SKNMIPSA/IE-TANK-KIT-1/HW/POWER/_DOCUMENTATION/imgs/produkcja_v11_5.jpg

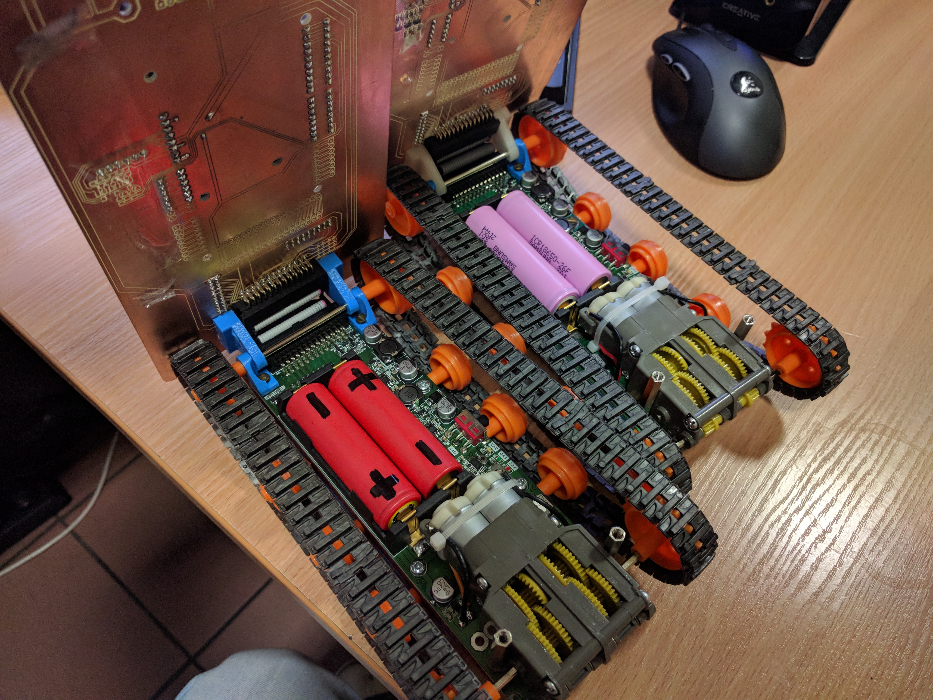
HW/POWER/_DOCUMENTATION/imgs/produkcja_v11_5.jpg
