SKNMIPSA/IE-TANK-KIT-1/HW/POWER/_DOCUMENTATION/imgs/prototyp_v12_2.jpg

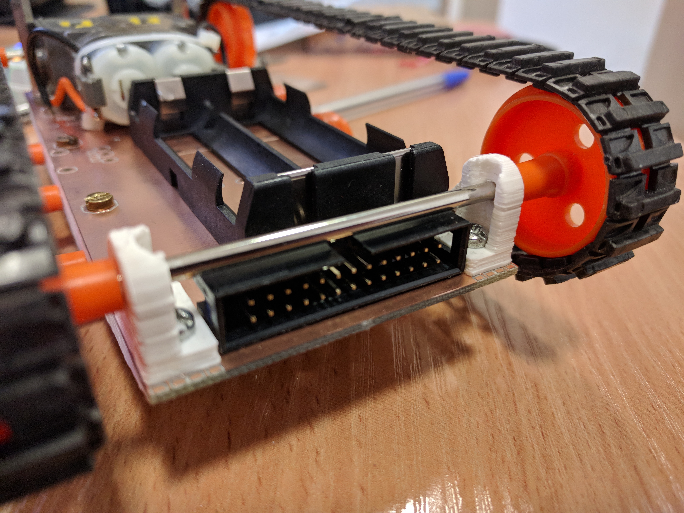
HW/POWER/_DOCUMENTATION/imgs/prototyp_v12_2.jpg
