SKNMIPSA/IE-TANK-KIT-1/HW/POWER/ie-track-kit-pwr-1_v12_fabrication/__info.txt

Płytka dwu warstwowa na FR4 1,5mm, miedź 35um, opis dwuwarstwowy, cynowanie ołowiowe.

Pliki GERBER:
 - warstwa miedzi - top: *.GTL; bottom: *.GBL
 - soldermaski - top: *.GTS, bottom: *.GBS,
 - pady (pasta lutownicza) - top: *.GTP, bottom: *.GBP
 - warstwy opisowe - top: *.GTO, bottom: *.GBO,
 - obrys w pliku *.GM3,
 
Pliki NC Drill:
 - wiercenia: *.TXT.
