SKNMIPSA/IE-TANK-KIT-1/HW/Infrared-Proximity-Sensor-Schematic.pdf

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
D | D
C | C
B | B
A | A

OUT1 1
IN1- 2
IN1+ 3
GND 4 | IN2+ | 5 IN2- | 6 OUT2 | 7 VCC | 8

L1

LM393

100

R1

GND

VCC

GND

VCC

VCC | 1K R5

Led2

VCC | 1K R4

Led1

GND

Switch Indicator

Power Indicator

1
2
3
4

MQ_P1

VCC
GND

DOUT

AOUT

DOUT

R3

VCC

GND

DOUT

AOUT

24K

R2

VCC

GND

Waveshare

Q1

AOUT

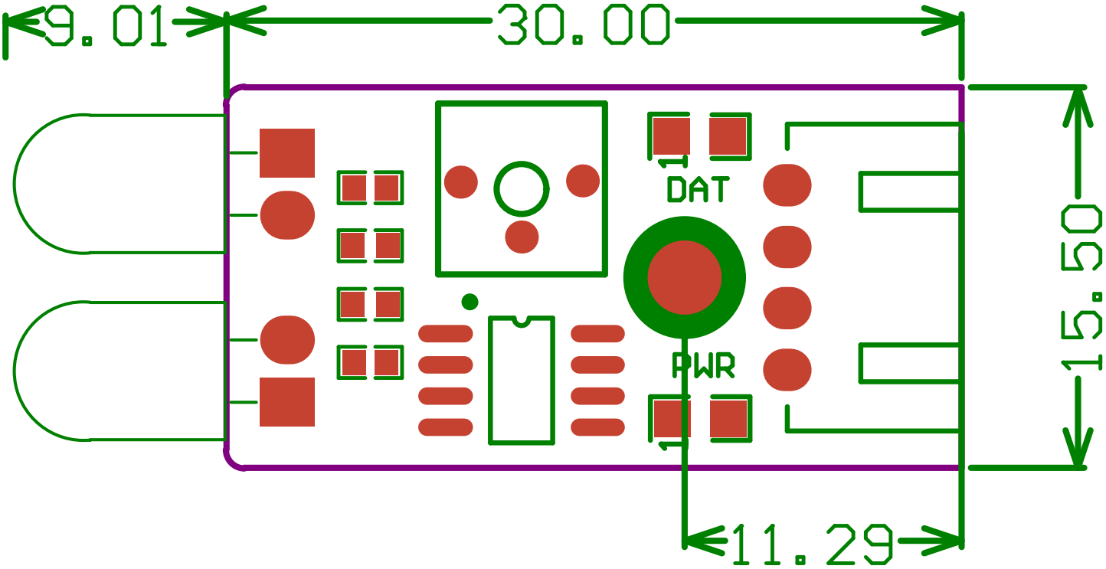
[picture p3: figure]
