SKNMIPSA/IE-TANK-KIT-1/HW/2018-08-09 15.47.45.jpg

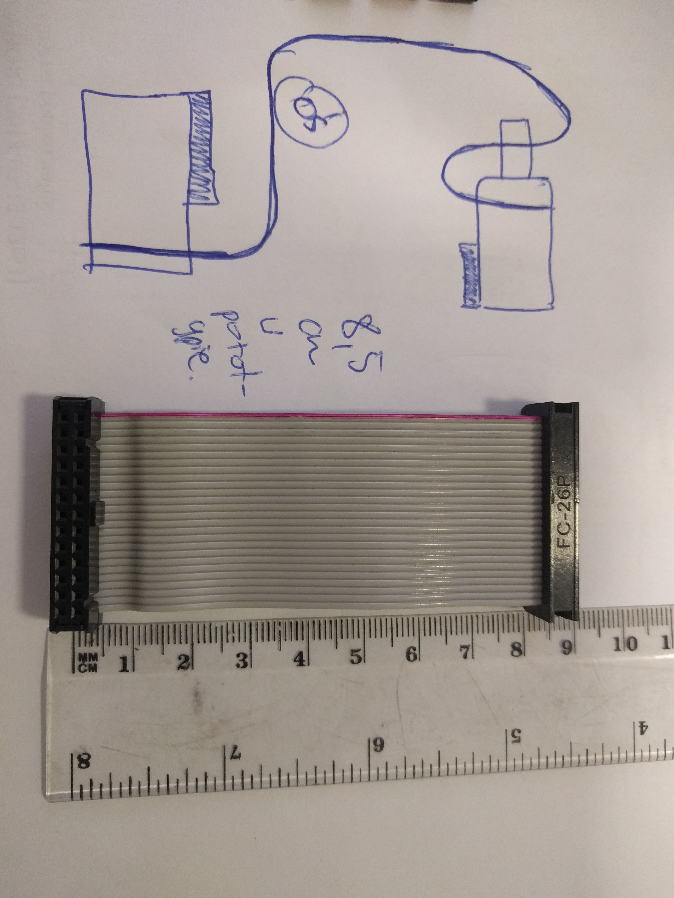
HW/2018-08-09 15.47.45.jpg
