SKNMIPSA/IE-TANK-KIT-1/HW/2018-08-09 15.48.31.jpg

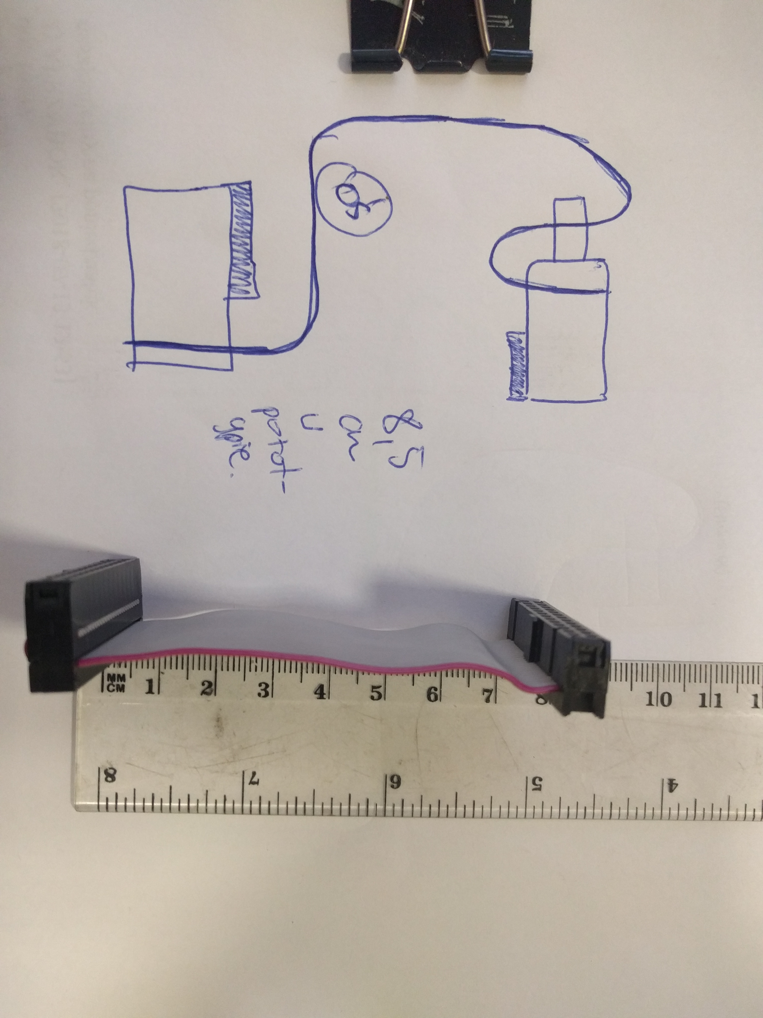
HW/2018-08-09 15.48.31.jpg
