SKNMIPSA/IE-TANK-KIT-1/HW/_RENDERINGS/ie-track-kit-drawing.png

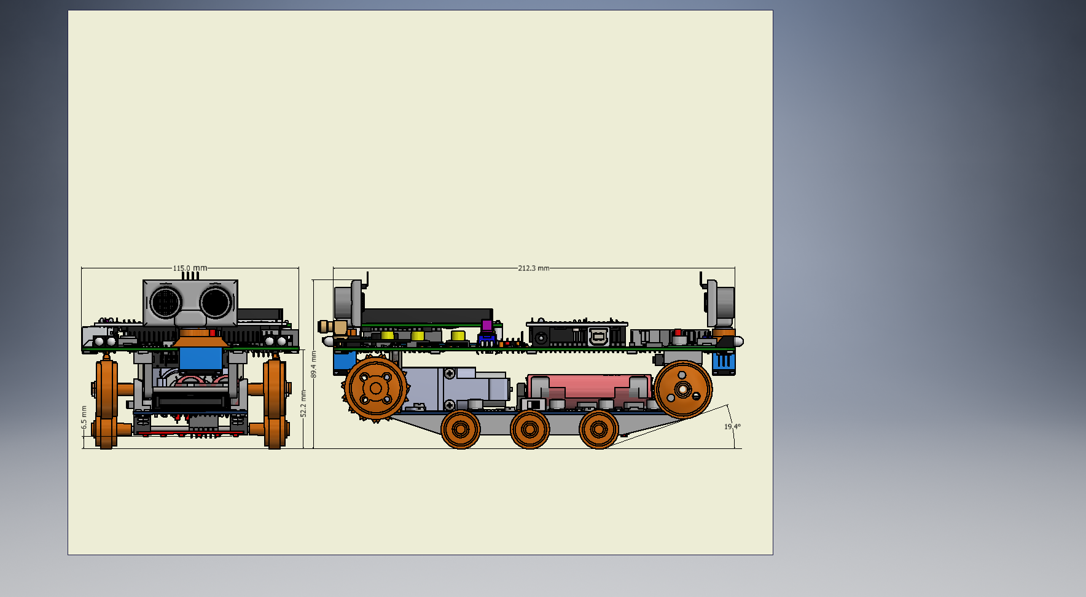
HW/_RENDERINGS/ie-track-kit-drawing.png
