SKNMIPSA/IE-TANK-KIT-1/HW/MAIN/docs/2018-08-02 14.49.41.jpg

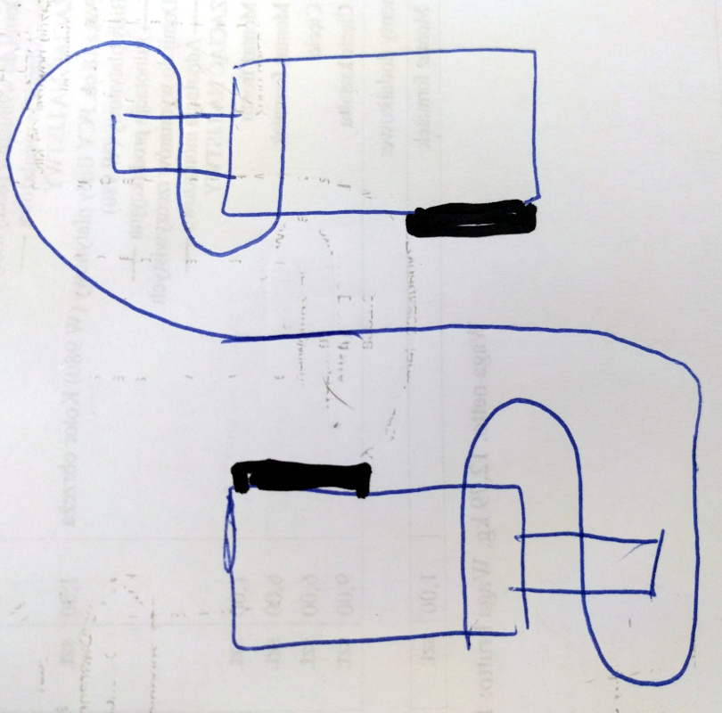
HW/MAIN/docs/2018-08-02 14.49.41.jpg
