SKNMIPSA/IE-TANK-KIT-1/HW/POWER/_DOCUMENTATION/imgs/produkcja_v11_1.jpg

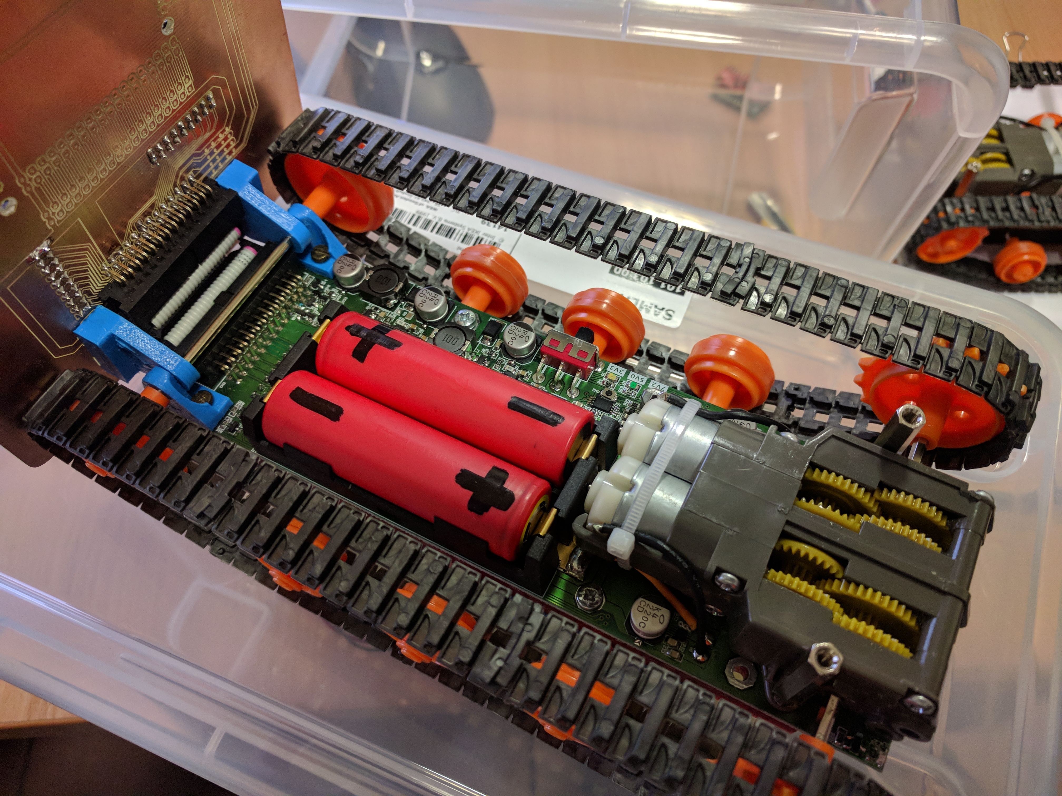
HW/POWER/_DOCUMENTATION/imgs/produkcja_v11_1.jpg
