SKNMIPSA/IE-TANK-KIT-1/HW/POWER/_DOCUMENTATION/imgs/produkcja_v11_3.jpg

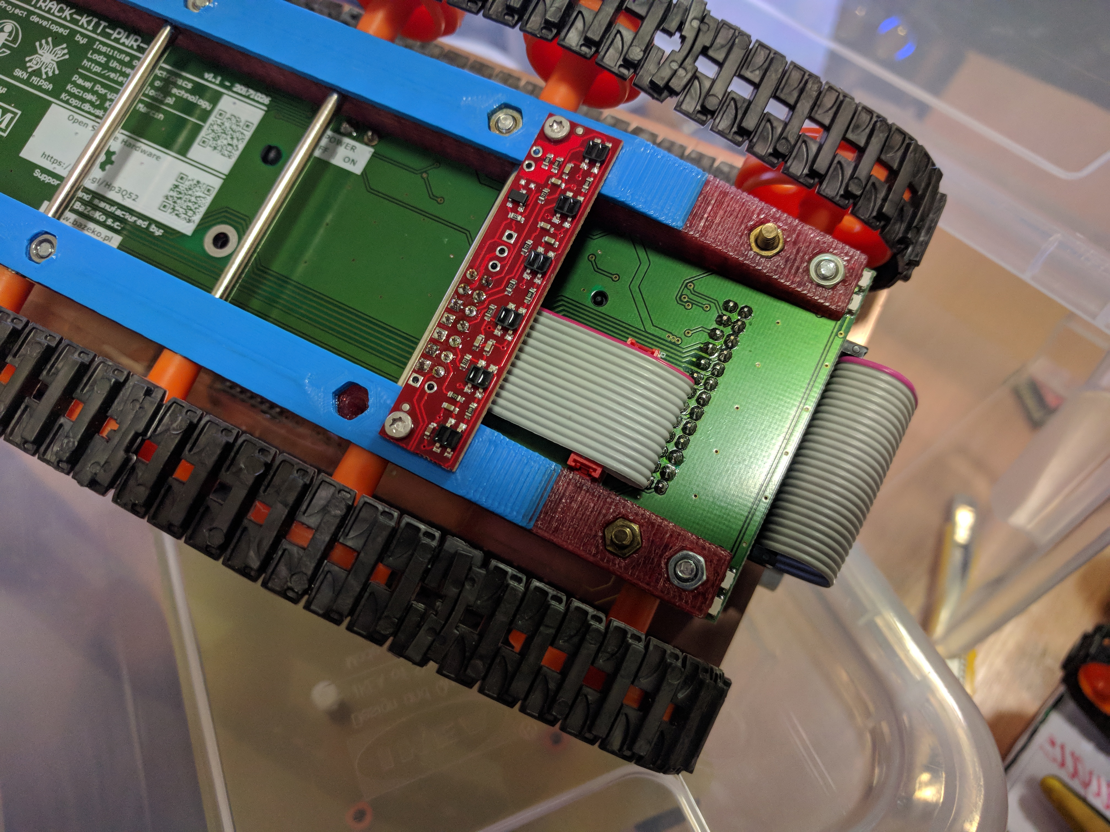
HW/POWER/_DOCUMENTATION/imgs/produkcja_v11_3.jpg
