SKNMIPSA/IE-TANK-KIT-1/HW/POWER/_DOCUMENTATION/imgs/prototyp_v10_3.jpg

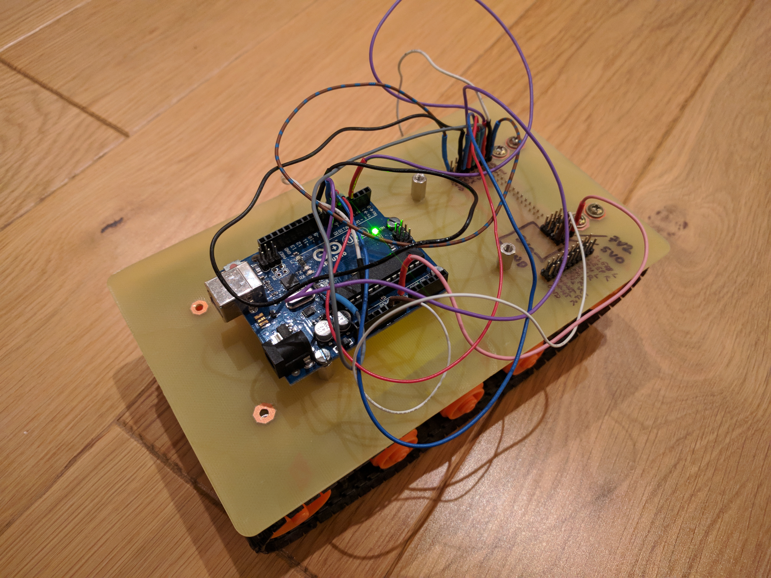
HW/POWER/_DOCUMENTATION/imgs/prototyp_v10_3.jpg
