SKNMIPSA/IE-TANK-KIT-1/HW/MAIN/__PRODUCTION/BOM/ie-track-kit-arduino-1_v11.xls

Designator | Comment | Description | Footprint | LibRef | Quantity
BZ1 | BPT1412XH7.5 | Piezoelectric Sound Transducer: 5Vp-p; 4kHz; O:14mm; with generator | BUZ-13,8-7,6 | BPT1412XH7.5 | 1
C1 | 4,7uF / 6,3V | Capacitor | C0805 | Cap | 1
C2, C3, C4, C5, C6, C7, C8, C9, C10, C11, C12, C13, C14, C15, C16, C17, C18, C19, C20, C21, C29, C30 |  | Capacitor | C0805 | Cap | 22
C22, C23, C24, C25, C26, C33, C34, C35 | 100nF | Capacitor | C0805 | Cap | 8
C27, C28, C31, C32 | 10nF | Capacitor | C0805 | Cap | 4
C36 | 220uF/16V | Polarized Capacitor | CES_E_8.3x8.3_6.2 | Cap Pol | 1
C37 | 100n/50V | Capacitor | C0805 | Cap | 1
C38 | 1u/16V | Capacitor | C0805 | Cap | 1
C39 | 2,2n/50V | Capacitor | C0805 | Cap | 1
C40 | 6,8n/50V | Capacitor | C0805 | Cap | 1
CN1 | AVR JTAG Interface | JTAG Header for AVR MCU's | IDC10 | AVR JTAG Interface | 1
CN2 | AVR ISP Kanda Interface | Kanda ISP Programming Header for AVR MCU's | IDC10 | AVR ISP Kanda Interface | 1
CN3 | AVR ISP Interface | ISP Programming Header for AVR MCU's | IDC6 | AVR ISP Interface | 1
CN4, CN5, CN8, CN9, CN12, CN13 | CN_8x1 |  | GP_8x1 | CN_8x1 | 6
CN6 | CN_6x1 |  | GP_6x1 | CN_6x1 | 1
CN7 | CN_18x2 |  | GP_18x2 | CN_18x2 | 1
CN10, CN11 | CN_10x1 |  | GP_10x1 | CN_10x1 | 2
CN14 | CN_5x1 |  | GP_5x1H_F | CN_5x1 | 1
CN15, CN16, CN17, CN18 | CN_4x2 |  | GP_4x2 | CN_4x2 | 4
CN19 | IDC Connector |  | IDC26_RA_LONG_W_CN | CN_13x2 | 1
D1, D2, D3, D4, D6, D7, D8, D9, D10, D11, D12, D13, D14, D15 | WS2812B | Intelligent control LED integrated light source | WS2812B | WS2812B | 14
D5 | RC1602B-GHY-CSXD | 16x2 LCD Display | RC1602B-GHY-CSXD | RC1602B-GHY-CSXD | 1
D16, D18, D19, D21, D22, D24, D25, D26, D27, D28, D29, D30, D31, D33, D34 | RED | RED LED | LED0805R | LED_RED | 15
D17, D20, D23 | TSHG6210 | IR transmitter; 5mm; 850nm; transparent; 230mW; 10°; THT; 1.5÷1.8V | LED-502 | TSHG6210 | 3
D32 | MBRS140T3G | Schottky barrier rectifier: 40V, 1A | SMB | MBRS140T3G | 1
D35, D37 | GREEN | GREEN LED | LED0805G | LED_GREEN | 2
D36 | LED_YELLOW | YELLOW LED | LED0805Y | LED_YELLOW | 1
L1 | 10uH, 3,45A | 10uH, 20%, 3,45A, PSDB1005N Series Inductor | PSDB1005 | PSDB1005NT100 | 1
M1 | Arduino MEGA Rev3 | Arduino MEGA Rev3 Board | Arduino_MEGA_UPSIDE_DOWN | Arduino MEGA Rev3 | 1
M2 | Arduino UNO Rev3 | Arduino UNO Rev3 Board | Arduino_UNO_UPSIDE_DOWN | Arduino UNO Rev3 | 1
M3 |  |  | HC-SR04 | HC-SR04 | 1
M4 |  |  | HC-SR04_UNIV | HC-SR04_UNIVERSAL | 1
M5 | NRF24L01L | Long Range Wireless Module R2 (1.1KM, PA+SMA) | NRF24L01L | NRF24L01L | 1
P1 | 10k | RK09K113004U | RK09K113004U | RK09K113004U | 1
Q1, Q2, Q3, Q4, Q5, Q6, Q7, Q8, Q9, Q10, Q11, Q12, Q13, Q14, Q16, Q17, Q18, Q22, Q23, Q24, Q25 | BSS138 | N-Channel Enhancement Mode Vertical DMOS FET | SOT-23 | BSS138 | 21
Q15 | KPS-3227SP1C | Photo Transistor 60V 0,1mA 580nm (TME KPS-3227SP1C) | KPS-3227 | KPS-3227SP1C | 1
Q19, Q20, Q21 | BPW96C | Phototransistor; λp max:850nm; 70V; 20°; Lens: transparent; Ø:5mm | LED-502 | BPW96C | 3
Q26 | AO6401A | P-Channel MOSFET; -60V, -5A, 1.3W; | SOT-23-6 | AO6401A | 1
Q27 | BC847BPN | PNP/NPN General Purpose Transistor (VCE=45V, IC=100mA) | SOT-323-6 (SOT-363, SC88, SC70-6) | BC847BPN | 1
R1, R2, R3, R4, R7, R8, R13, R14, R15, R16, R17, R18, R19, R23, R24, R25, R26, R27, R28, R29, R31, R32, R33, R34, R35, R36, R41, R42, R44, R45, R48, R49, R50, R87, R88, R97, R98, R99, R100, R101, R102, R103 | 10k | Resistor | R0805 | Res | 42
R5, R6, R47, R55, R68, R81 | 0R | Resistor | R0805 | Res | 6
R9, R10, R60, R73, R82 | 100k | Resistor | R0805 | Res | 5
R11, R12 | 330R | Resistor | R0805 | Res | 2
R20, R21, R22, R56, R61, R69, R75, R105, R109, R112, R113 | 1k | Resistor | R0805 | Res | 11
R30, R53, R62, R66, R74, R79 | 100R | Resistor | R0805 | Res | 6
R37, R38, R39, R40, R83, R84, R85, R86, R89, R90, R91, R92 | =Value | Resistor | R0805 | Res | 12
R43, R52, R57, R65, R70, R78 |  | 3305SMD-10K | 3305SMD | 3305SMD-10K | 6
R46 | 110R | Resistor | R0805 | Res | 1
R51, R58, R63, R71, R77 | 820R | Resistor | R0805 | Res | 5
R54, R67, R80 | 5k6 | Resistor | R0805 | Res | 3
R59, R72 | 47k | Resistor | R0805 | Res | 2
R64, R76 | 470k | Resistor | R0805 | Res | 2
R93, R94 |  | Isolated Resistor Network - Parts | RPack_0603x4_1206 | Res Pack4_1 | 2
R95 | 39k 1% | Resistor | R0805 | Res | 1
R96 | 36k 1% | Resistor | R0805 | Res | 1
R104 | 0R050 | Resistor | R0805 | Res | 1
R106 | 1k0 1% | Resistor | R0805 | Res | 1
R107 | 22k | Resistor | R0805 | Res | 1
R108 | 1k69 1% | Resistor | R0805 | Res | 1
R110, R114 | 220R | Resistor | R0805 | Res | 2
R111 | 150R | Resistor | R0805 | Res | 1
S1, S2 | HD-1581HB | HD-1581HB Micro Servo | HD-1581HB_VERTICAL_1 | HD-1581HB | 2
S3, S4 | KTIR0711S | SUBMINIATURE, HIGH SENSITIVITY PHOTOINTERRUPTER | KTIR0711S_wide_pads | KTIR0711S | 2
S5 | JS202011SCQN | C&K JS202011SCQN DPDT Switch | JS202011SCQN | JS202011SCQN | 1
SW1 | DTSM-65R | DIPTRONICS Red 6x6mm SMD Tactile SPST-NO Switch | DTSM-65R | DTSM-65R | 1
SW2, SW3, SW4, SW5 | DTSM-25Y | DIPTRONICS Yellow 12x12mm SMD Tactile SPST-NO Switch | DTSM-25Y | DTSM-25Y | 4
T1, T4 |  | Keystone 5000 Test Point (RED) | Keystone_5000_RED | Keystone 5000 Test Point | 2
T2, T5 |  | Keystone 5003 Test Point (ORANGE) | Keystone_5003_ORANGE | Keystone 5003 Test Point | 2
T3, T6 |  | Keystone 5001 Test Point (BLACK) | Keystone_5001_BLACK | Keystone 5001 Test Point | 2
U1 | TSOP31236 | 36kHz IR Receiver Module for Remote Control Systems | TSOP312(4)_H | TSOP31236 | 1
U2 | MCP9701T-E/LT | Low-Power Linear Active Thermistor IC | SOT-323-5 (SOT-353, SC70-5) | MCP9701T-E/LT | 1
U3, U14 | MCP6001T-I/OT | Rail-to-rail, 1MHz, 100uA Op Amp | SOT-23-5 | MCP6001T-I/OT | 2
U4 | AltIMU10v4 | Pololu Gyro, Accelerometer, Compass, and Altimeter (L3GD20H, LSM303D, and LPS25H Carrier) | AltIMU-10 v4_REVERSE | AltIMU10v4 | 1
U5, U12, U13 | MCP23008-E/SO | 8-Bit I/O Expander with Serial Interface I2C, 18-Pin SOIC Package | SO18W | MCP23008-E/SO | 3
U6 | WaveShare_1.3inch_OLED_B | DEP096032B-W OLED Display | WaveShare_1.3INCH_OLED | WaveShare_1.3inch_OLED | 1
U7, U8, U9, U10, U11 | LM393DT | Low power dual voltage comparators | SO8 | LM393DT | 5
U15 | MCP3425A0T-ECH | 16-Bit Analog-to-Digital Converter with I2C Interface and On-Board Reference | SOT-23-6 | MCP3425A0T-ECH | 1
U16 | HC-05 BTM | HC-05 Bluetooth Module | HC-05_H_2 | HC-05_BTM | 1
U17 | NCP3063BDR2G | DC-DC Converter NCP3063BDR2G (Farnell 1547126) | SO8 | NCP3063BDR2G | 1
