SKNMIPSA/IE-TANK-KIT-1/HW/POWER/__PRODUCTION/BOM/ie-track-kit-pwr-1, v1.2.xls

Designator | Comment | Description | Footprint | LibRef | Quantity
1, 2, 3 | Keystone 5000 Test Point (RED) | Keystone 5000 Test Point (RED) | Keystone_5000_RED | Keystone 5000 Test Point | 3
BT1, BT3 | 18650 (2x KEYSTONE 54 Holder) Battery | 18650 (2x KEYSTONE 54 Holder) Battery | KEYSTONE_54_W_18650 | 18650 | 2
C1, C2, C3 | 220nF | Capacitor | C0805 | Cap | 3
C4 | 22u/10V | Capacitor | C0805 | Cap | 1
C5 | 1u/25V | Capacitor | C0805 | Cap | 1
C6, C7, C12, C17, C20 | 220uF/16V | Polarized Capacitor | CES_E_8.3x8.3_6.2 | Cap Pol | 5
C8, C13 | 100n/50V | Capacitor | C0805 | Cap | 2
C9, C14 | 1u/16V | Capacitor | C0805 | Cap | 2
C10, C15 | 2,2n/50V | Capacitor | C0805 | Cap | 2
C11, C16 | 6,8n/50V | Capacitor | C0805 | Cap | 2
C18, C19, C21, C22 | 100nF | Capacitor | C0805 | Cap | 4
CN1 | QTR-8RC_DIRECT | QTR-8RC Reflectance Sensor Array (Pololu item No. 961) | QTR-8RC_SNAPPED_GOLDPIN_VERTICAL | QTR-8RC_DIRECT | 1
CN2 | IDC Connector |  | IDC26_RA_LONG_W_CN | CN_13x2 | 1
D1, D4, D5 | RED | RED LED | LED0805R | LED_RED | 3
D2 | LED_YELLOW | YELLOW LED | LED0805Y | LED_YELLOW | 1
D3, D7 | MBRS140T3G | Schottky barrier rectifier: 40V, 1A | SMB | MBRS140T3G | 2
D6 | GREEN | GREEN LED | LED0805G | LED_GREEN | 1
D8, D9, D10, D11, D12, D13 | KA-2810ASURSK | KA-2810ASURSK | LED2810 | KA-2810ASURSK | 6
D14, D15, D16, D17, D18, D19 | LTW-108DCG-HS10 | LTW-108DCG-HS10 | LED2810 | LTW-108DCG-HS10 | 6
D20, D21, D22, D23 | KA-2810ASESK | KA-2810ASESK | LED2810 | KA-2810ASESK | 4
GND1 | Keystone 5001 Test Point (BLACK) | Keystone 5001 Test Point (BLACK) | Keystone_5001_BLACK | Keystone 5001 Test Point | 1
L1, L2 | 10uH, 3,45A | 10uH, 20%, 3,45A, PSDB1005N Series Inductor | PSDB1005 | PSDB1005NT100 | 2
P1 | 10k | 3364W-1-103E | 3364W | 3364W-1-103E | 1
Q1 | AO8810 | Dual Common Drain N-Channel MOSFET: Vds=20V, Rdson<20mR@4,5V, Id=7A | TSSOP8 | AO8810 | 1
Q2, Q13, Q15, Q17 | IRLML6402 | P-Channel; -20V, -3.7A, 1.3W; HEXFET Power MOS-FET | SOT-23 | IRLML6402 | 4
Q3, Q4 | BC847B | NPN General Purpose Transistor (VCE=45V, IC=100mA, HFE=200-450) | SOT-23 | BC847B | 2
Q5, Q7 | AO6401A | P-Channel MOSFET; -60V, -5A, 1.3W; | SOT-23-6 | AO6401A | 2
Q6, Q8 | BC847BPN | PNP/NPN General Purpose Transistor (VCE=45V, IC=100mA) | SOT-323-6 (SOT-363, SC88, SC70-6) | BC847BPN | 2
Q9, Q10, Q11, Q12 | IRLML0040TRPBF | N-Channel; 40V, 3.6A, 1,25W; HEXFET Power MOS-FET | SOT-23 | IRLML0040TRPBF | 4
Q14, Q16, Q18 | BC857BS | 2xPNP General Purpose Transistor (VCE=-45V, IC=-100mA) | SOT-323-6 (SOT-363, SC88, SC70-6) | BC857BS | 3
R1, R2, R3, R4, R13, R18, R20, R21, R24, R29, R32, R33, R36, R37 | 1k | Resistor | R0805 | Res | 14
R5 | 4M7 | Resistor | R0805 | Res | 1
R6, R11 | 0R | Resistor | R0805 | Res | 2
R7 | 4k7 | Resistor | R0805 | Res | 1
R8 | 560k | Resistor | R0805 | Res | 1
R9 | 100k | Resistor | R0805 | Res | 1
R10 | 470 | Resistor | R0805 | Res | 1
R12, R23 | 0R050 | Resistor | R0805 | Res | 2
R14 | 220R | Resistor | R0805 | Res | 1
R15 | 3k9 1% | Resistor | R0805 | Res | 1
R16 | 0R 1% | Resistor | R0805 | Res | 1
R17, R27 | 22k | Resistor | R0805 | Res | 2
R19 | 2k4 1% | Resistor | R0805 | Res | 1
R22 | 0R | Resistor | R1206 | Res | 1
R25 | 150R | Resistor | R0805 | Res | 1
R26 | 3k0 1% | Resistor | R0805 | Res | 1
R28 | 1k 1% | Resistor | R0805 | Res | 1
R30, R31, R34, R35 | 10R | Resistor | R0805 | Res | 4
R38, R40, R42 | 10k | Resistor | R0805 | Res | 3
R39, R41, R43 | 47k | Resistor | R0805 | Res | 3
SW1 | B3U-1000PM-B | OMRON Ultra-small Tactile Switch - 12V/50mA | B3U-1000PM-B | B3U-1000PM-B | 1
SW2 | SL19123 | Canal Electronic SPDT AC: 3A/250V, DC: 6A/28V | 500SSPxS1M6xEA | SL19123 | 1
U1 | S-8232 | Battery Protection IC For 2-Serial-Cell Pack | TSSOP8 | S-8232 | 1
U2, U3 | NCP3063BDR2G | DC-DC Converter NCP3063BDR2G (Farnell 1547126) | SO8 | NCP3063BDR2G | 2
U4, U5 | DRV8838 | Low-Voltage H-Bridge Driver | WSON8 (DSG8-1600X900TP) | DRV8838 | 2
