SKNMIPSA/IE-TANK-KIT-1/HW/_RENDERINGS/line_sensor/line_sensor.step

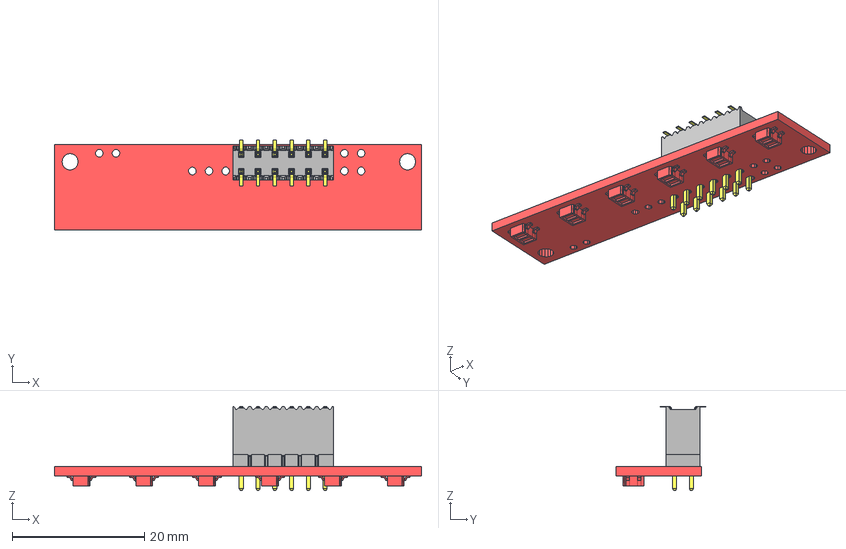
[picture p19: CAD file, 2019-03-20]
HW/_RENDERINGS/line_sensor/line_sensor.step
55.6 x 13.7 x 12.8 mm
_SSM-106-S-DV_body
_C-137-016
Samtec-TSW-106-23-F-D
QTR-8RC_mockup_RGB255
HTST-106-04-G-D-RA
