SKNMIPSA/IE-TANK-KIT-1/MECH/v12/upper_deck_shaft_mount_printing.stl

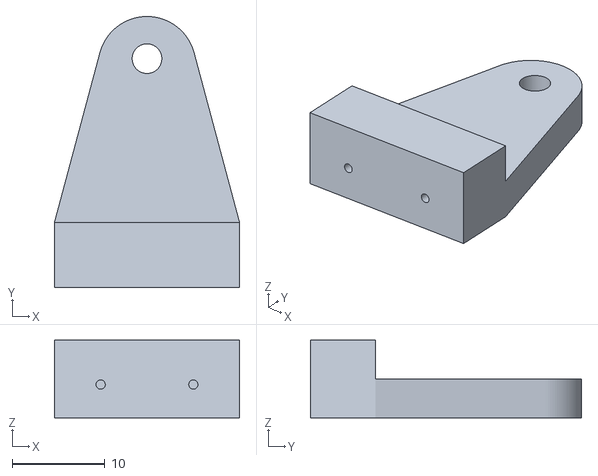
[picture p21: CAD file, 2018-09-11]
MECH/v12/upper_deck_shaft_mount_printing.stl
20.0 x 29.3 x 8.40
