SKNMIPSA/IE-TANK-KIT-1/MECH/wheels/road axle.stp

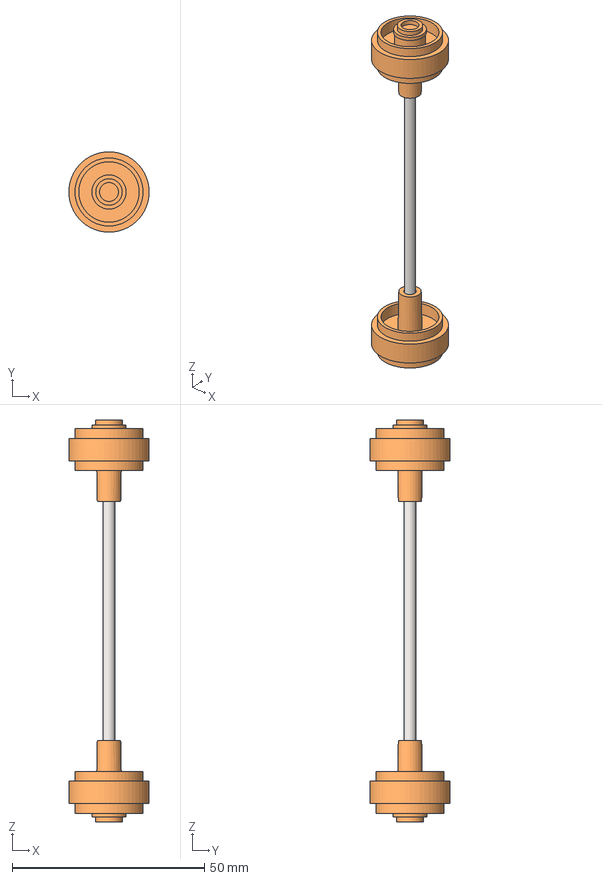
[picture p22: CAD file, 2019-03-15]
MECH/wheels/road axle.stp
20.9 x 20.9 x 104.5 mm
3mm shaft
hub x 2
road wheel x 2
