SKNMIPSA/IE-TANK-KIT-1/MECH/gearbox/Assem1_1-58.stp

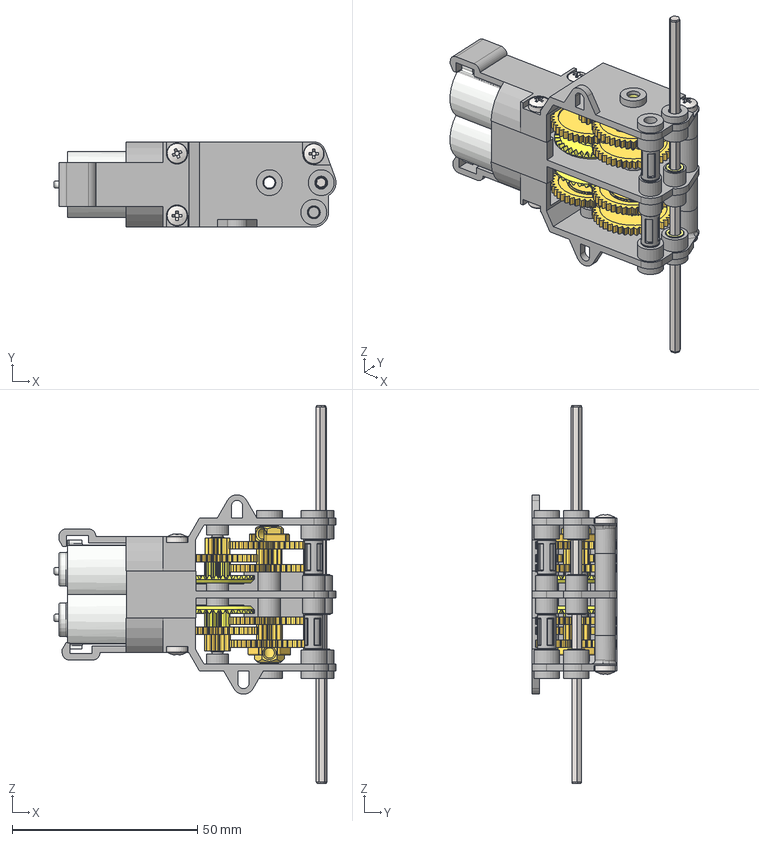
[picture p23: CAD file, 2019-03-15]
MECH/gearbox/Assem1_1-58.stp
76.1 x 23.0 x 102.0 mm
middle
motor x 2
left
right
DG_brass_gap4.0 x 12
DG_gold_brass x 2
DG_purple_8_mtr x 2
DG_shaft_23mm x 2
DG_shaft_50mm x 2
DG_yellow_34_12_N01 x 2
TG_G3 x 2
TG_G2 x 4
middle pin x 2
Pan Head Cross Recess Screw_DIN x 6
