SKNMIPSA/IE-TANK-KIT-1/MECH/v12/hc-sr04_servo_mount.stp

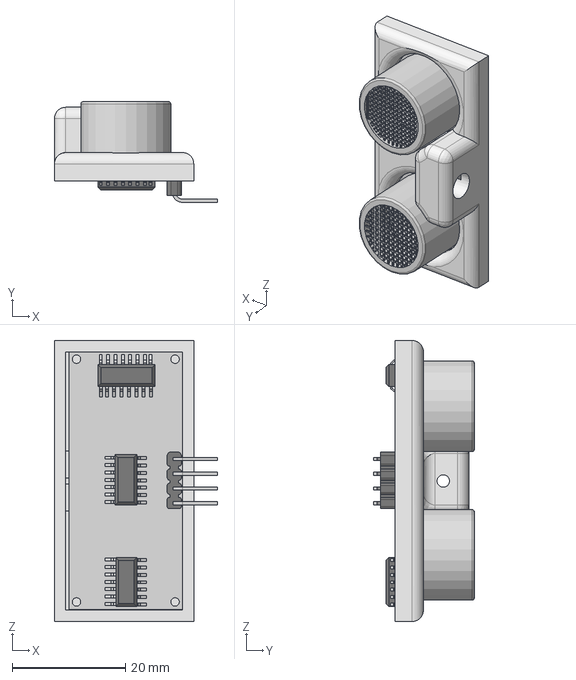
[picture p24: CAD file, 2018-08-19]
MECH/v12/hc-sr04_servo_mount.stp
28.8 x 17.8 x 49.6 mm
HC-SR04-UltrasonicSensor v7
