SKNMIPSA/IE-TANK-KIT-1/MECH/wheels/drive sprocket.stp

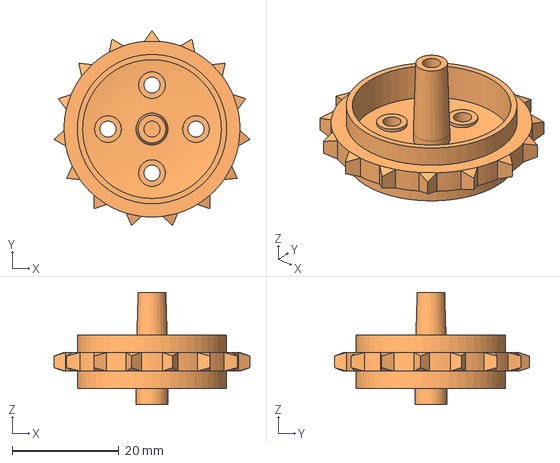
[picture p25: CAD file, 2019-03-15]
MECH/wheels/drive sprocket.stp
36.7 x 36.5 x 21.0 mm
