SKNMIPSA/IE-TANK-KIT-1/MECH/gearbox/middle pin.SLDPRT

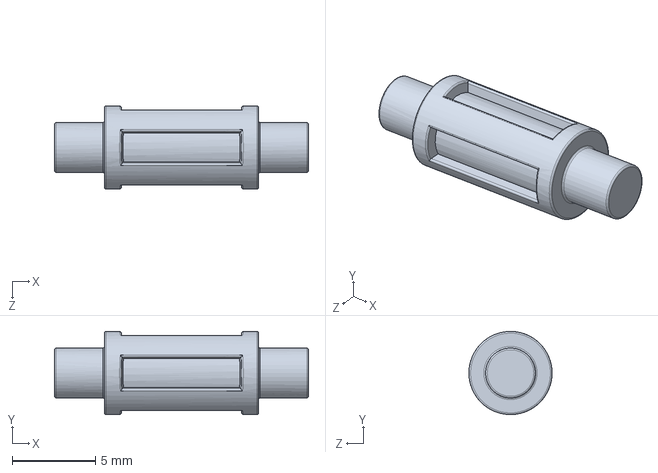
[picture p26: CAD file, 2017-07-28]
MECH/gearbox/middle pin.SLDPRT
15.3 x 5.00 x 5.00 mm
