SKNMIPSA/IE-TANK-KIT-1/MECH/wheels/idler wheel.SLDPRT

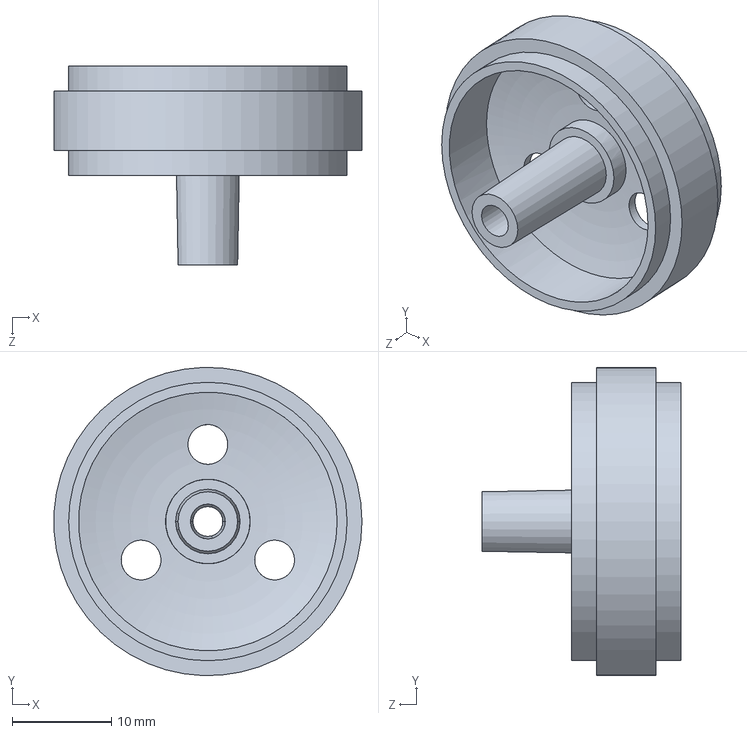
[picture p28: CAD file, 2017-07-28]
MECH/wheels/idler wheel.SLDPRT
31.0 x 31.0 x 20.0 mm
