SKNMIPSA/IE-TANK-KIT-1/MECH/gearbox/motor.SLDPRT

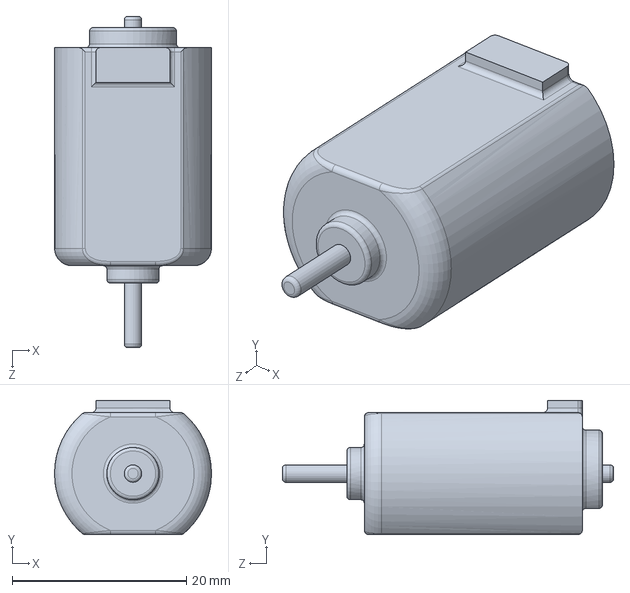
[picture p29: CAD file, 2017-07-28]
MECH/gearbox/motor.SLDPRT
18.0 x 15.4 x 38.0 mm
