SKNMIPSA/IE-TANK-KIT-1/MECH/v12/wheel_support_v5_left_narrow_with_line_sensor_2mm_higher.stl

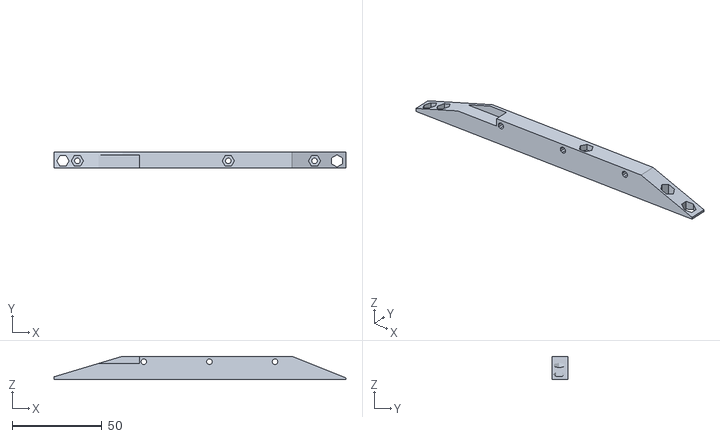
[picture p30: CAD file, 2018-07-10]
MECH/v12/wheel_support_v5_left_narrow_with_line_sensor_2mm_higher.stl
162.5 x 9.00 x 13.0
