SKNMIPSA/IE-TANK-KIT-1/MECH/wheels/road wheel.SLDPRT

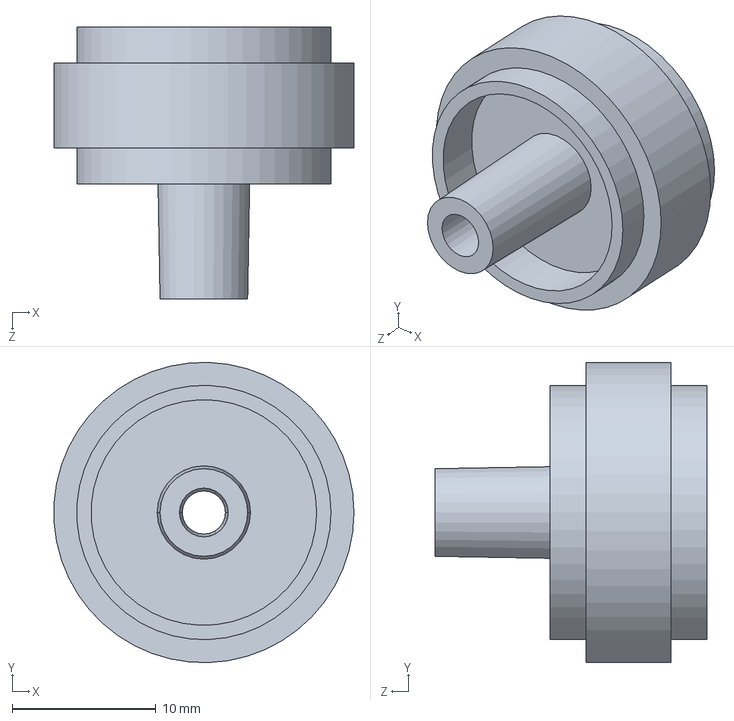
[picture p31: CAD file, 2017-07-28]
MECH/wheels/road wheel.SLDPRT
20.9 x 20.9 x 18.9 mm
