SKNMIPSA/IE-TANK-KIT-1/MECH/gearbox/left.SLDPRT

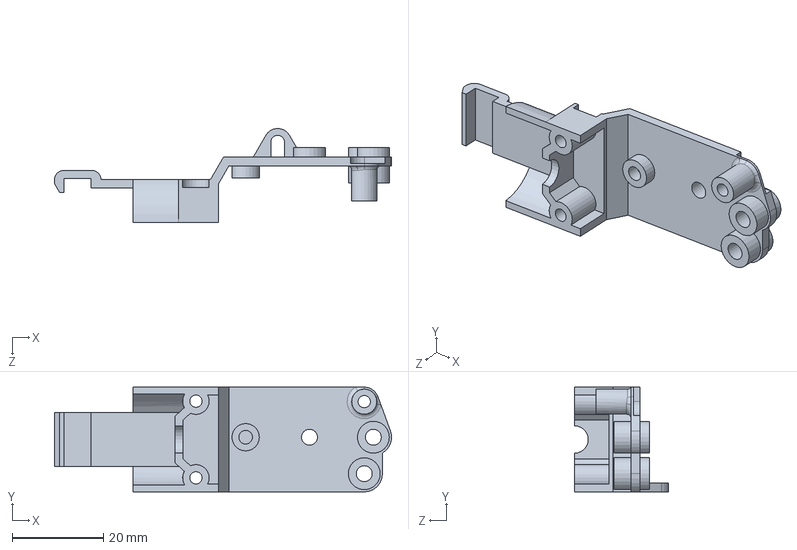
[picture p32: CAD file, 2017-07-28]
MECH/gearbox/left.SLDPRT
73.9 x 23.0 x 20.6 mm
