SKNMIPSA/IE-TANK-KIT-1/MECH/v12/upper_deck_shaft_mount_for_AD.stp

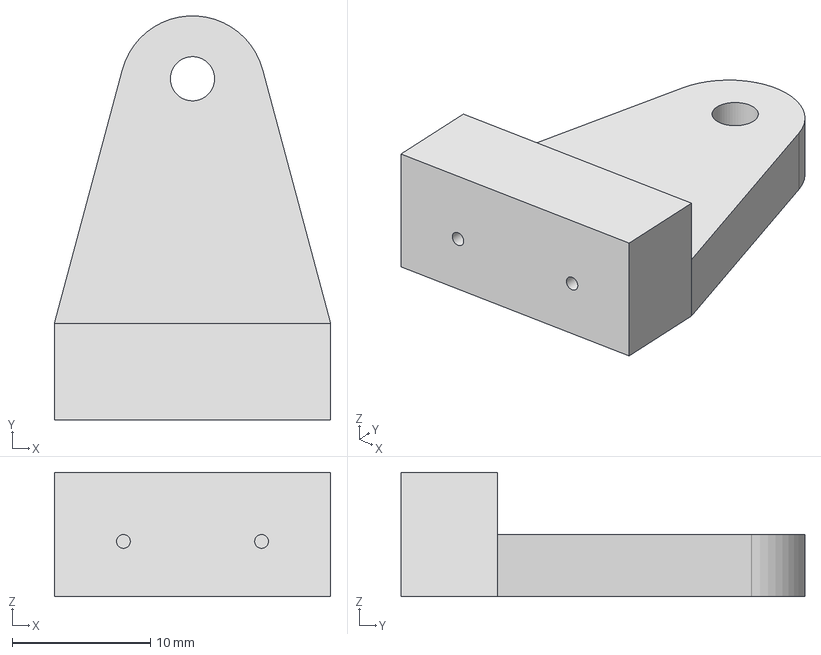
[picture p33: CAD file, 2018-07-10]
MECH/v12/upper_deck_shaft_mount_for_AD.stp
20.0 x 29.2 x 9.00 mm
