SKNMIPSA/IE-TANK-KIT-1/MECH/wheels/3mm shaft.SLDPRT

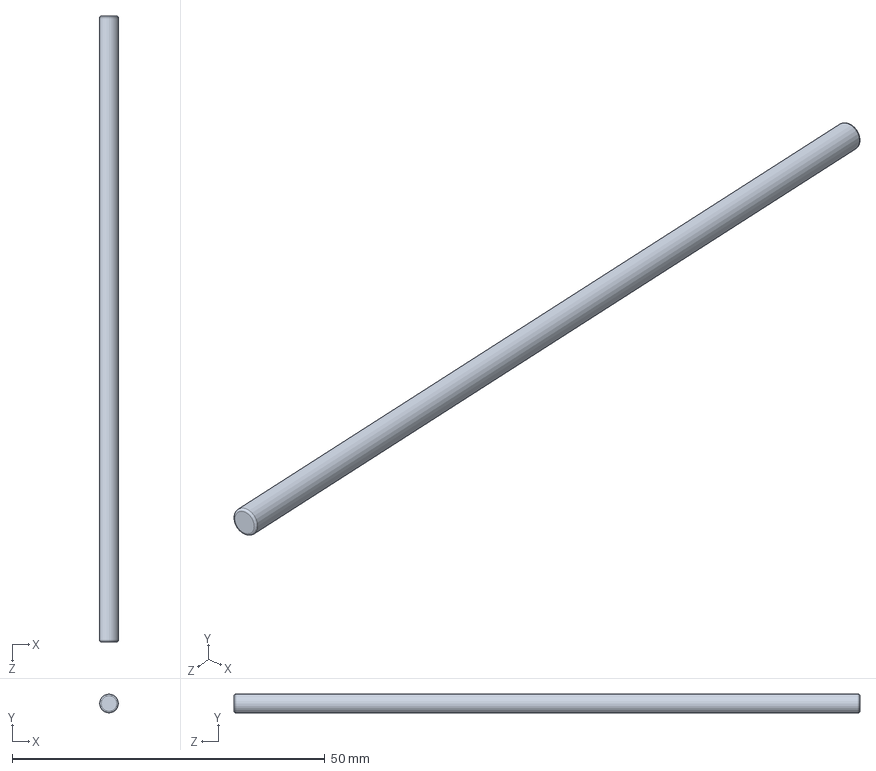
[picture p34: CAD file, 2017-07-28]
MECH/wheels/3mm shaft.SLDPRT
3.00 x 3.00 x 100.0 mm
