SKNMIPSA/IE-TANK-KIT-1/MECH/gearbox/middle.SLDPRT

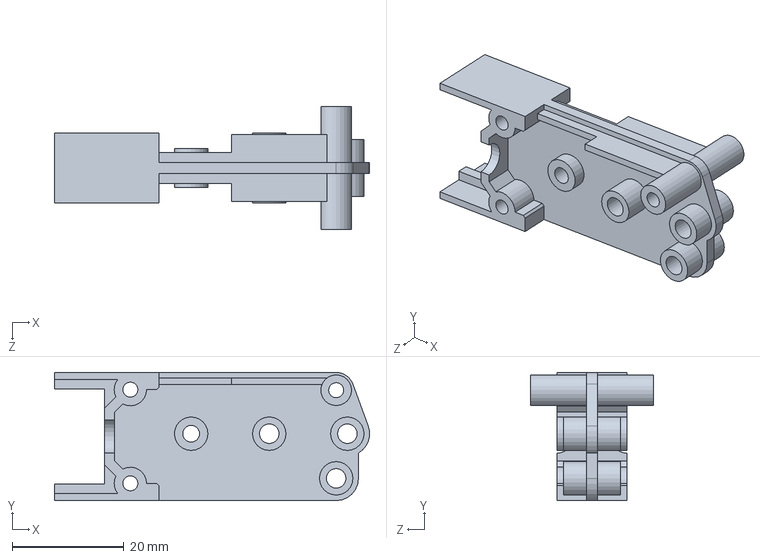
[picture p35: CAD file, 2017-07-28]
MECH/gearbox/middle.SLDPRT
56.5 x 23.0 x 22.0 mm
