SKNMIPSA/IE-TANK-KIT-1/MECH/v12/wheel_support_v5_right_narrow_with_line_sensor.stp

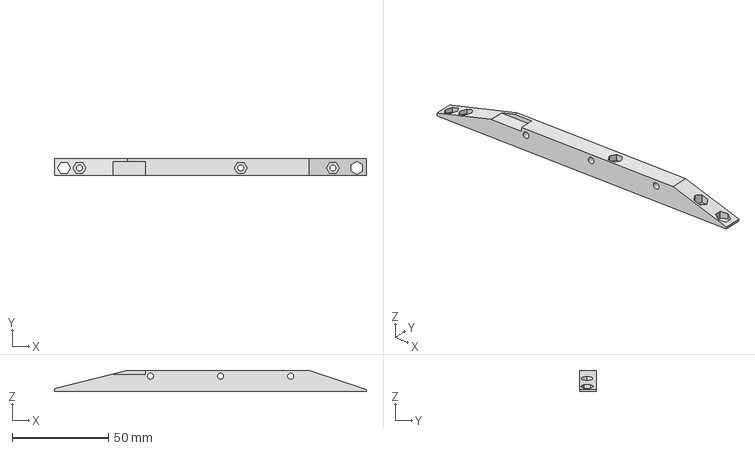
[picture p36: CAD file, 2018-02-13]
MECH/v12/wheel_support_v5_right_narrow_with_line_sensor.stp
162.5 x 9.00 x 11.0 mm
