SKNMIPSA/IE-TANK-KIT-1/MECH/wheels/hub.SLDPRT

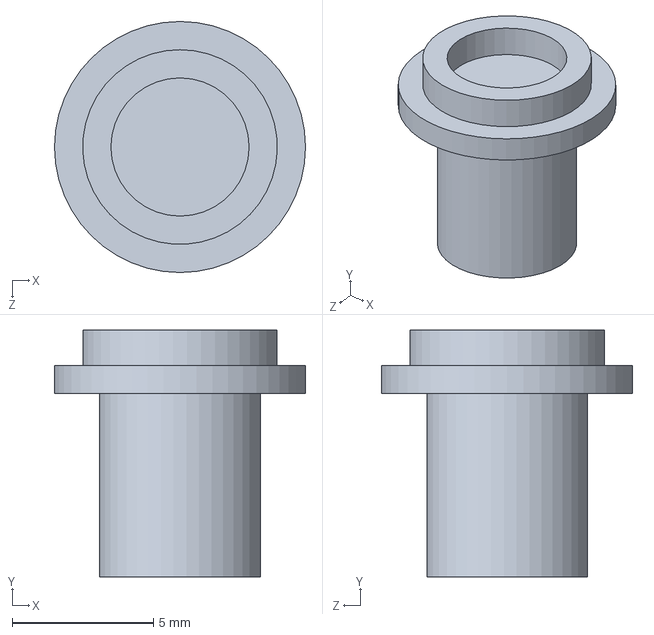
[picture p37: CAD file, 2017-07-28]
MECH/wheels/hub.SLDPRT
8.90 x 8.75 x 8.90 mm
