SKNMIPSA/IE-TANK-KIT-1/MECH/gearbox/DG_gold_brass.SLDPRT

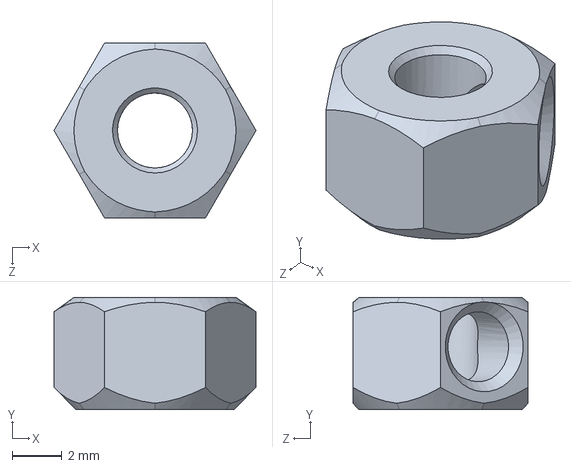
[picture p38: CAD file, 2017-07-28]
MECH/gearbox/DG_gold_brass.SLDPRT
8.08 x 4.50 x 7.00 mm
