SKNMIPSA/IE-TANK-KIT-1/MECH/v12/lower_deck_shaft_mount_v4_printing.stl

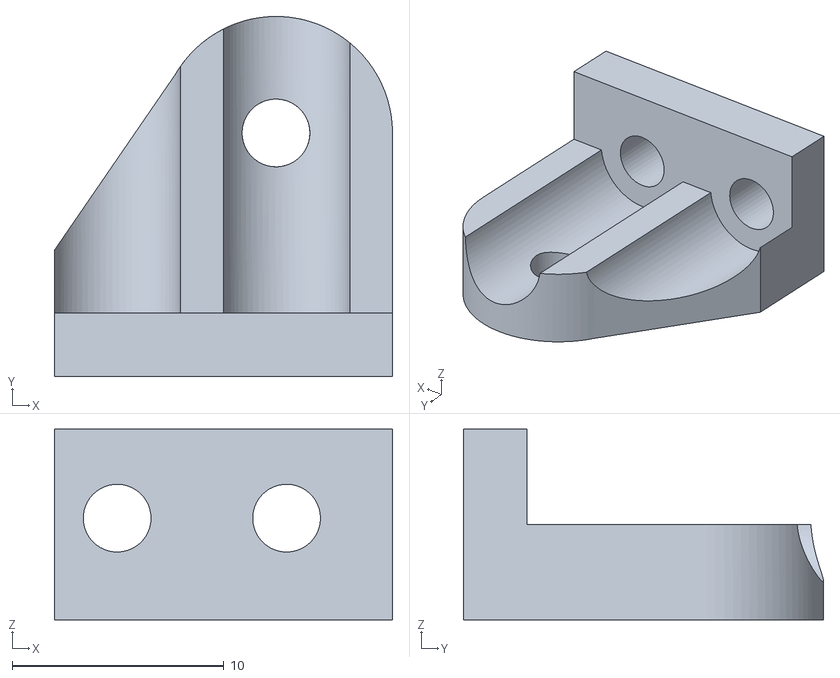
[picture p39: CAD file, 2018-02-13]
MECH/v12/lower_deck_shaft_mount_v4_printing.stl
16.0 x 17.0 x 9.00
