SKNMIPSA/IE-TANK-KIT-1/MECH/gearbox/DG_shaft_50mm.SLDPRT

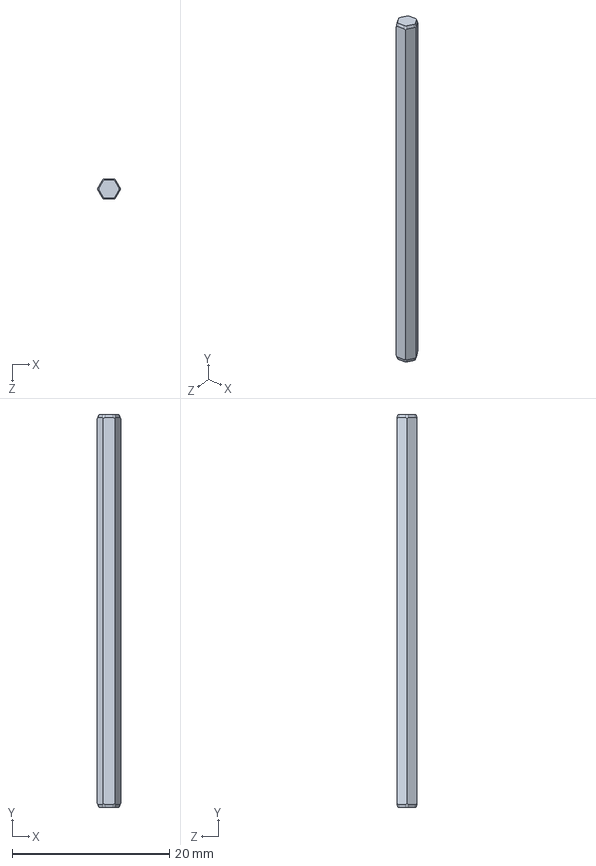
[picture p40: CAD file, 2017-07-28]
MECH/gearbox/DG_shaft_50mm.SLDPRT
3.00 x 50.0 x 2.60 mm
