SKNMIPSA/IE-TANK-KIT-1/MECH/gearbox/DG_shaft_23mm.SLDPRT

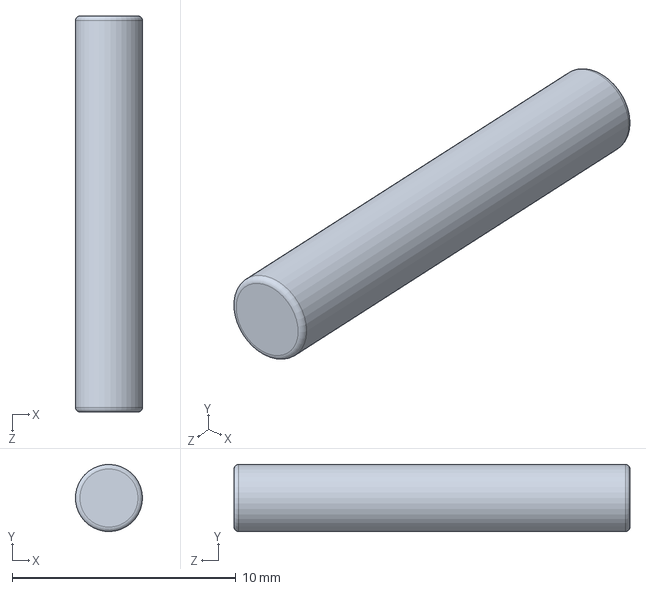
[picture p41: CAD file, 2017-07-28]
MECH/gearbox/DG_shaft_23mm.SLDPRT
2.99 x 3.00 x 17.7 mm
