SKNMIPSA/IE-TANK-KIT-1/MECH/gearbox/DG_yellow_34_12_N01.SLDPRT

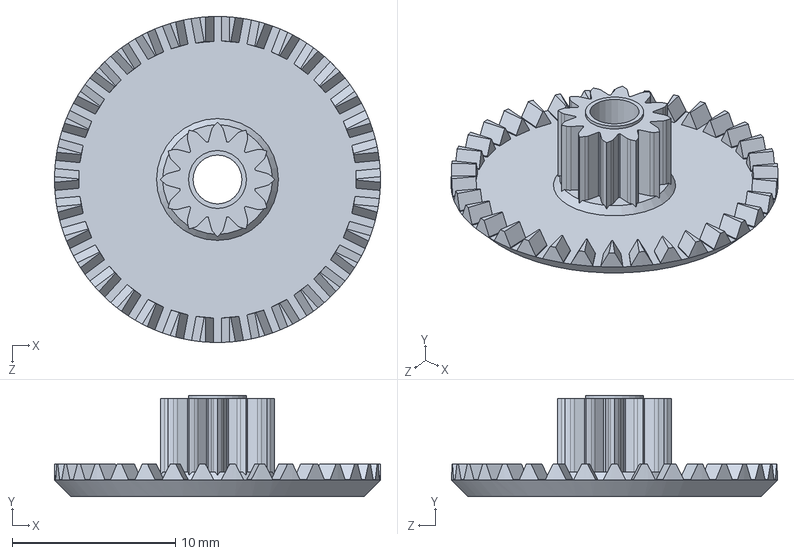
[picture p43: CAD file, 2017-07-28]
MECH/gearbox/DG_yellow_34_12_N01.SLDPRT
20.0 x 6.20 x 20.0 mm
