SKNMIPSA/IE-TANK-KIT-1/MECH/gearbox/TG_G2.SLDPRT

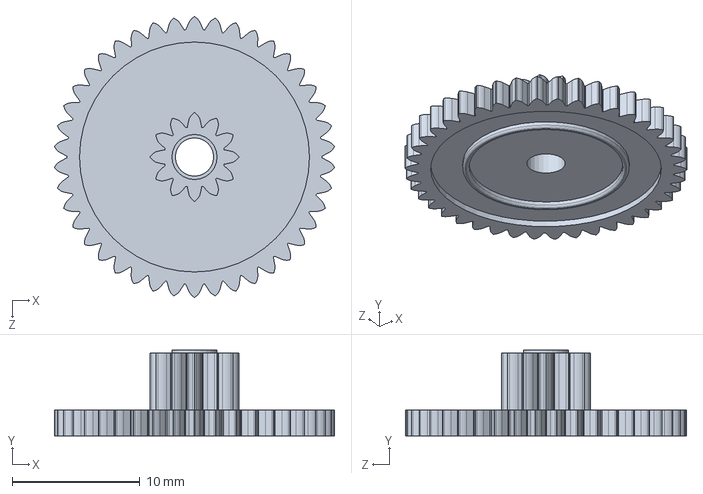
[picture p44: CAD file, 2017-07-28]
MECH/gearbox/TG_G2.SLDPRT
21.9 x 6.70 x 22.0 mm
