SKNMIPSA/IE-TANK-KIT-1/MECH/gearbox/TG_G3.SLDPRT

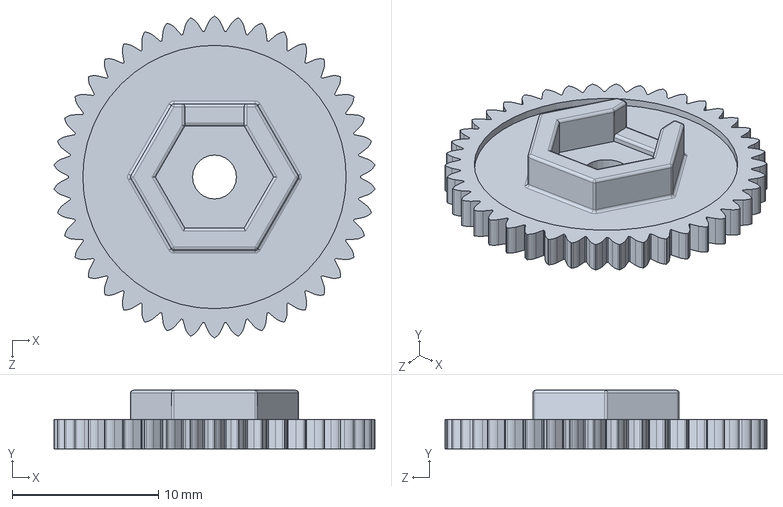
[picture p45: CAD file, 2017-07-28]
MECH/gearbox/TG_G3.SLDPRT
21.9 x 4.00 x 22.0 mm
