SKNMIPSA/IE-TANK-KIT-1/MECH/gearbox/right.SLDPRT

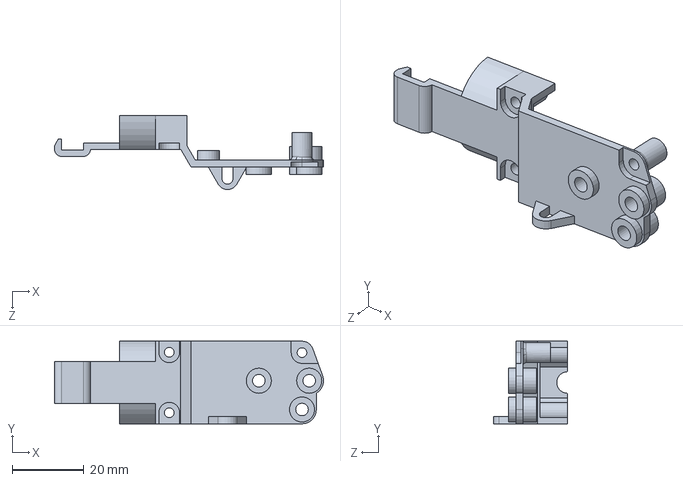
[picture p46: CAD file, 2017-07-28]
MECH/gearbox/right.SLDPRT
74.8 x 23.0 x 20.6 mm
