SKNMIPSA/IE-TANK-KIT-1/MECH/gearbox/DG_purple_8_mtr.SLDPRT

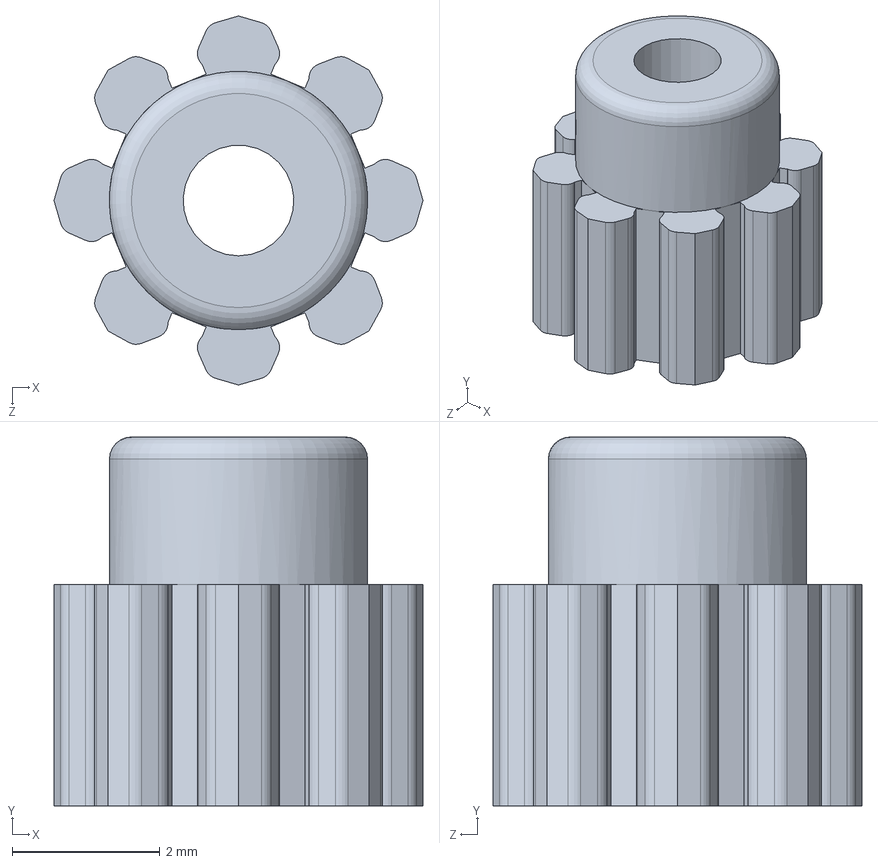
[picture p47: CAD file, 2017-07-28]
MECH/gearbox/DG_purple_8_mtr.SLDPRT
5.00 x 5.00 x 5.00 mm
