SKNMIPSA/IE-TANK-KIT-1/MECH/gearbox/DG_brass_gap4.0.SLDPRT

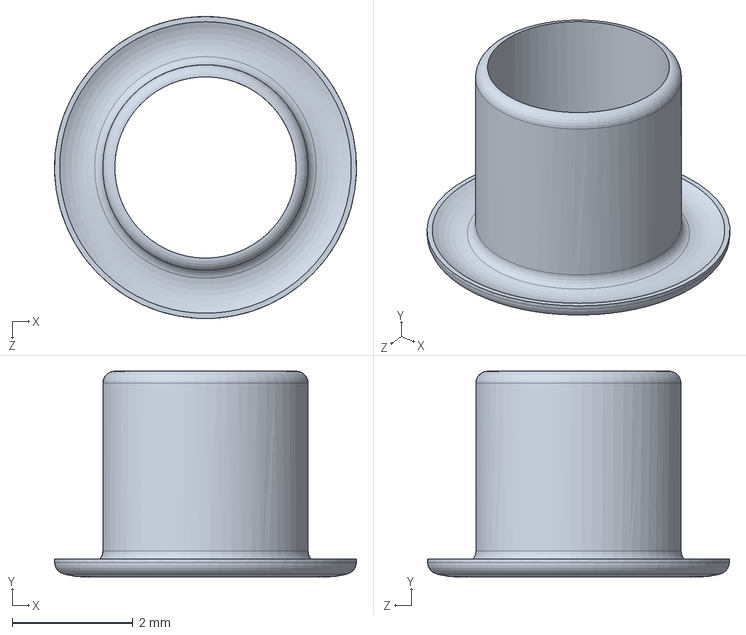
[picture p48: CAD file, 2017-07-28]
MECH/gearbox/DG_brass_gap4.0.SLDPRT
5.00 x 3.41 x 5.00 mm
