SKNMIPSA/IE-TANK-KIT-1/(list of files, cad)

Other CAD files:
MECH/v12/lower_deck_shaft_mount_v4_for_AD.stp
MECH/v12/lower_deck_shaft_mount_v4_for_AD_m.stp
MECH/gearbox/__tamyia_70097_twin_gearbox.stp
HW/_RENDERINGS/1.iam
HW/_RENDERINGS/2.iam
HW/_RENDERINGS/3.iam
HW/_RENDERINGS/3364w-1-103e.ipt
HW/_RENDERINGS/3364w-1-103e_1.ipt
HW/_RENDERINGS/3mm_shaft.ipt
HW/_RENDERINGS/3mm_shaft_1.ipt
HW/_RENDERINGS/500SSPxS1M6xEA.iam
HW/_RENDERINGS/500_ACTUATOR_S1.ipt
HW/_RENDERINGS/500_SSP_BODY.ipt
HW/_RENDERINGS/500_SSP_COVER-2POS.ipt
HW/_RENDERINGS/500_SSP_M6.ipt
HW/_RENDERINGS/500_SSP_M6_SUPPORT.ipt
HW/_RENDERINGS/61202621621.ipt
HW/_RENDERINGS/61202621721_(rev1).iam
HW/_RENDERINGS/6120xx21721_PIN.ipt
HW/_RENDERINGS/6120xx21721_PIN_LONGUE.ipt
HW/_RENDERINGS/7190292864.iam
HW/_RENDERINGS/7369221568.iam
HW/_RENDERINGS/7499033728.iam
HW/_RENDERINGS/Assem1_1-58_wheels.iam
HW/_RENDERINGS/Assembly1.iam
HW/_RENDERINGS/B3U_1000P[]_B.ipt
HW/_RENDERINGS/BT1.iam
HW/_RENDERINGS/BT2.iam
HW/_RENDERINGS/BT3.iam
HW/_RENDERINGS/Board.ipt
HW/_RENDERINGS/C1.iam
HW/_RENDERINGS/C10.iam
HW/_RENDERINGS/C11.iam
HW/_RENDERINGS/C12.iam
HW/_RENDERINGS/C13.iam
HW/_RENDERINGS/C14.iam
HW/_RENDERINGS/C15.iam
HW/_RENDERINGS/C16.iam
HW/_RENDERINGS/C17.iam
HW/_RENDERINGS/C18.iam
HW/_RENDERINGS/C19.iam
HW/_RENDERINGS/C2.iam
HW/_RENDERINGS/C20.iam
HW/_RENDERINGS/C21.iam
HW/_RENDERINGS/C22.iam
HW/_RENDERINGS/C3.iam
HW/_RENDERINGS/C4.iam
HW/_RENDERINGS/C5.iam
HW/_RENDERINGS/C6.iam
HW/_RENDERINGS/C7.iam
HW/_RENDERINGS/C8.iam
HW/_RENDERINGS/C9.iam
HW/_RENDERINGS/CN1.iam
HW/_RENDERINGS/CN2.iam
HW/_RENDERINGS/D1.iam
HW/_RENDERINGS/D10.iam
HW/_RENDERINGS/D11.iam
HW/_RENDERINGS/D12.iam
HW/_RENDERINGS/D13.iam
HW/_RENDERINGS/D14.iam
HW/_RENDERINGS/D15.iam
HW/_RENDERINGS/D16.iam
HW/_RENDERINGS/D17.iam
HW/_RENDERINGS/D18.iam
HW/_RENDERINGS/D19.iam
HW/_RENDERINGS/D2.iam
HW/_RENDERINGS/D20.iam
HW/_RENDERINGS/D21.iam
HW/_RENDERINGS/D22.iam
HW/_RENDERINGS/D23.iam
HW/_RENDERINGS/D3.iam
HW/_RENDERINGS/D4.iam
HW/_RENDERINGS/D5.iam
HW/_RENDERINGS/D6.iam
HW/_RENDERINGS/D7.iam
HW/_RENDERINGS/D8.iam
HW/_RENDERINGS/D9.iam
HW/_RENDERINGS/DG_brass_gap4.0.ipt
HW/_RENDERINGS/DG_gold_brass.ipt
HW/_RENDERINGS/DG_purple_8_mtr.ipt
HW/_RENDERINGS/DG_shaft_23mm.ipt
HW/_RENDERINGS/DG_shaft_50mm.ipt
HW/_RENDERINGS/DG_shaft_50mm_1.ipt
HW/_RENDERINGS/DG_yellow_34_12_N01.ipt
HW/_RENDERINGS/Extruded.ipt
HW/_RENDERINGS/Extruded_1.ipt
HW/_RENDERINGS/Extruded_2.ipt
HW/_RENDERINGS/Free-Models.iam
HW/_RENDERINGS/GND1.iam
HW/_RENDERINGS/Geh_X2_00E4_X0_use.ipt
HW/_RENDERINGS/HTST-106-04-G-D-RA.iam
HW/_RENDERINGS/Kabelklemme.ipt
HW/_RENDERINGS/L1.iam
HW/_RENDERINGS/L2.iam
HW/_RENDERINGS/M3x4.ipt
HW/_RENDERINGS/MH10.iam
HW/_RENDERINGS/MH11.iam
HW/_RENDERINGS/MH5.iam
HW/_RENDERINGS/MH6.iam
HW/_RENDERINGS/MH7.iam
HW/_RENDERINGS/MH9.iam
HW/_RENDERINGS/Open CASCADE STEP translator 6.8 6.133.1.44.ipt
HW/_RENDERINGS/P1.iam
HW/_RENDERINGS/Pan_Head_Cross_Recess_Screw_DIN.ipt
HW/_RENDERINGS/Pin.ipt
HW/_RENDERINGS/Q1.iam
HW/_RENDERINGS/Q10.iam
HW/_RENDERINGS/Q11.iam
HW/_RENDERINGS/Q12.iam
HW/_RENDERINGS/Q13.iam
HW/_RENDERINGS/Q14.iam
HW/_RENDERINGS/Q15.iam
HW/_RENDERINGS/Q16.iam
HW/_RENDERINGS/Q17.iam
HW/_RENDERINGS/Q18.iam
HW/_RENDERINGS/Q2.iam
HW/_RENDERINGS/Q3.iam
HW/_RENDERINGS/Q4.iam
HW/_RENDERINGS/Q5.iam
HW/_RENDERINGS/Q6.iam
HW/_RENDERINGS/Q7.iam
HW/_RENDERINGS/Q8.iam
HW/_RENDERINGS/Q9.iam
HW/_RENDERINGS/QTR-8RC_mockup_RGB255.ipt
HW/_RENDERINGS/R1.iam
HW/_RENDERINGS/R10.iam
HW/_RENDERINGS/R11.iam
HW/_RENDERINGS/R12.iam
HW/_RENDERINGS/R13.iam
HW/_RENDERINGS/R14.iam
HW/_RENDERINGS/R15.iam
HW/_RENDERINGS/R16.iam
HW/_RENDERINGS/R17.iam
HW/_RENDERINGS/R18.iam
HW/_RENDERINGS/R19.iam
HW/_RENDERINGS/R2.iam
HW/_RENDERINGS/R20.iam
HW/_RENDERINGS/R21.iam
HW/_RENDERINGS/R22.iam
HW/_RENDERINGS/R23.iam
HW/_RENDERINGS/R24.iam
HW/_RENDERINGS/R25.iam
HW/_RENDERINGS/R26.iam
HW/_RENDERINGS/R27.iam
HW/_RENDERINGS/R28.iam
HW/_RENDERINGS/R29.iam
HW/_RENDERINGS/R3.iam
HW/_RENDERINGS/R30.iam
HW/_RENDERINGS/R31.iam
HW/_RENDERINGS/R32.iam
HW/_RENDERINGS/R33.iam
HW/_RENDERINGS/R34.iam
HW/_RENDERINGS/R35.iam
HW/_RENDERINGS/R36.iam
HW/_RENDERINGS/R37.iam
HW/_RENDERINGS/R38.iam
HW/_RENDERINGS/R39.iam
HW/_RENDERINGS/R4.iam
HW/_RENDERINGS/R40.iam
HW/_RENDERINGS/R41.iam
HW/_RENDERINGS/R42.iam
HW/_RENDERINGS/R43.iam
HW/_RENDERINGS/R5.iam
HW/_RENDERINGS/R6.iam
HW/_RENDERINGS/R7.iam
HW/_RENDERINGS/R8.iam
HW/_RENDERINGS/R9.iam
HW/_RENDERINGS/SSM-106-S-DV.iam
HW/_RENDERINGS/STEP-61202623021-rev1.iam
HW/_RENDERINGS/SW1.iam
HW/_RENDERINGS/SW2.iam
HW/_RENDERINGS/SW3dPS-3-lead_sot23-3.ipt
HW/_RENDERINGS/SW3dPS-DO-214AA_SMB.ipt
HW/_RENDERINGS/SW3dPS-SOIC08-150.ipt
HW/_RENDERINGS/Samtec-TSW-106-23-F-D.ipt
HW/_RENDERINGS/TG_G2.ipt
HW/_RENDERINGS/TG_G3.ipt
HW/_RENDERINGS/U1.iam
HW/_RENDERINGS/U2.iam
HW/_RENDERINGS/U3.iam
HW/_RENDERINGS/U4.iam
HW/_RENDERINGS/U5.iam
HW/_RENDERINGS/User_Library-0805_SMD_Capacitor.ipt
HW/_RENDERINGS/User_Library-0805_SMD_Resistor.ipt
HW/_RENDERINGS/User_Library-1206_SMD_Resistor.ipt
HW/_RENDERINGS/User_Library-18650-1.ipt
HW/_RENDERINGS/User_Library-ALU-E.iam
HW/_RENDERINGS/User_Library-ALU-E_Beschriftung_1.ipt
HW/_RENDERINGS/User_Library-ALU-E_Fuss_1.ipt
HW/_RENDERINGS/User_Library-ALU-E_K_X_F6rper_1.ipt
HW/_RENDERINGS/User_Library-ALU-E_Pins_1.ipt
HW/_RENDERINGS/User_Library-IND_MURATA_MBH10145C.iam
HW/_RENDERINGS/User_Library-IND_MURATA_MBH10145C_srr1206-560yl.iam
HW/_RENDERINGS/User_Library-IND_MURATA_MBH10145C_srr1206-560yl_1.ipt
HW/_RENDERINGS/User_Library-IND_MURATA_MBH10145C_srr1206-560yl_2.ipt
HW/_RENDERINGS/User_Library-JEDEC_MO-153_(TSSOP).ipt
HW/_RENDERINGS/User_Library-Test_Point_Keystone_-_5000_RED.iam
HW/_RENDERINGS/User_Library-Test_Point_Keystone_-_5000_RED_1.ipt
HW/_RENDERINGS/User_Library-Test_Point_Keystone_-_5000_RED_2.ipt
HW/_RENDERINGS/User_Library-Test_Point_Keystone_-_5001_BLACK.iam
HW/_RENDERINGS/User_Library-Test_Point_Keystone_-_5001_BLACK_1.ipt
HW/_RENDERINGS/User_Library-Test_Point_Keystone_-_5001_BLACK_2.ipt
HW/_RENDERINGS/User_Library-led_0805.ipt
HW/_RENDERINGS/User_Library-led_0805_(1).ipt
HW/_RENDERINGS/User_Library-led_0805_3907462150.ipt
HW/_RENDERINGS/User_Library-sot-23-6-2.ipt
HW/_RENDERINGS/User_Library-sot363.ipt
HW/_RENDERINGS/Verschluss.ipt
HW/_RENDERINGS/_C-137-016.ipt
HW/_RENDERINGS/_HTST-106-04-D_header.ipt
HW/_RENDERINGS/_HTST-First_Position_Indicator.ipt
HW/_RENDERINGS/_SSM-106-S-DV_body.ipt
HW/_RENDERINGS/_T-1S6-06-04-D-RA_.ipt
HW/_RENDERINGS/drive_sprocket.ipt
HW/_RENDERINGS/hub.ipt
HW/_RENDERINGS/hub_1.ipt
HW/_RENDERINGS/idler_wheel.ipt
HW/_RENDERINGS/ie-track-kit-drawing.idw
HW/_RENDERINGS/ie-track-kit-pwr-1.iam
HW/_RENDERINGS/keystone-PN1049.ipt
HW/_RENDERINGS/keystone-PN54.ipt
HW/_RENDERINGS/left.ipt
HW/_RENDERINGS/line_sensor/Designator12.iam
HW/_RENDERINGS/line_sensor/QTR-8RC_mockup_RGB255.ipt
HW/_RENDERINGS/line_sensor/SSM-106-S-DV.iam
HW/_RENDERINGS/line_sensor/Samtec-TSW-106-23-F-D.ipt
HW/_RENDERINGS/line_sensor/_C-137-016.ipt
HW/_RENDERINGS/line_sensor/_SSM-106-S-DV_body.ipt
HW/_RENDERINGS/line_sensor/line_sensor.iam
HW/_RENDERINGS/lower_deck_shaft_mount_v4_for_AD.ipt
HW/_RENDERINGS/lower_deck_shaft_mount_v4_for_AD_m.ipt
HW/_RENDERINGS/middle.ipt
HW/_RENDERINGS/middle_pin.ipt
HW/_RENDERINGS/motor.ipt
HW/_RENDERINGS/right.ipt
HW/_RENDERINGS/road_axle.iam
HW/_RENDERINGS/road_wheel.ipt
HW/_RENDERINGS/upper_deck/5050B.ipt
HW/_RENDERINGS/upper_deck/61202621621.ipt
HW/_RENDERINGS/upper_deck/61202621721_(rev1).iam
HW/_RENDERINGS/upper_deck/6120xx21721_PIN.ipt
HW/_RENDERINGS/upper_deck/6120xx21721_PIN_LONGUE.ipt
HW/_RENDERINGS/upper_deck/7817767296.iam
HW/_RENDERINGS/upper_deck/7817767488.iam
HW/_RENDERINGS/upper_deck/7817767680.iam
HW/_RENDERINGS/upper_deck/7817767872.iam
HW/_RENDERINGS/upper_deck/7817768064.iam
HW/_RENDERINGS/upper_deck/7817768256.iam
HW/_RENDERINGS/upper_deck/7817768448.iam
HW/_RENDERINGS/upper_deck/7817768640.iam
HW/_RENDERINGS/upper_deck/7817769024.iam
HW/_RENDERINGS/upper_deck/7817769216.iam
HW/_RENDERINGS/upper_deck/7817769408.iam
HW/_RENDERINGS/upper_deck/7817769600.iam
HW/_RENDERINGS/upper_deck/7817769792.iam
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
