SKNMIPSA/IE-TANK-KIT-1/HW/MAIN/_DOCUMENTATION/ie-track-kit-arduino-1, v1.1.PDF

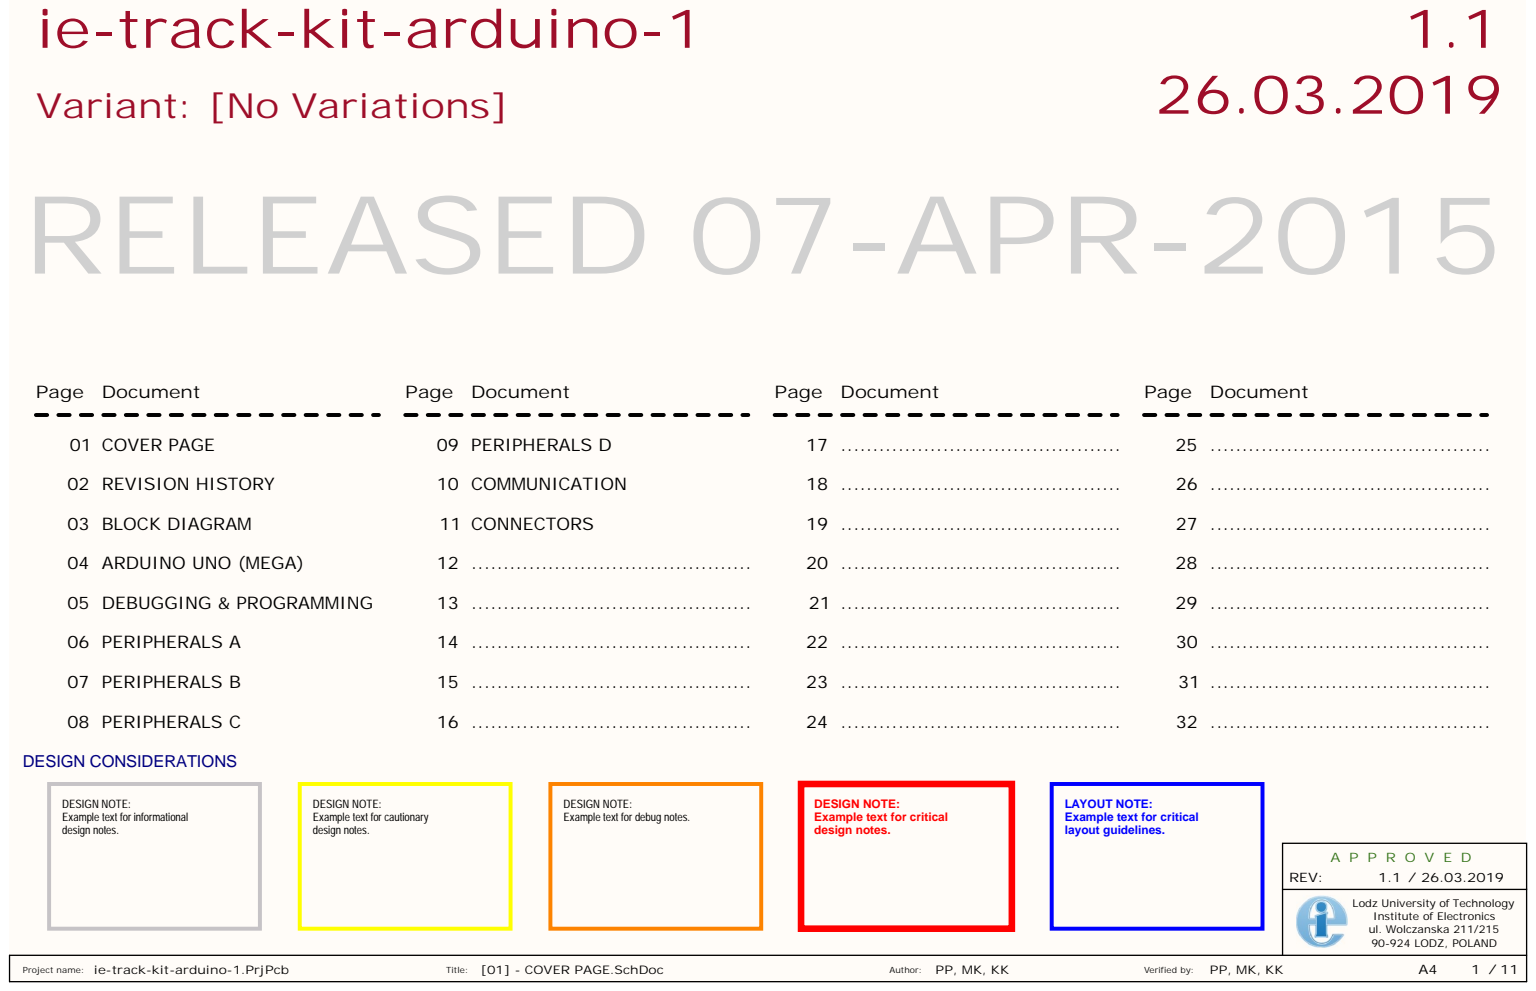
[picture p49: page 1]

ie-track-kit-arduino-1
RELEASED 07-APR-2015

DESIGN NOTE:
Example text for informational
design notes.

Example text for cautionary

Example text for debug notes.

Example text for critical

LAYOUT NOTE:
layout guidelines.

Lodz University of Technology
Institute of Electronics
ul. Wolczanska 211/215
90-924 LODZ, POLAND

1.1 / 26.03.2019

## A P P R O V E D

[02] - REVISION HISTORY.SchDoc | PP, MK, KK | PP, MK, KK | A4 | 2 / 11

### Lodz University of Technology

### ul. Wolczanska 211/215

## REV:

### Institute of Electronics

# REVISION HISTORY

# TODOs, PROPOSALS & IMPROVEMENTS

Rev. | Date
1.0P | PP Author
| 21/08/2018

# Description

Version 1.0: initial prototype (without local iteration, 5 pcs, handled to students as evaluation boards)

# none at the moment

1.1 | 29/10/2018 | PP | Version 1.1: first production run (15 pieces)

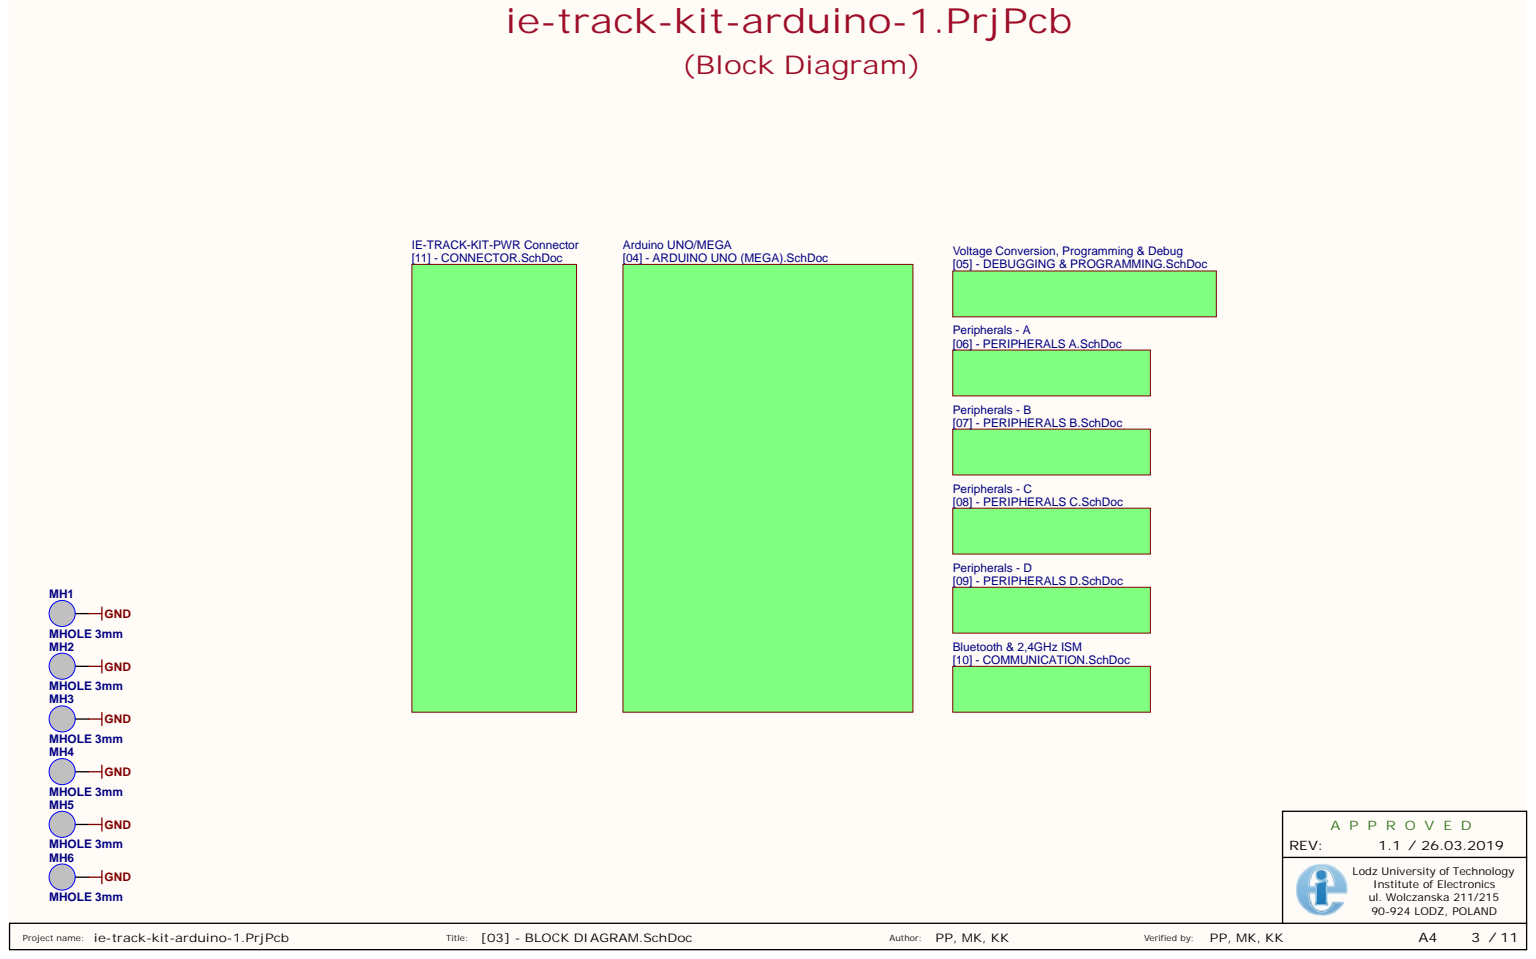
[picture p50: page 3]

ie-track-kit-arduino-1.PrjPcb

IE-TRACK-KIT-PWR Connector
[11] - CONNECTOR.SchDoc

Arduino UNO/MEGA
[04] - ARDUINO UNO (MEGA).SchDoc

Voltage Conversion, Programming & Debug
[05] - DEBUGGING & PROGRAMMING.SchDoc

Lodz University of Technology
Institute of Electronics
ul. Wolczanska 211/215

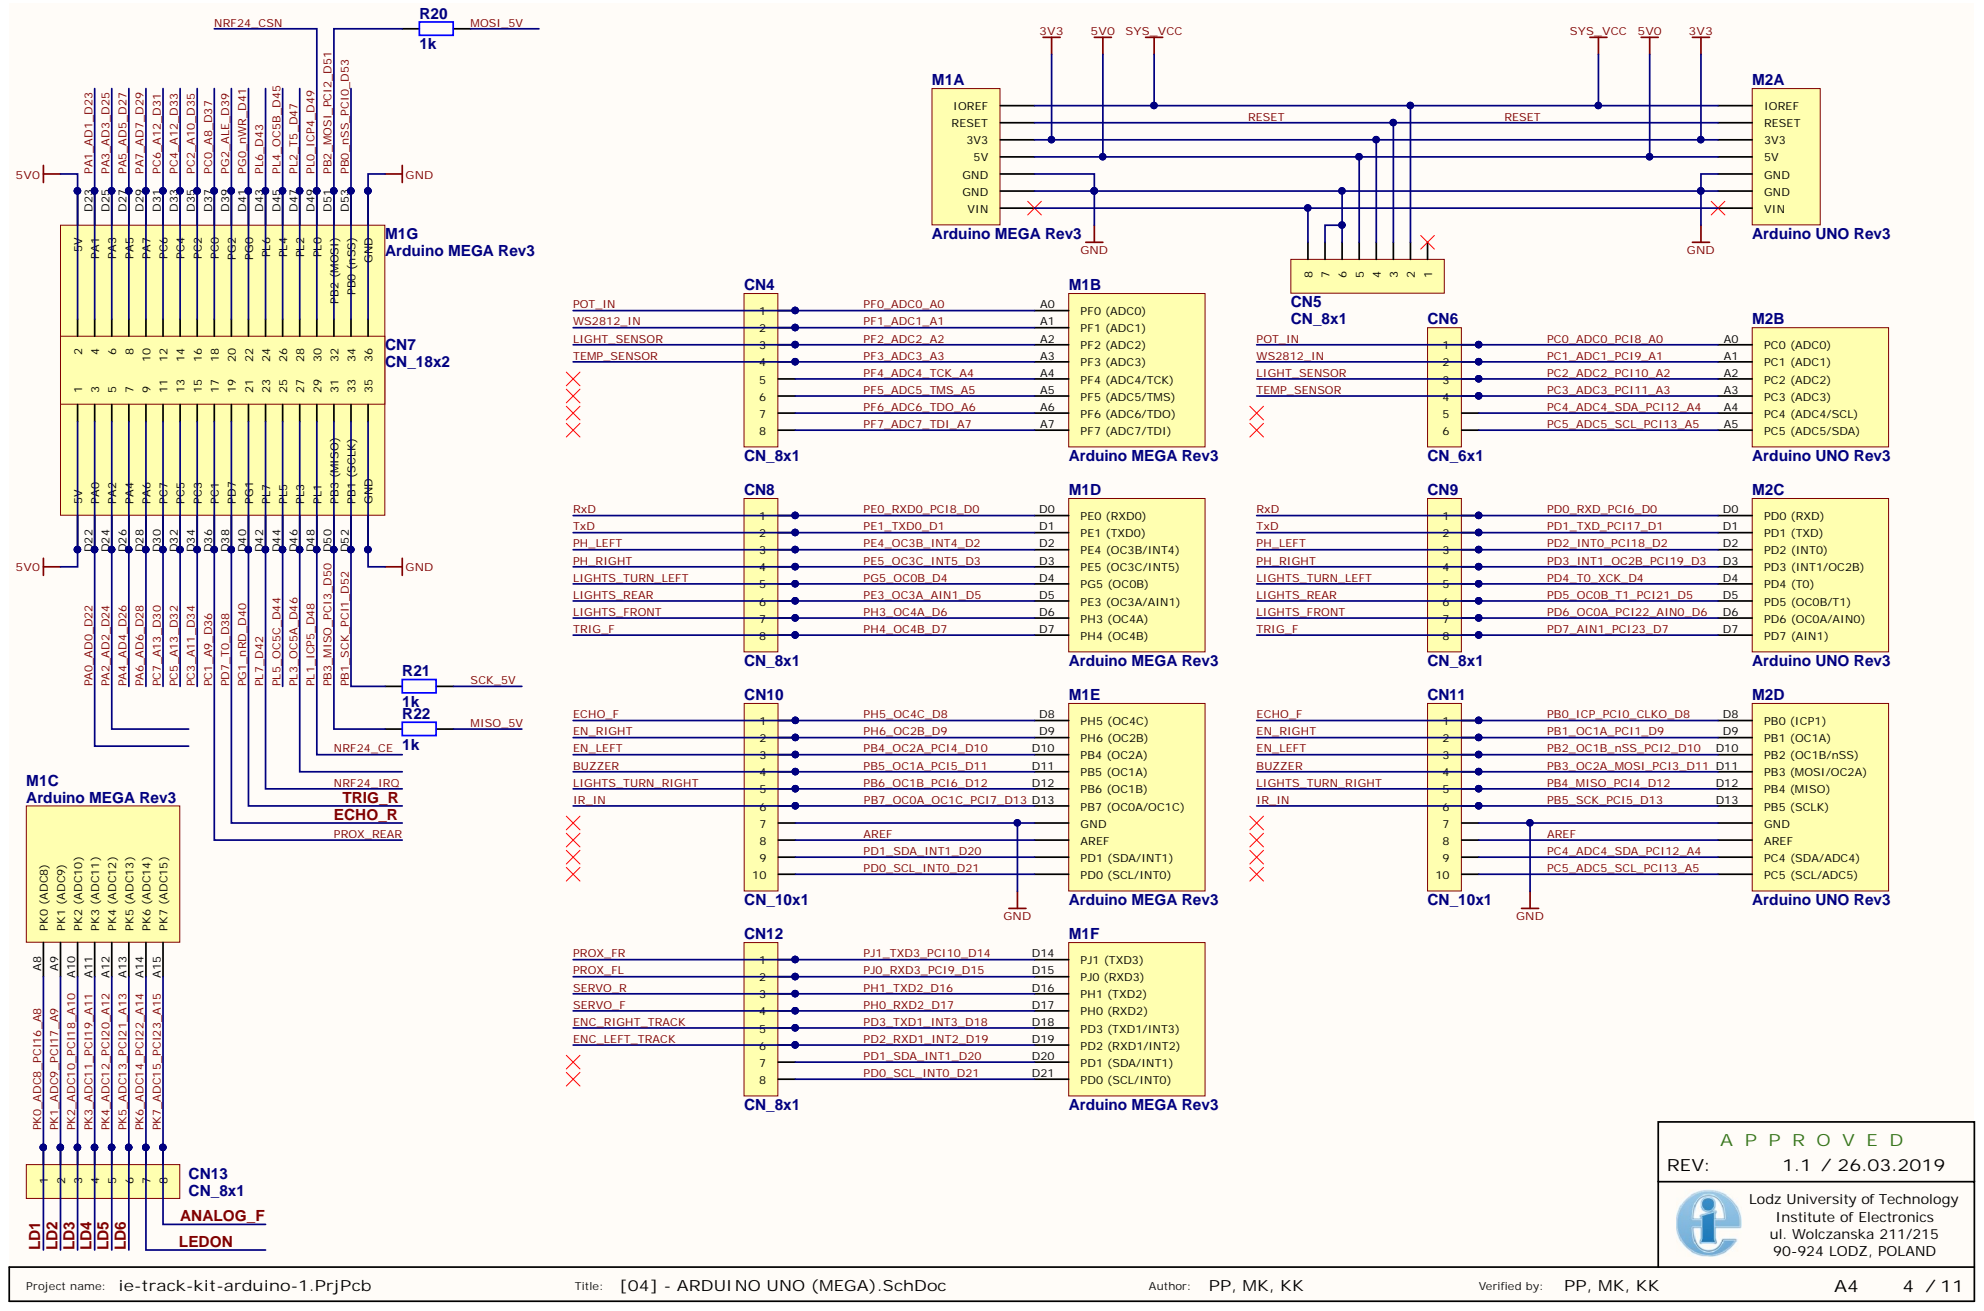
[picture p51: page 4]

Lodz University of Technology
Institute of Electronics
ul. Wolczanska 211/215

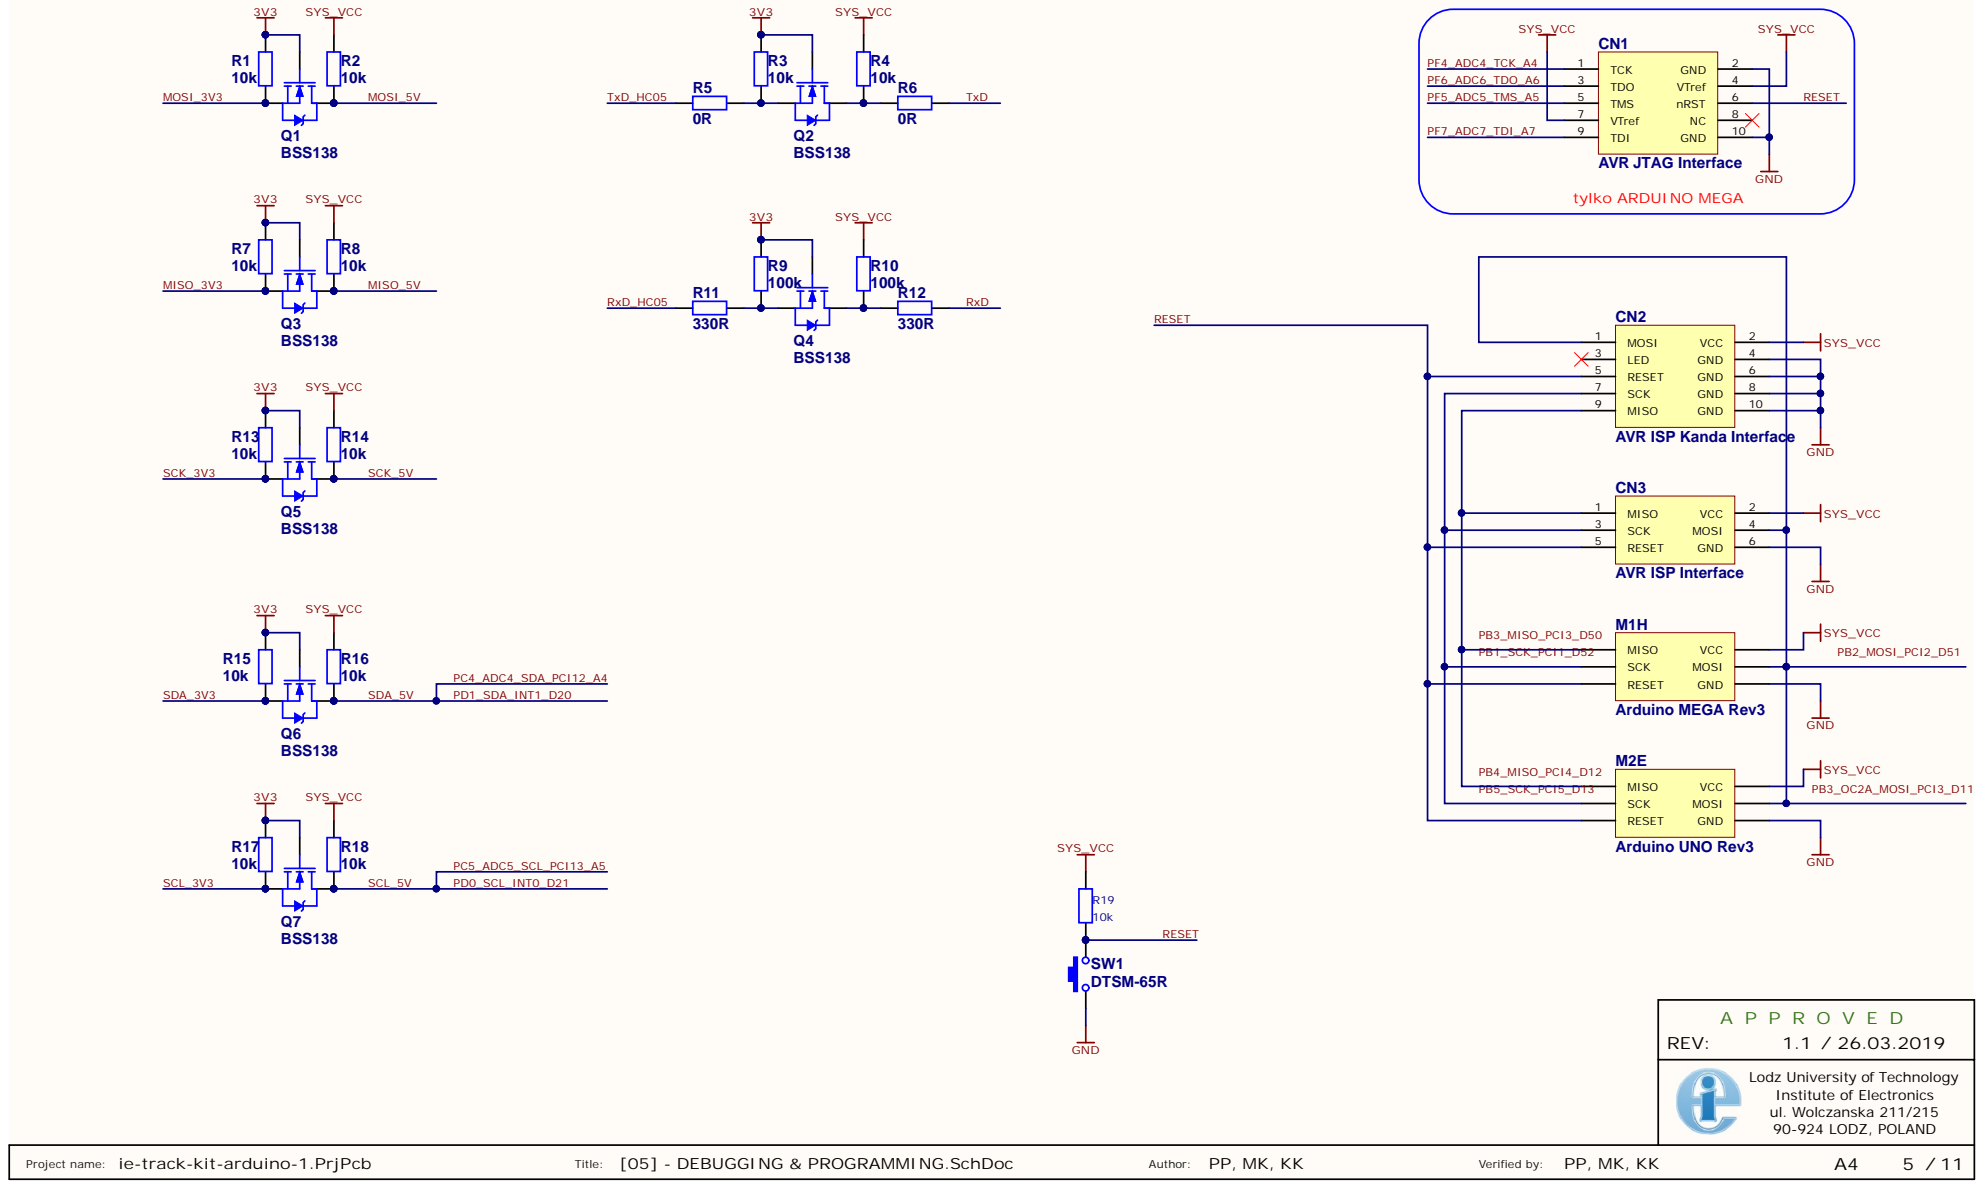
[picture p52: page 5]

AVR ISP Kanda Interface

Lodz University of Technology
Institute of Electronics
ul. Wolczanska 211/215

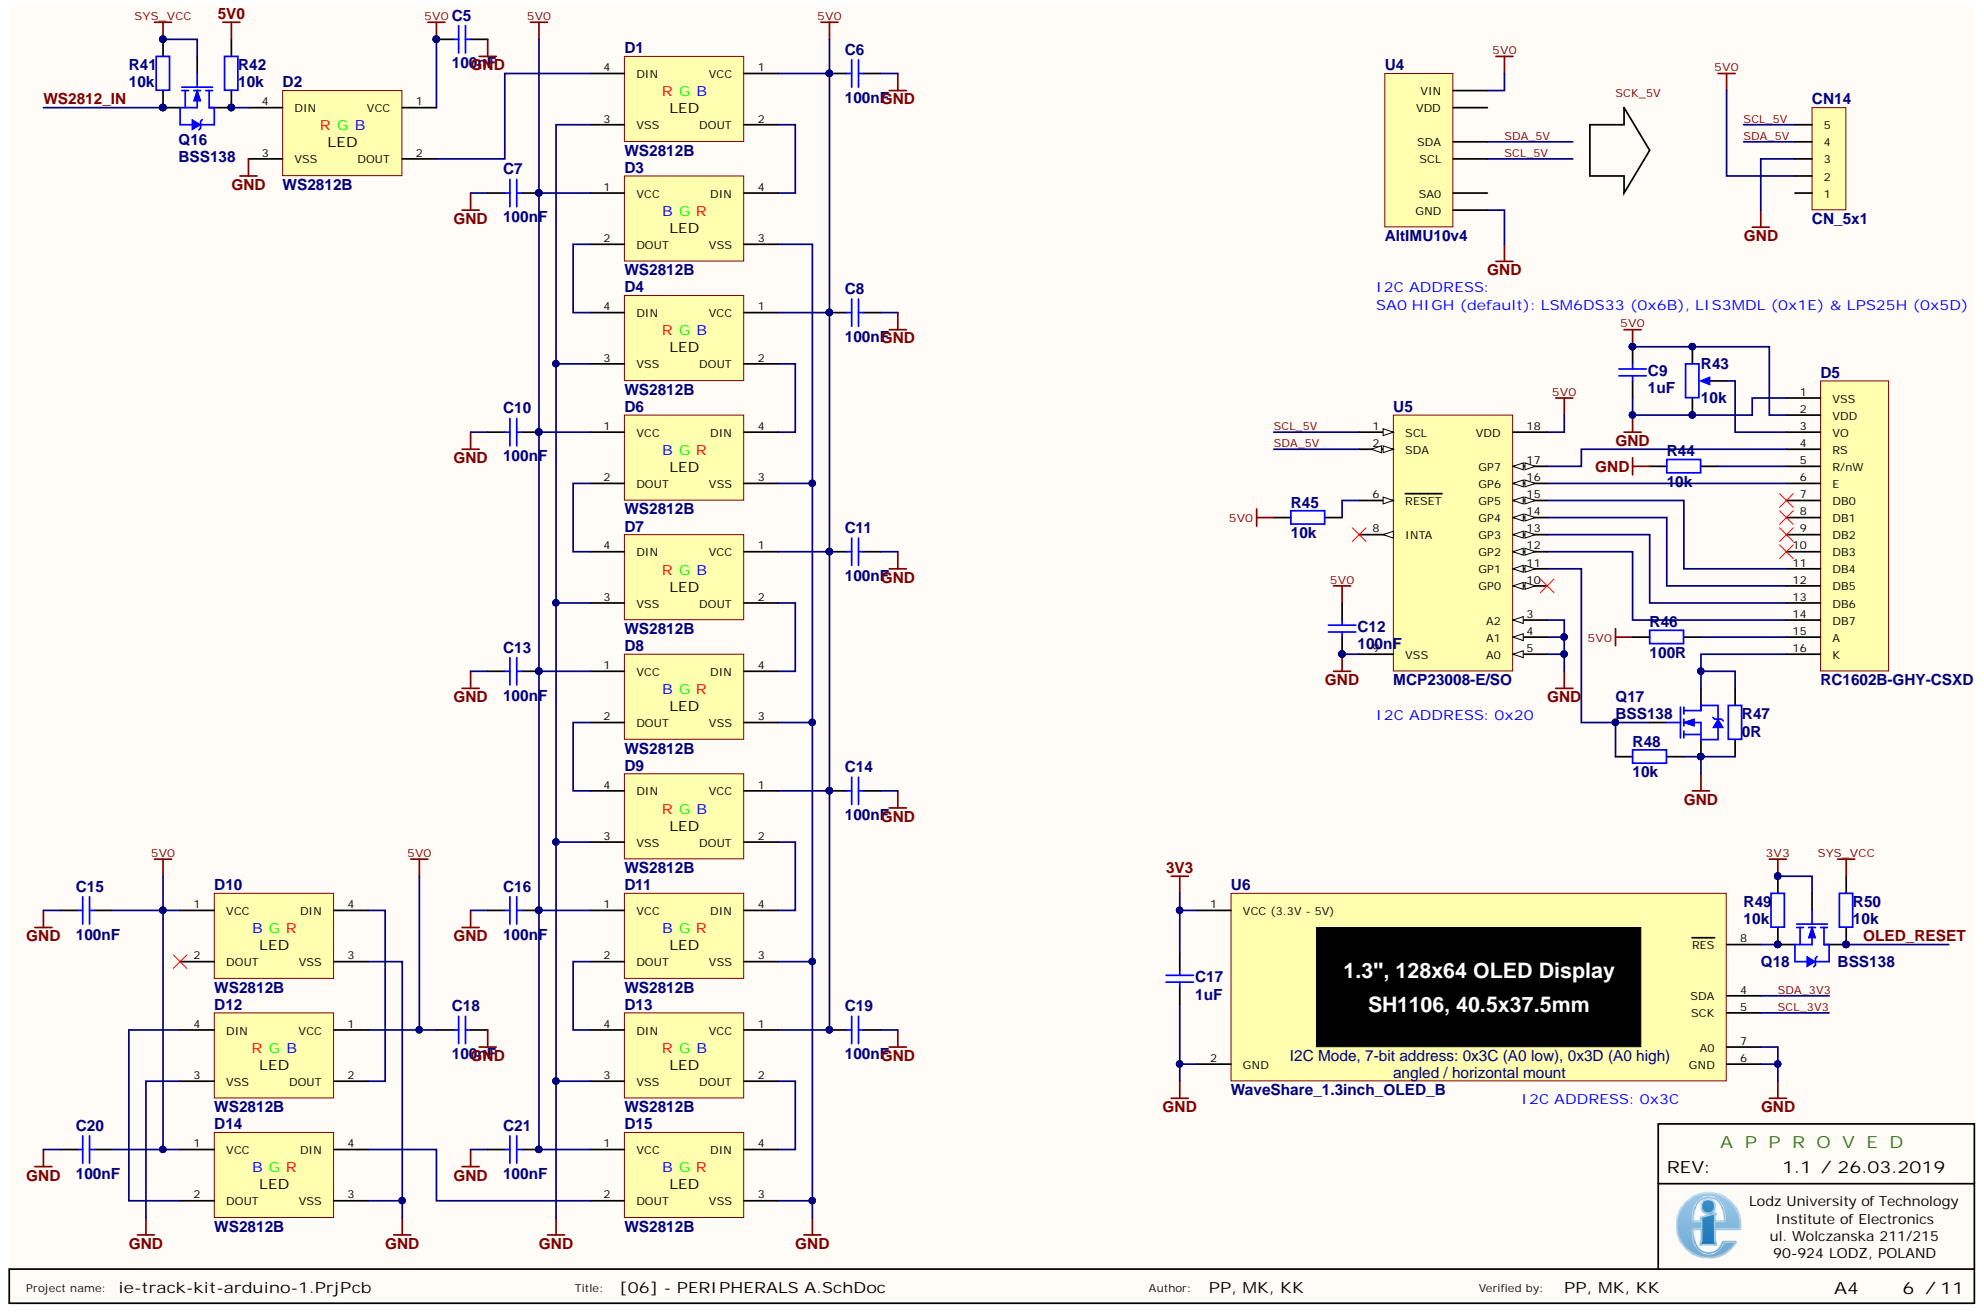
[picture p53: page 6]

DB4 11
DB5 12
DB6 13
DB7 14

I2C Mode, 7-bit address: 0x3C (A0 low), 0x3D (A0 high)

Lodz University of Technology
Institute of Electronics
ul. Wolczanska 211/215

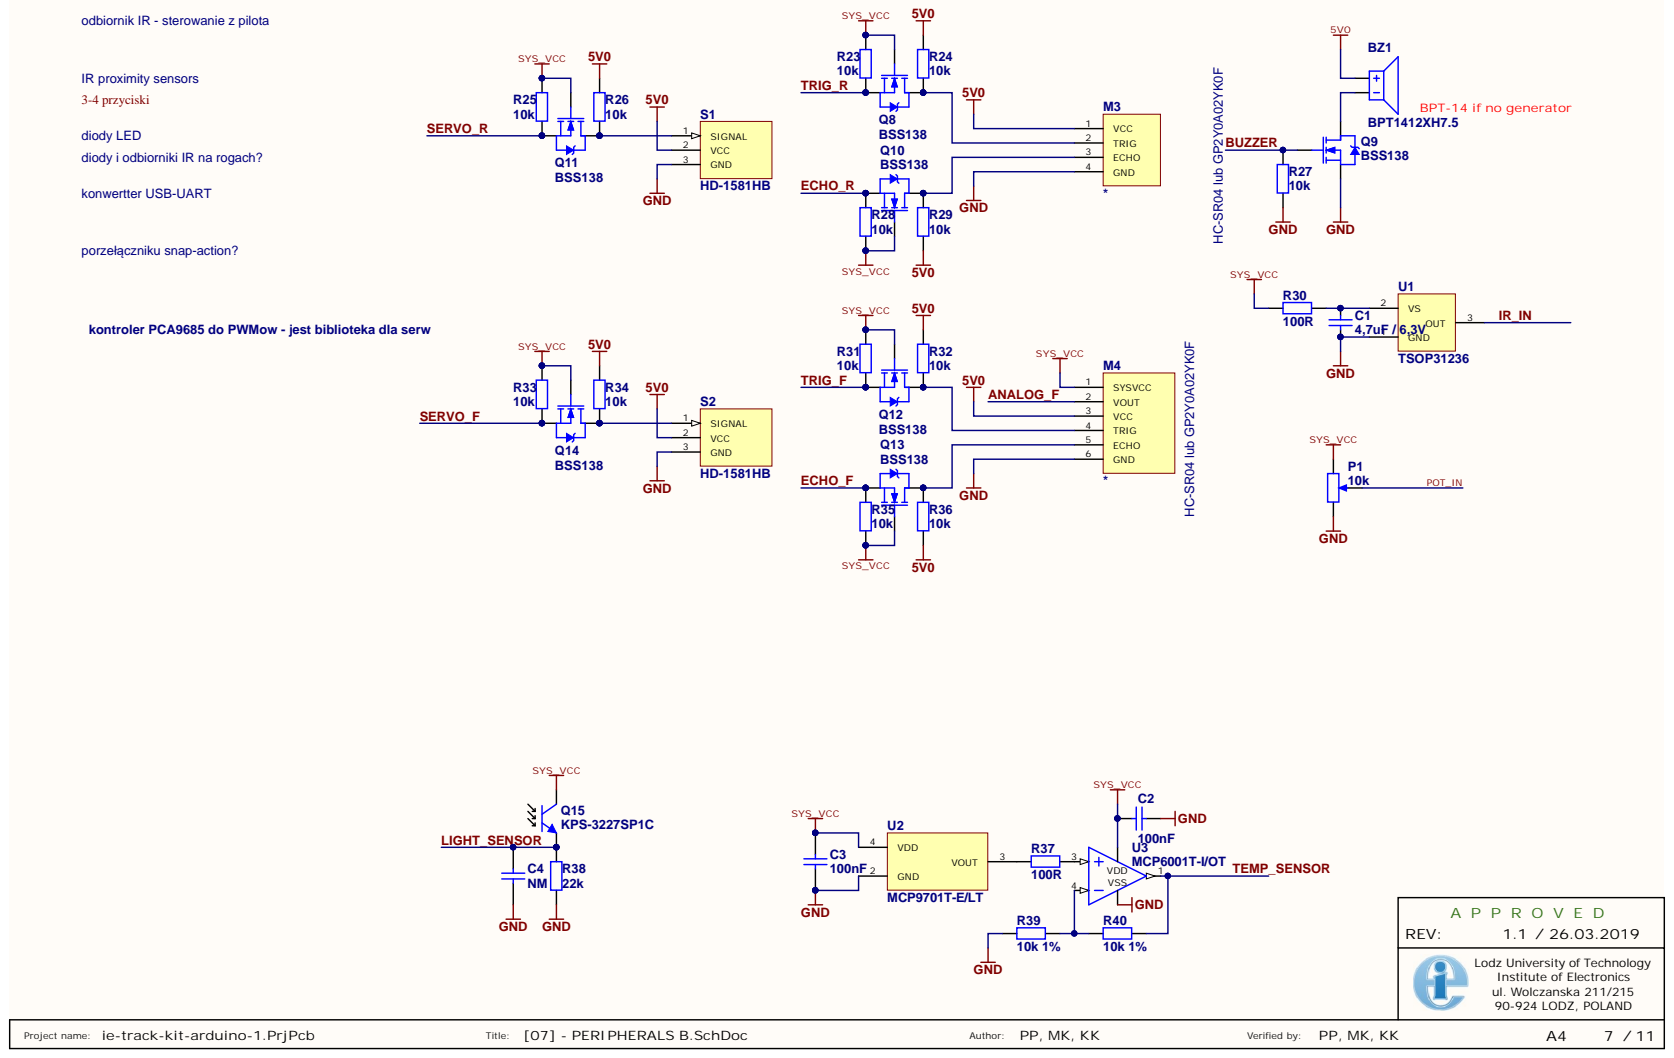
[picture p54: page 7]

odbiornik IR - sterowanie z pilota

BPT-14 if no generator

diody LED
diody i odbiorniki IR na rogach?

VCC 2

GND 4

kontroler PCA9685 do PWMow - jest biblioteka dla serw

ANALOG_F | VOUT 2

VCC 3

ECHO 5

Lodz University of Technology
Institute of Electronics
ul. Wolczanska 211/215

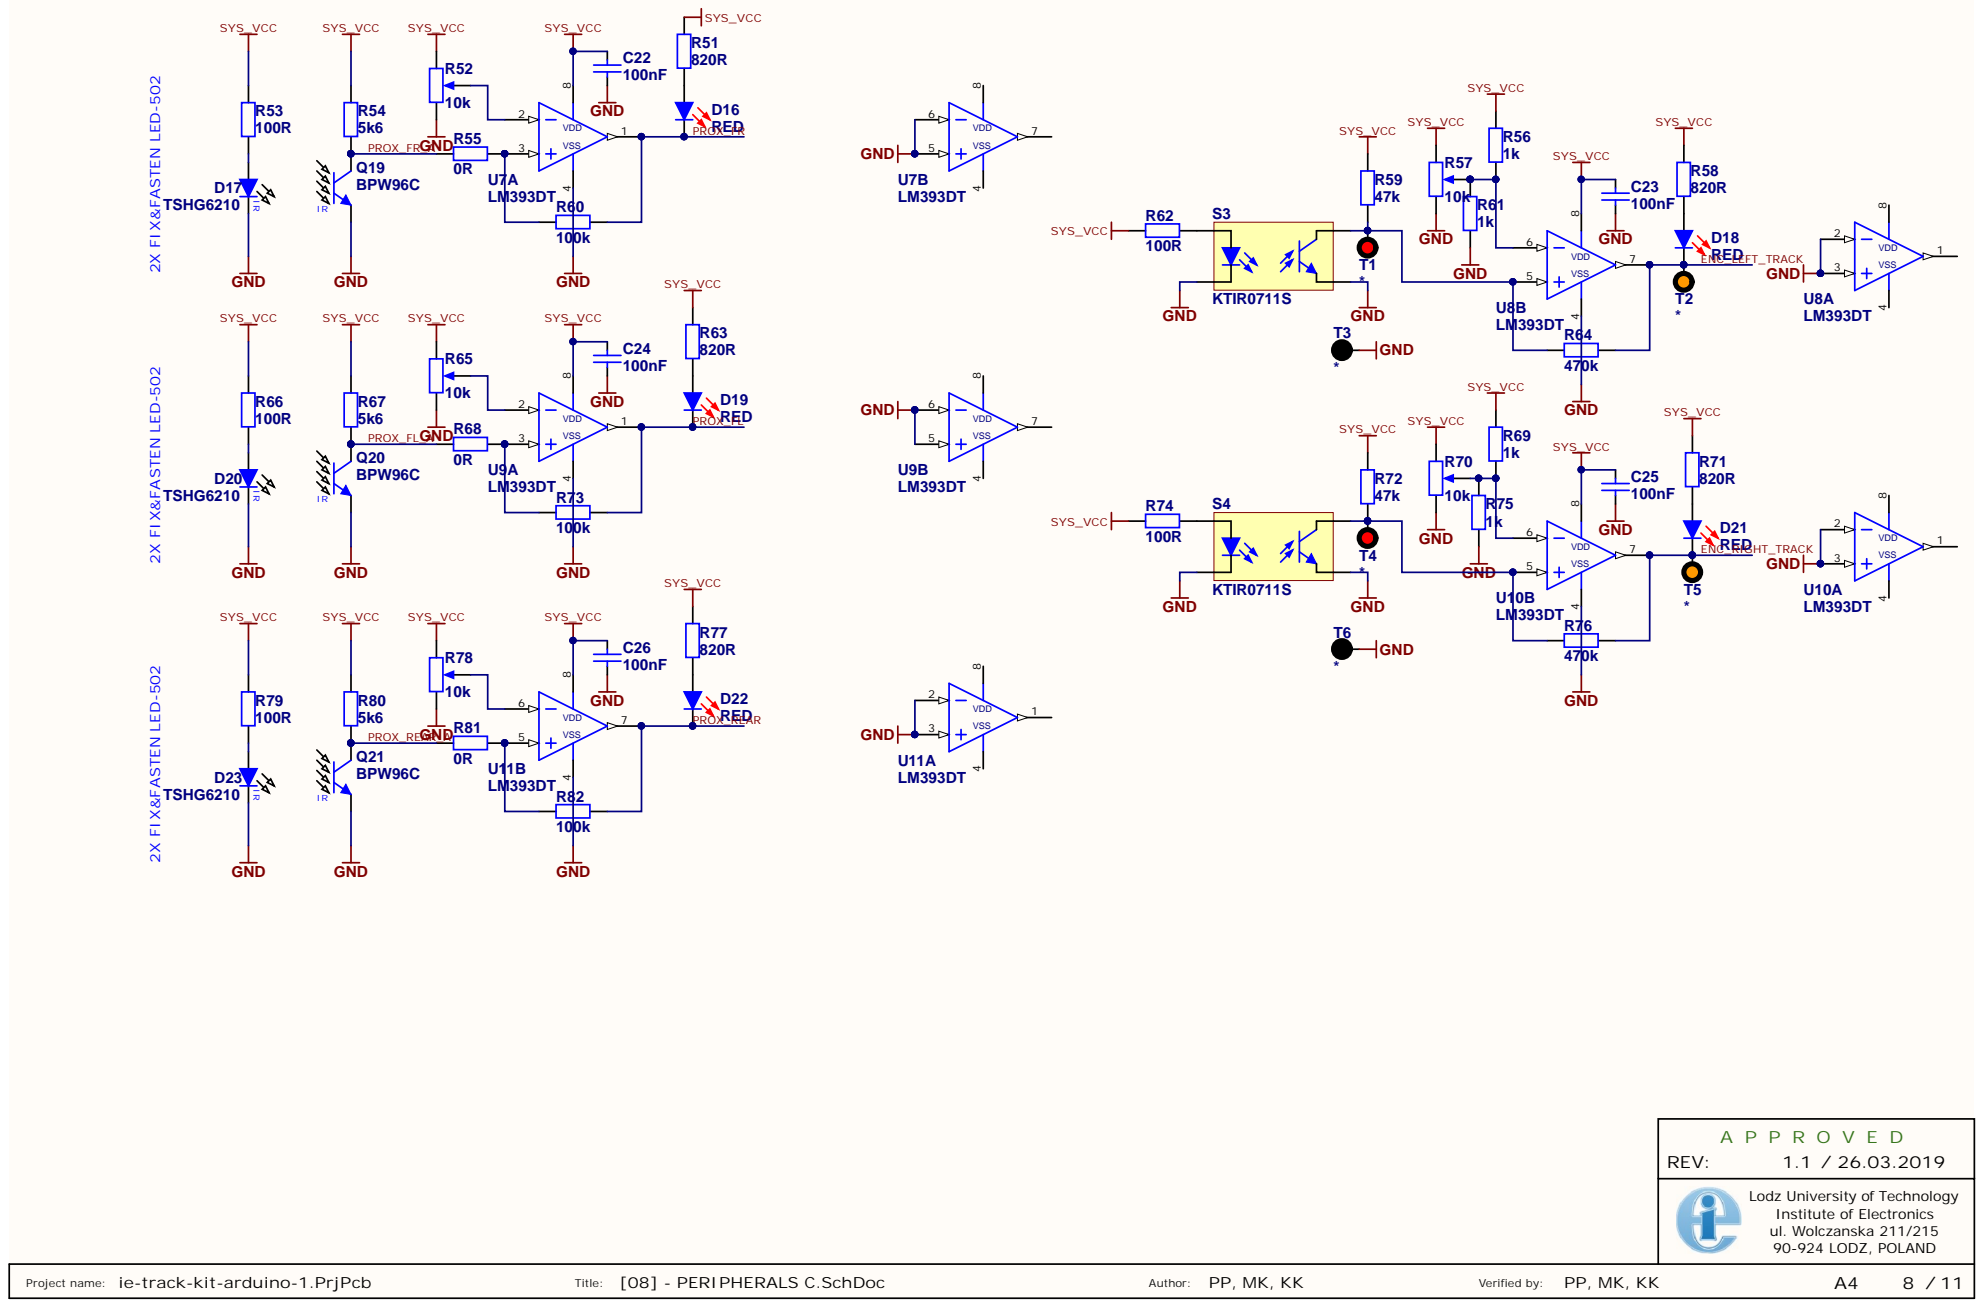
[picture p55: page 8]

Lodz University of Technology
Institute of Electronics
ul. Wolczanska 211/215

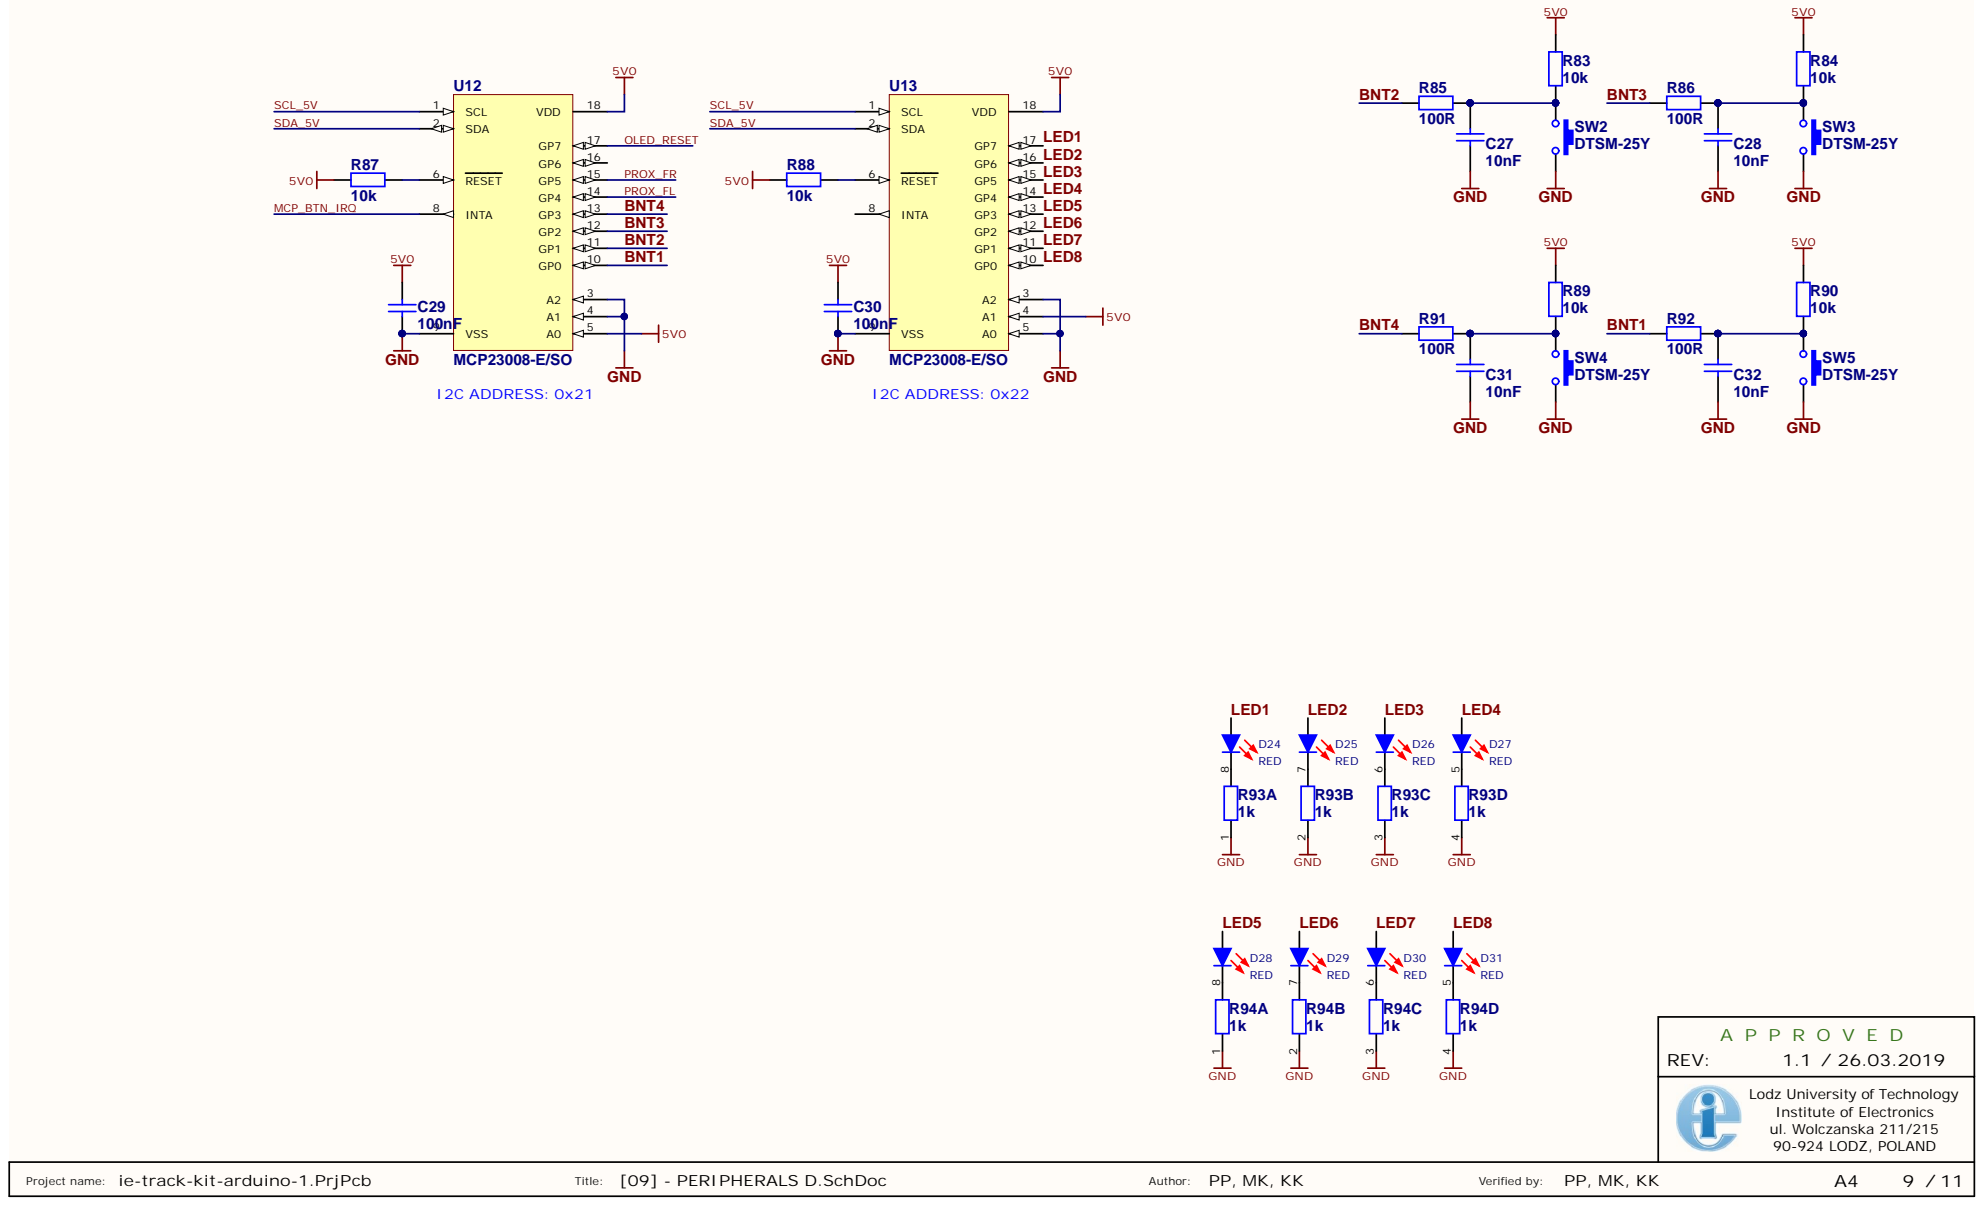
[picture p56: page 9]

Lodz University of Technology
Institute of Electronics
ul. Wolczanska 211/215

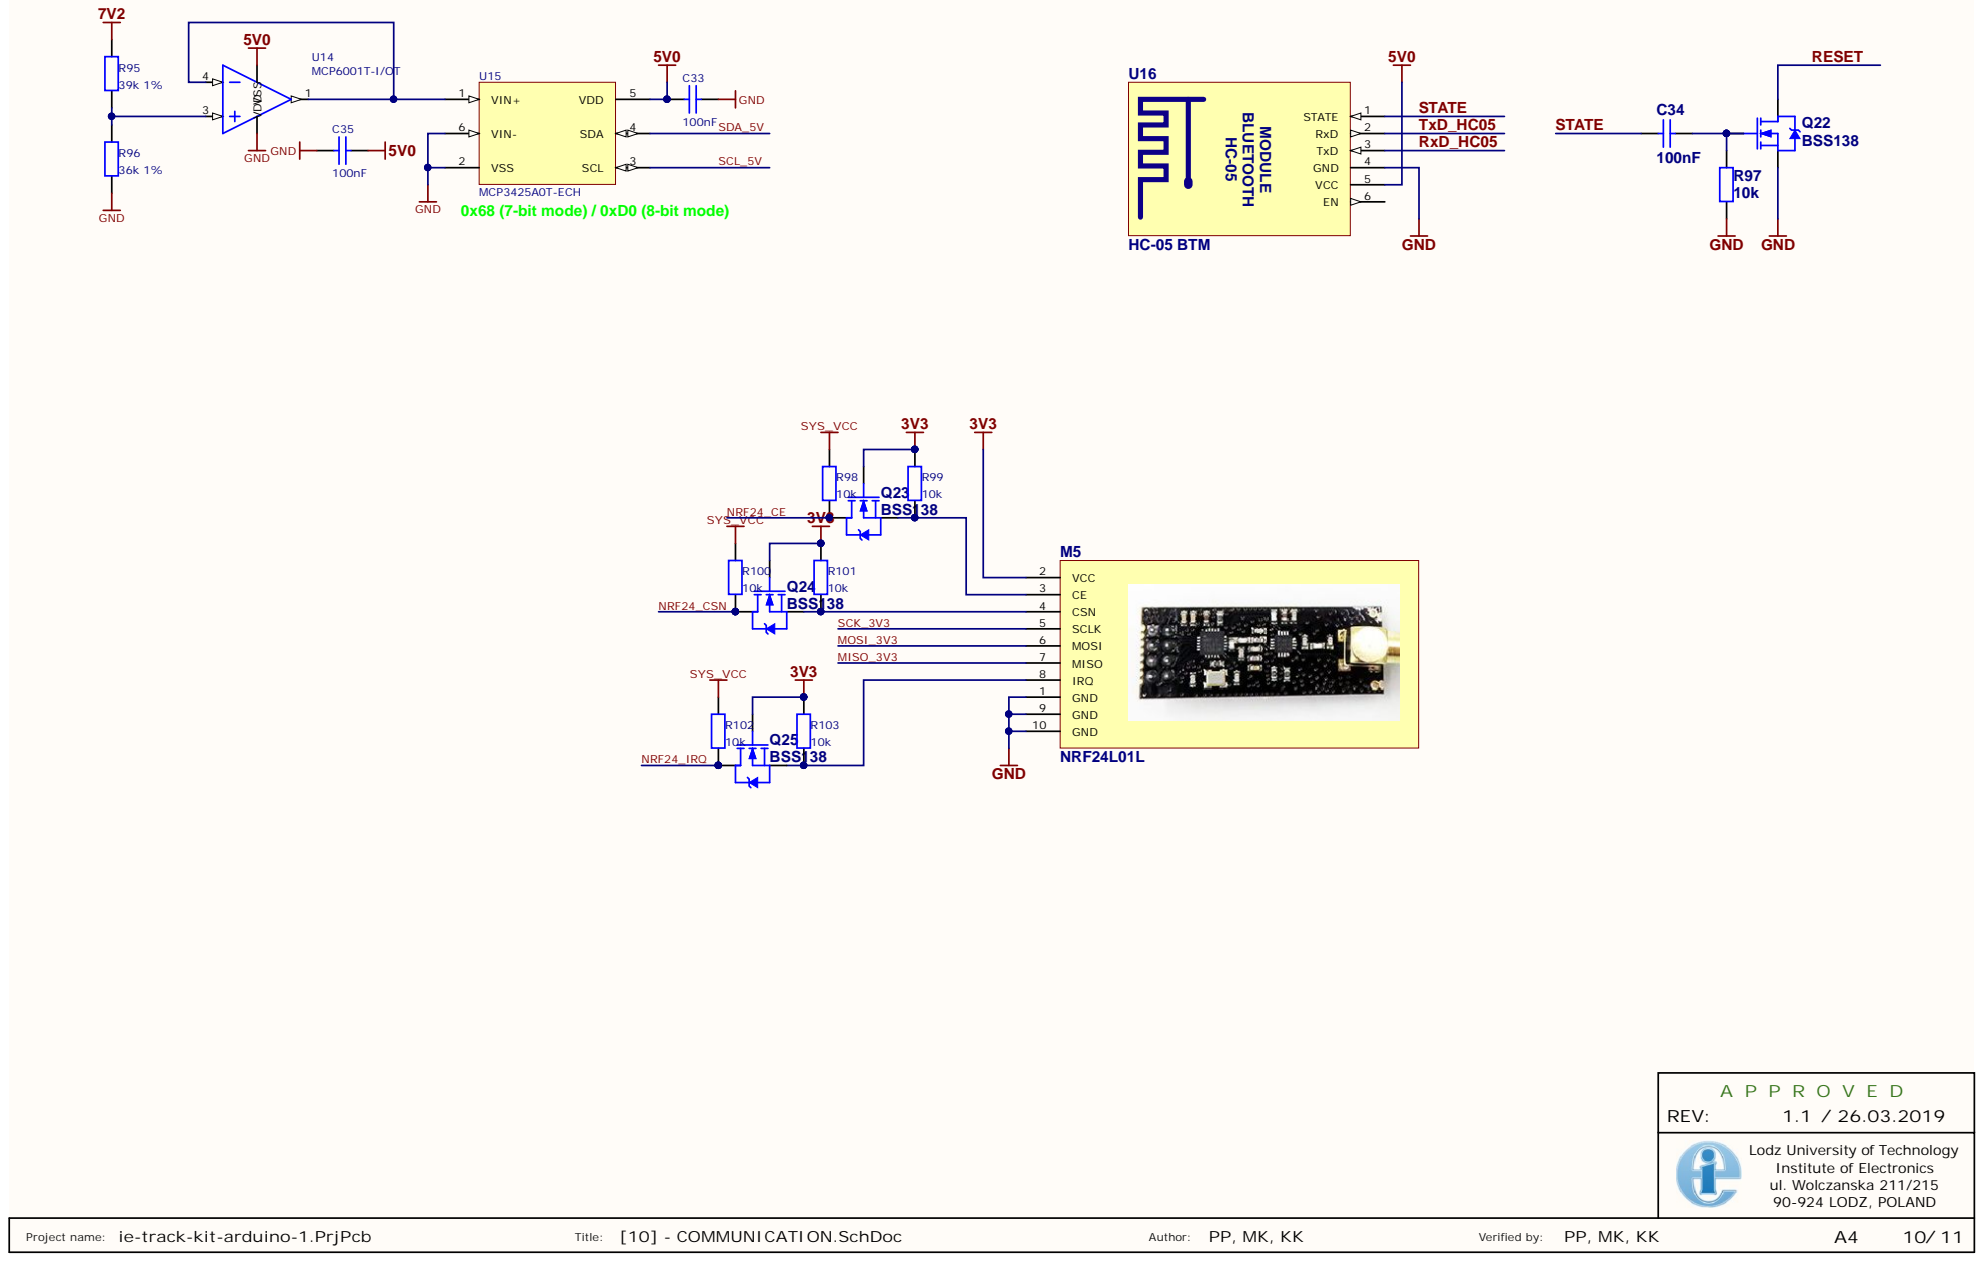
[picture p57: page 10]

Lodz University of Technology
Institute of Electronics
ul. Wolczanska 211/215

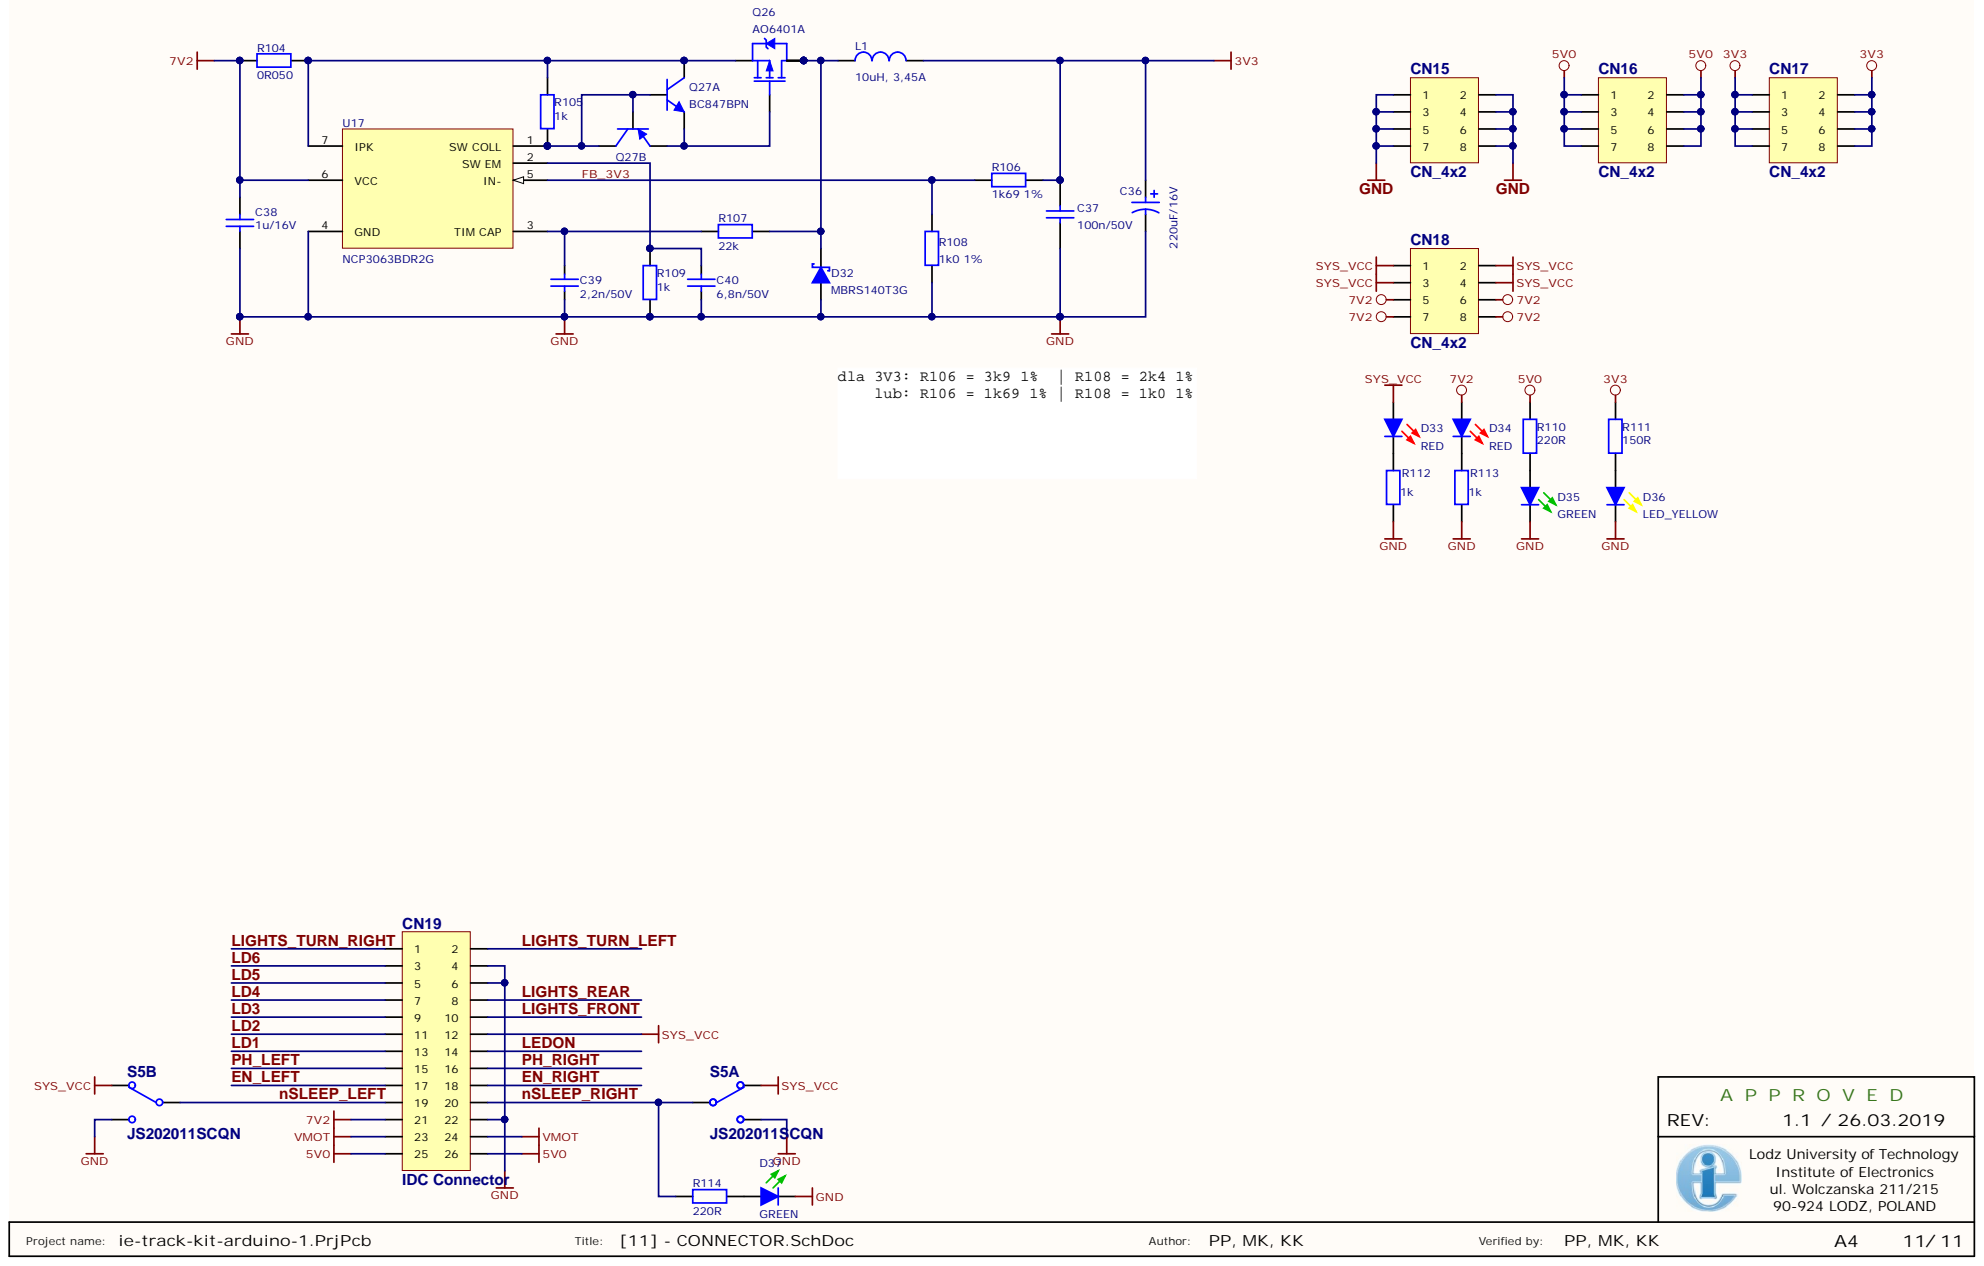
[picture p58: page 11]

Lodz University of Technology
Institute of Electronics
ul. Wolczanska 211/215
