SKNMIPSA/IE-TANK-KIT-1/HW/POWER/_DOCUMENTATION/ie-track-kit-pwr-1, v1.2.PDF

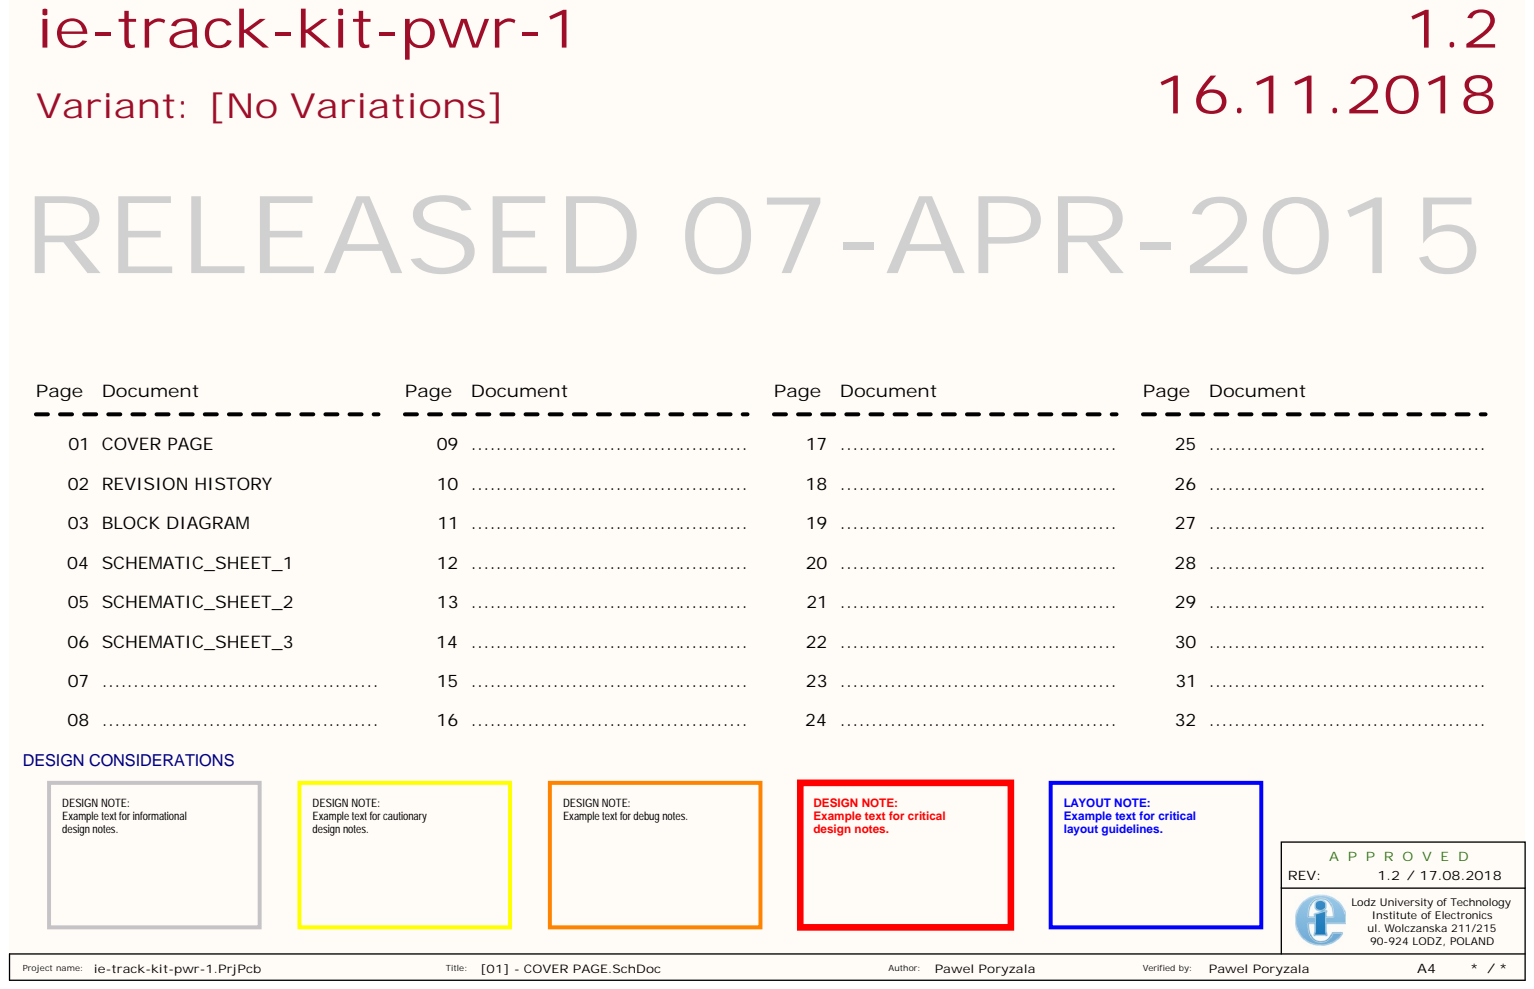
[picture p59: page 1]

ie-track-kit-pwr-1
RELEASED 07-APR-2015

DESIGN NOTE:
Example text for informational
design notes.

Example text for cautionary

Example text for debug notes.

Example text for critical

LAYOUT NOTE:
layout guidelines.

Lodz University of Technology
Institute of Electronics
ul. Wolczanska 211/215
90-924 LODZ, POLAND

1.2 / 17.08.2018

## A P P R O V E D

[02] - REVISION HISTORY.SchDoc | Pawel Poryzala | Pawel Poryzala | A4 | * / *

### Lodz University of Technology

### ul. Wolczanska 211/215

## REV:

### Institute of Electronics

# REVISION HISTORY

# TODOs, PROPOSALS & IMPROVEMENTS

Rev. | Date
0.1P | COVER PAGE Author
| 01/02/2017

# Description

# COVER PAGE

# Text

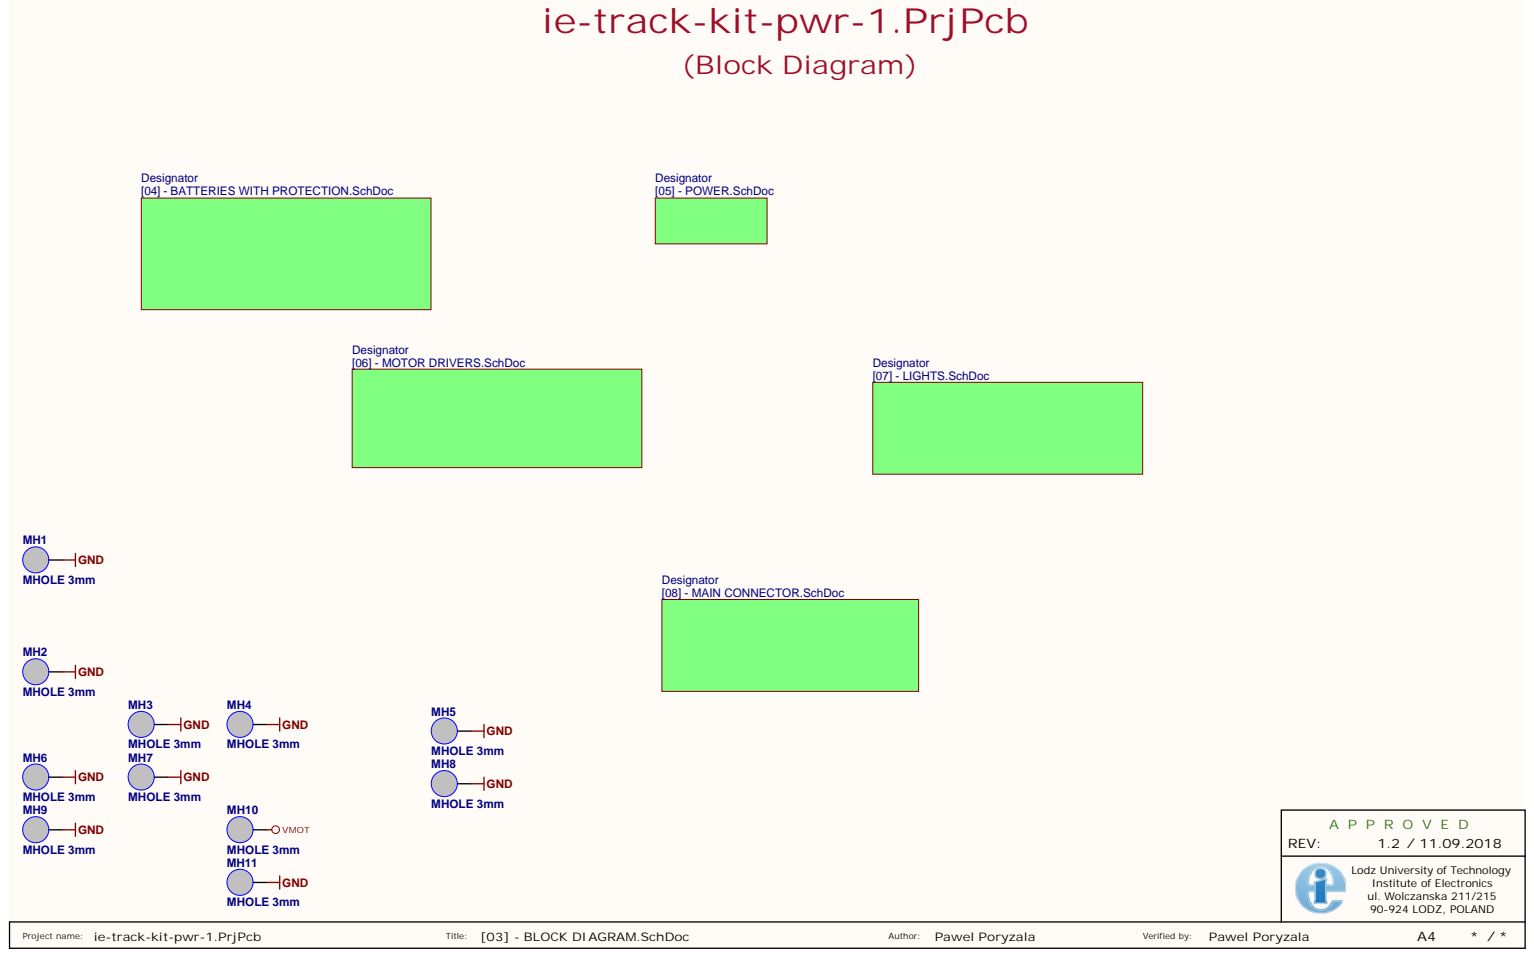
[picture p60: page 3]

ie-track-kit-pwr-1.PrjPcb

Designator
[04] - BATTERIES WITH PROTECTION.SchDoc

Lodz University of Technology
Institute of Electronics
ul. Wolczanska 211/215

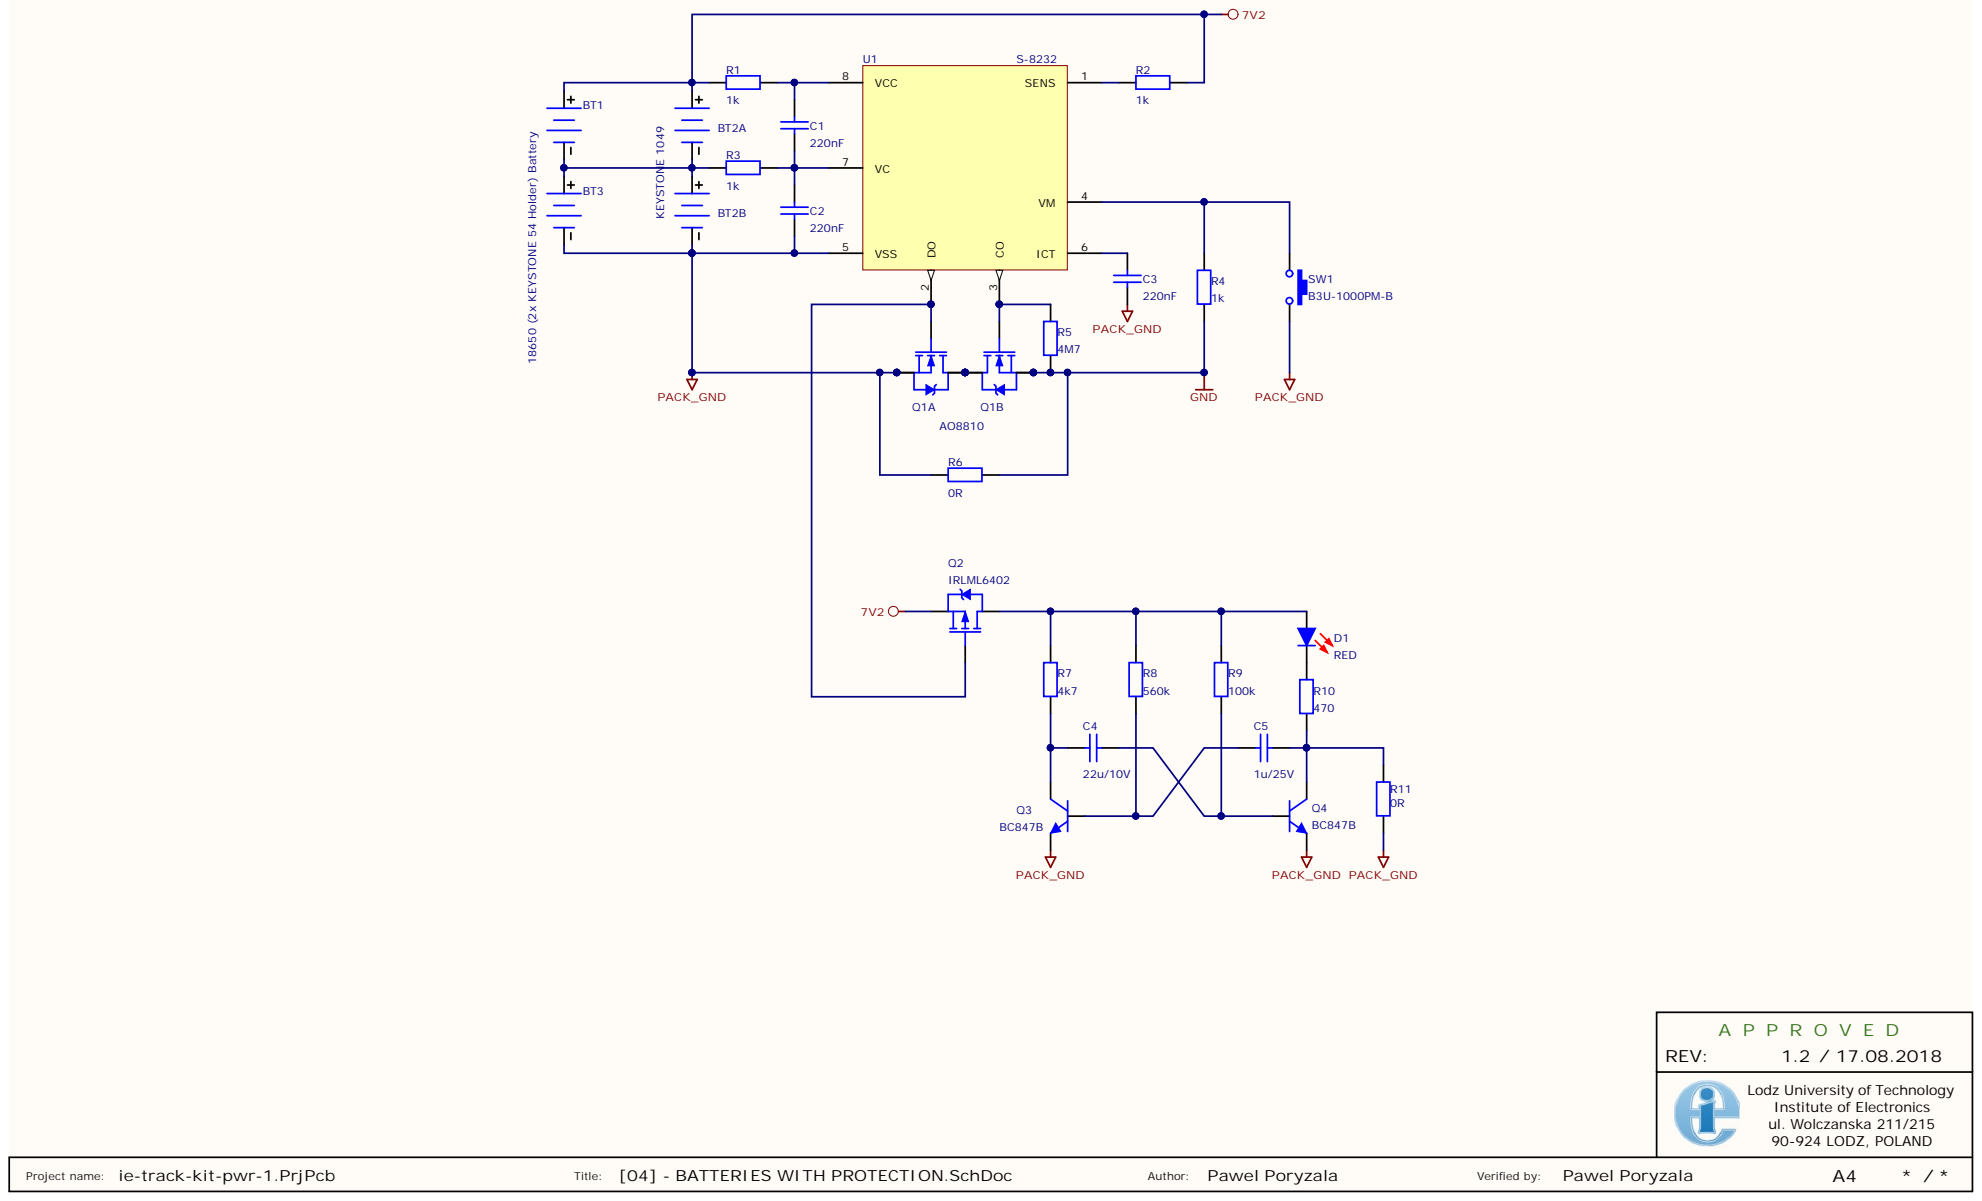
[picture p61: page 4]

Lodz University of Technology
Institute of Electronics
ul. Wolczanska 211/215

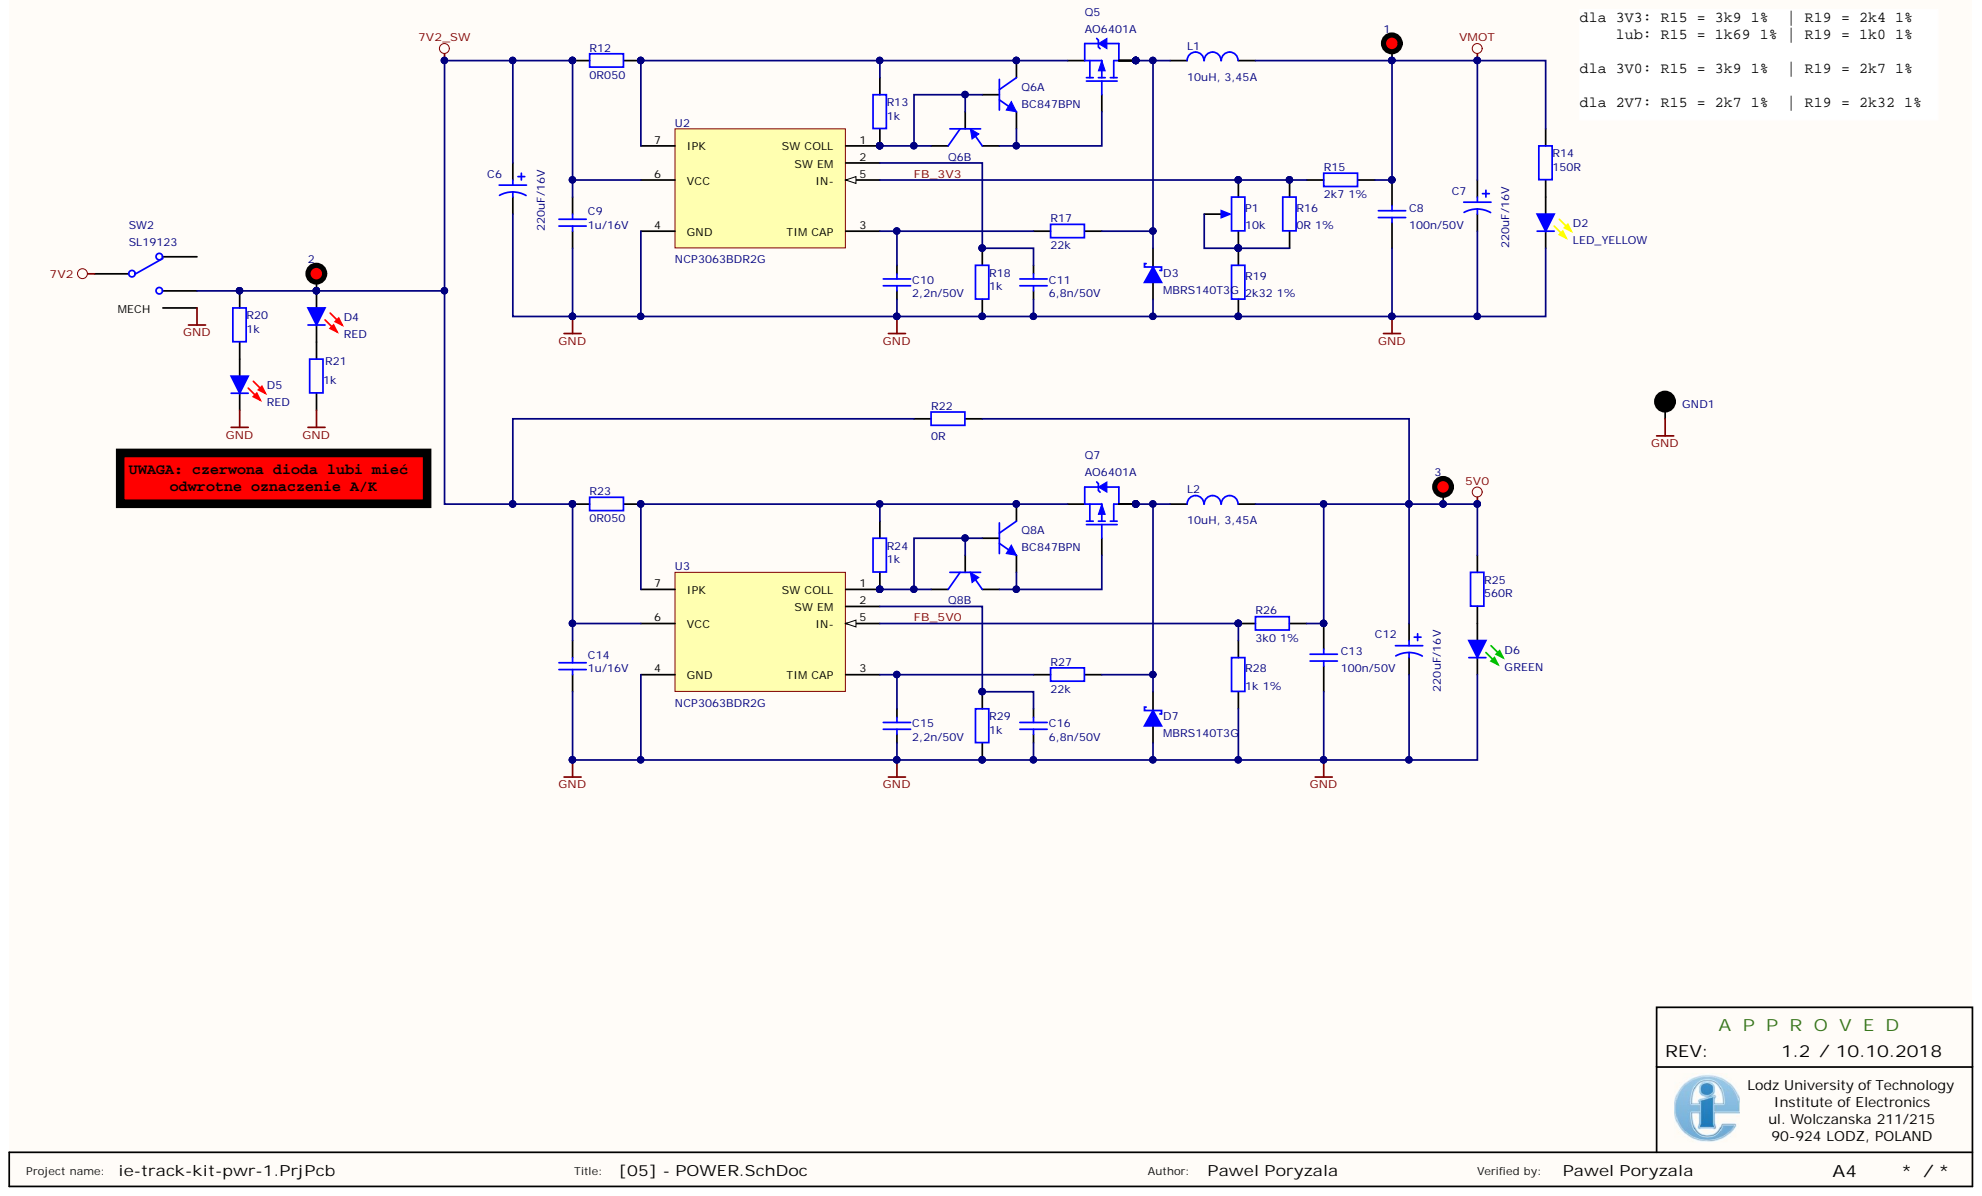
[picture p62: page 5]

UWAGA: czerwona dioda lubi mie

Lodz University of Technology
Institute of Electronics
ul. Wolczanska 211/215

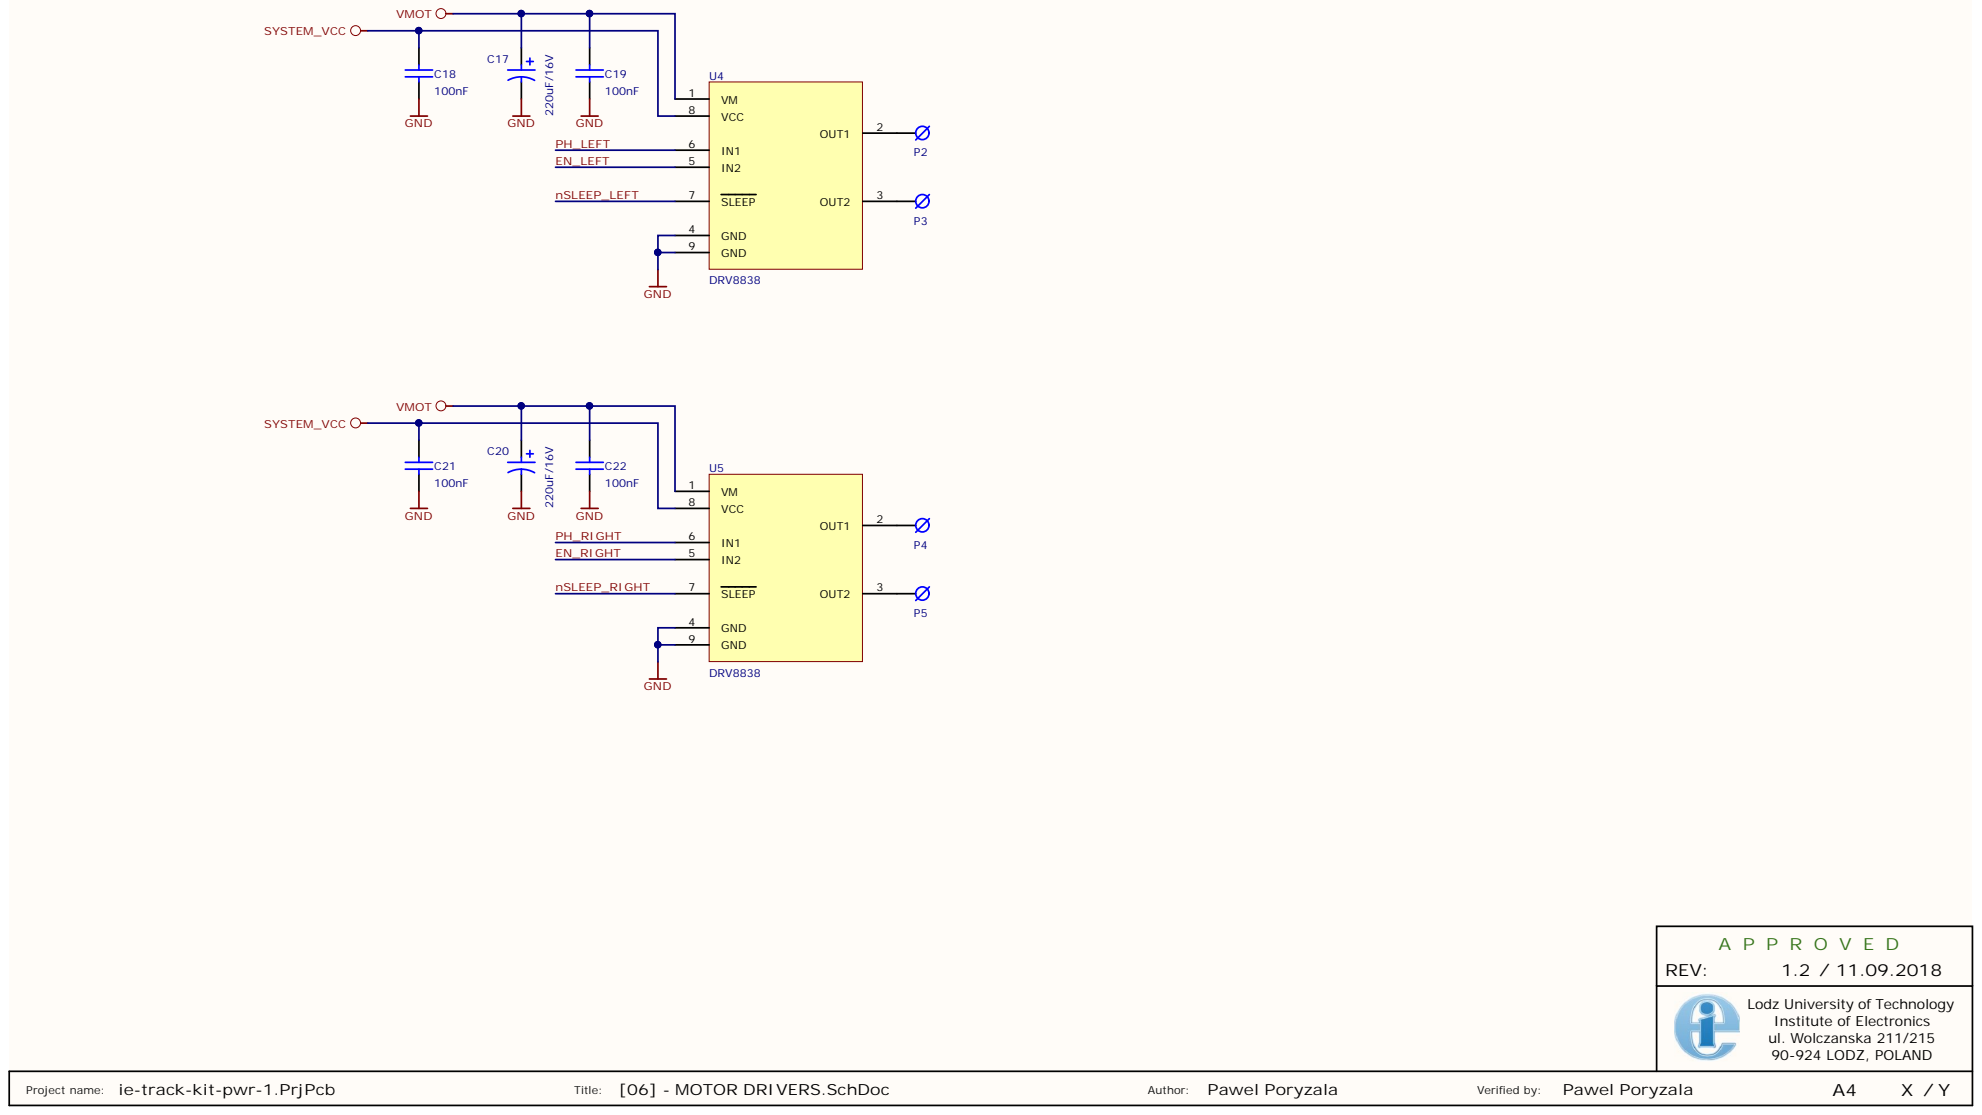
[picture p63: page 6]

Lodz University of Technology
Institute of Electronics
ul. Wolczanska 211/215

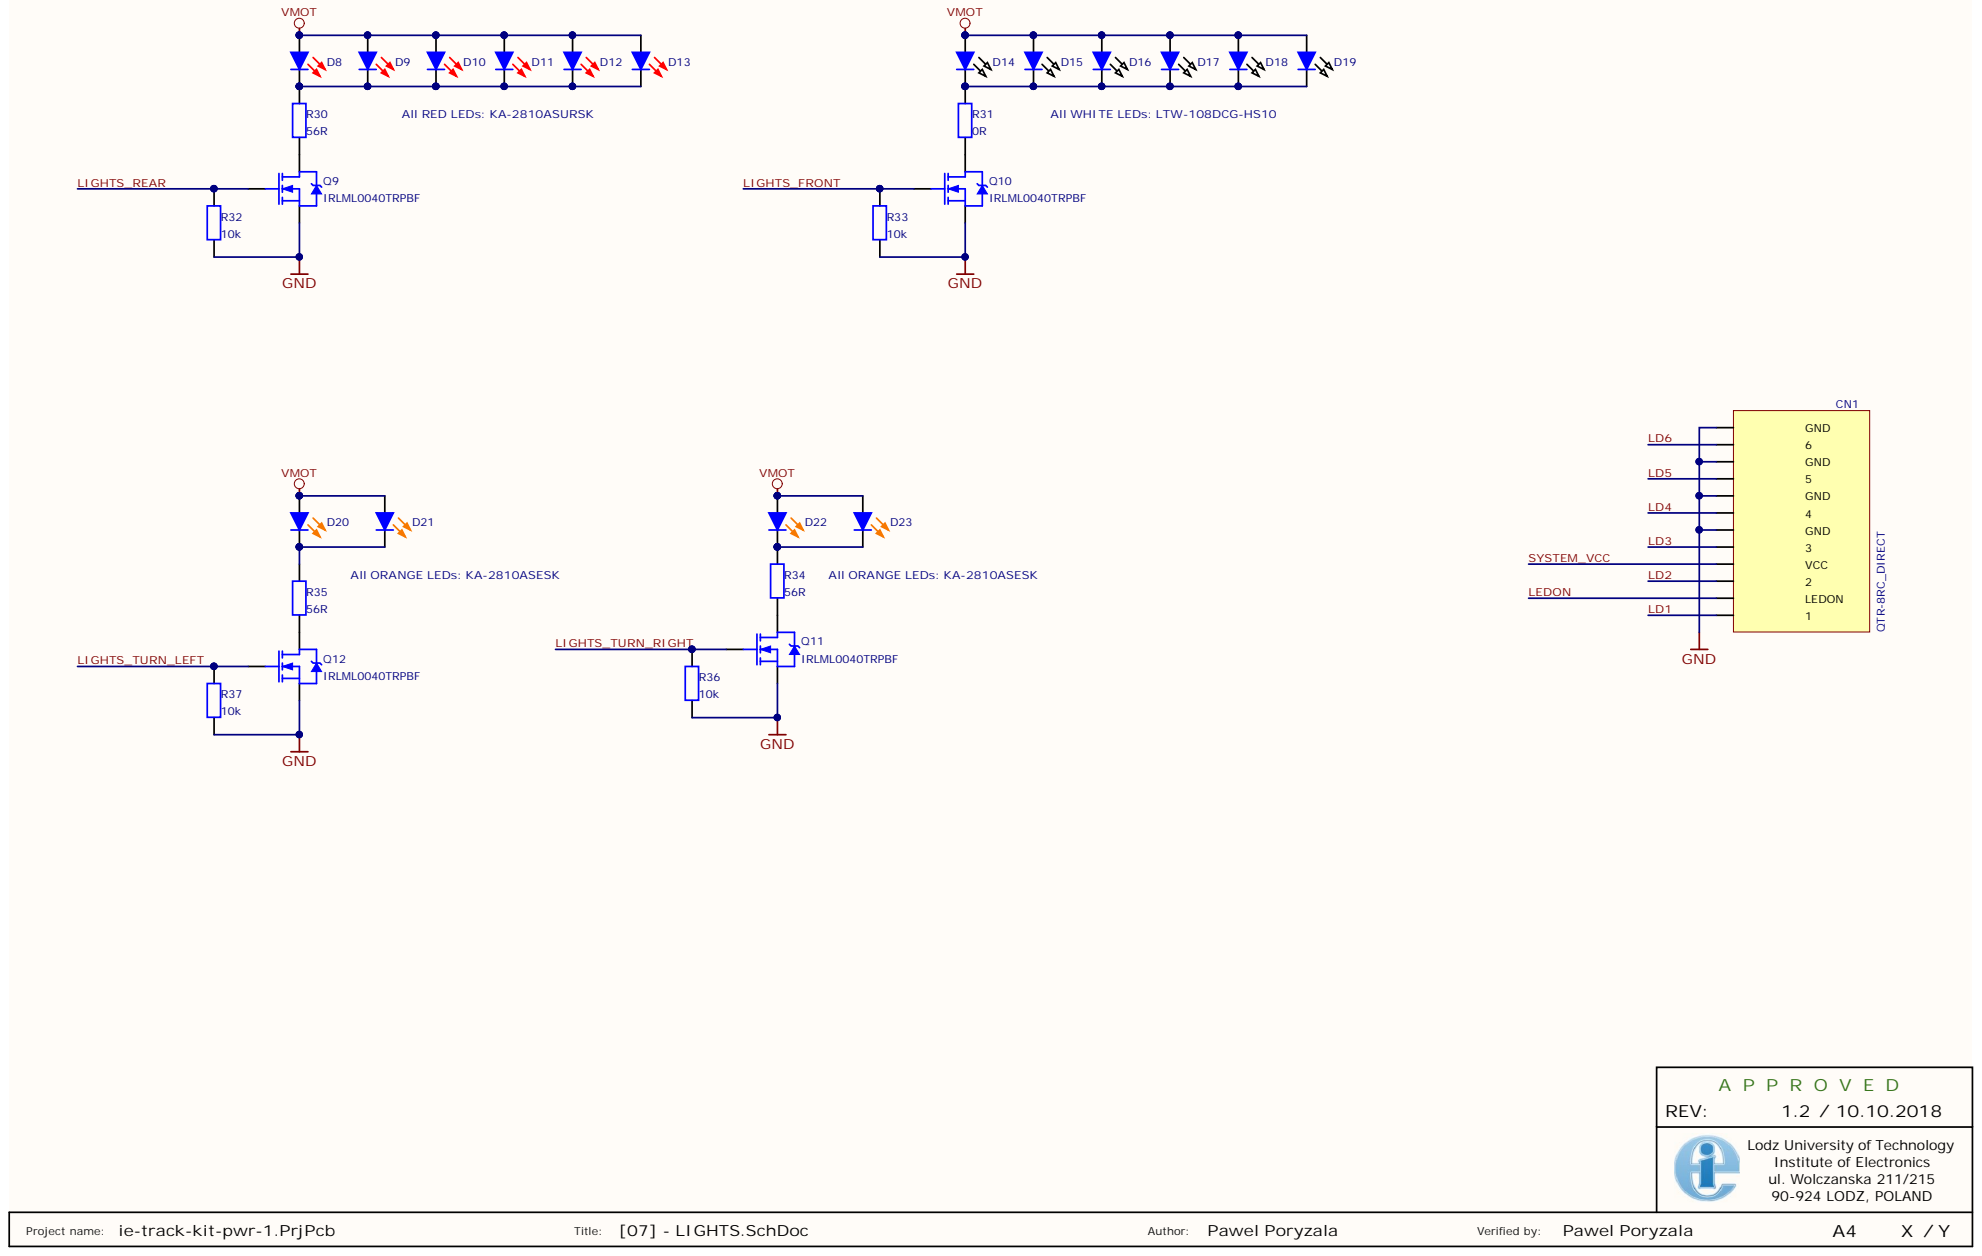
[picture p64: page 7]

LEDON GND GND GND GND C
Institute of Electronics 123456

Lodz University of Technology

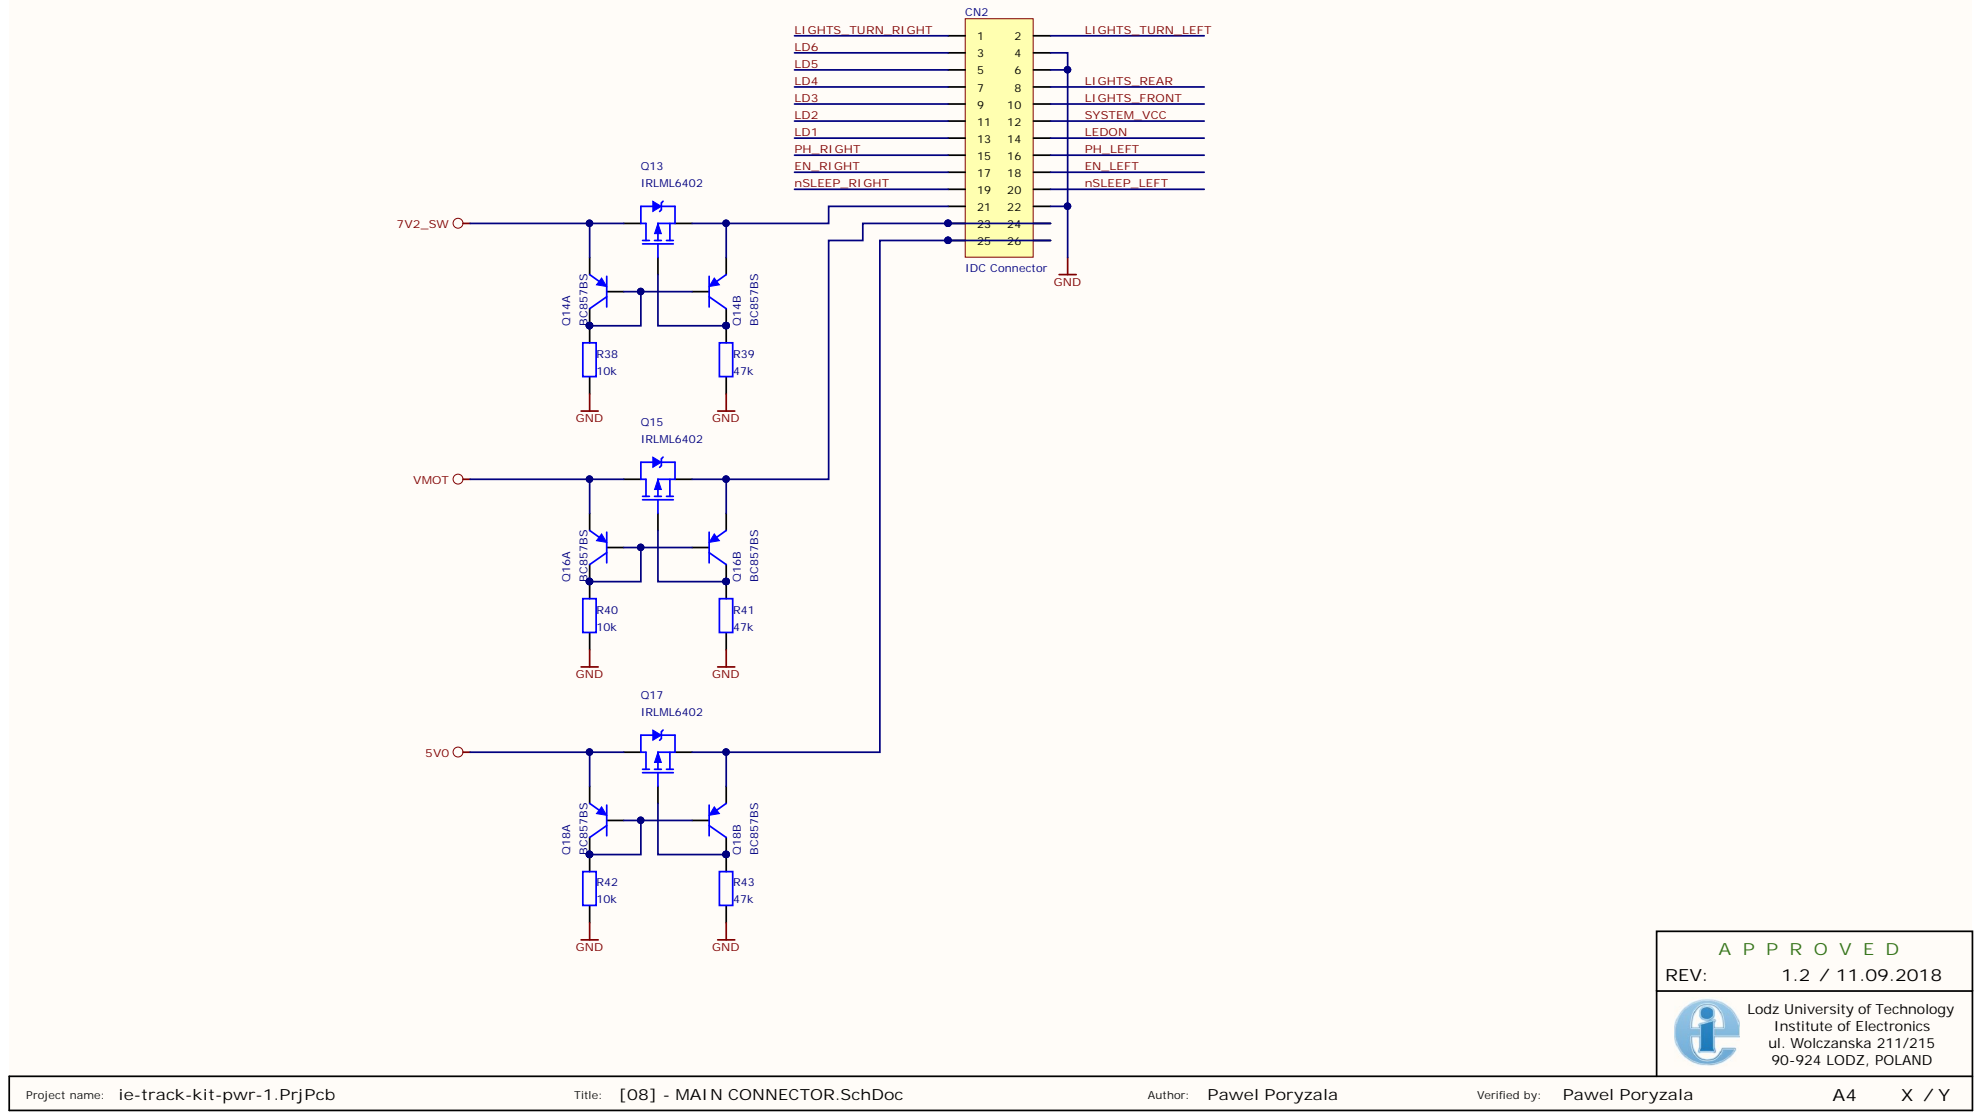
[picture p65: page 8]

23 24
25 26

Lodz University of Technology
Institute of Electronics
ul. Wolczanska 211/215
