SKNMIPSA/IE-TANK-KIT-1/HW/POWER/_DOCUMENTATION/PCB 3D Print.PDF

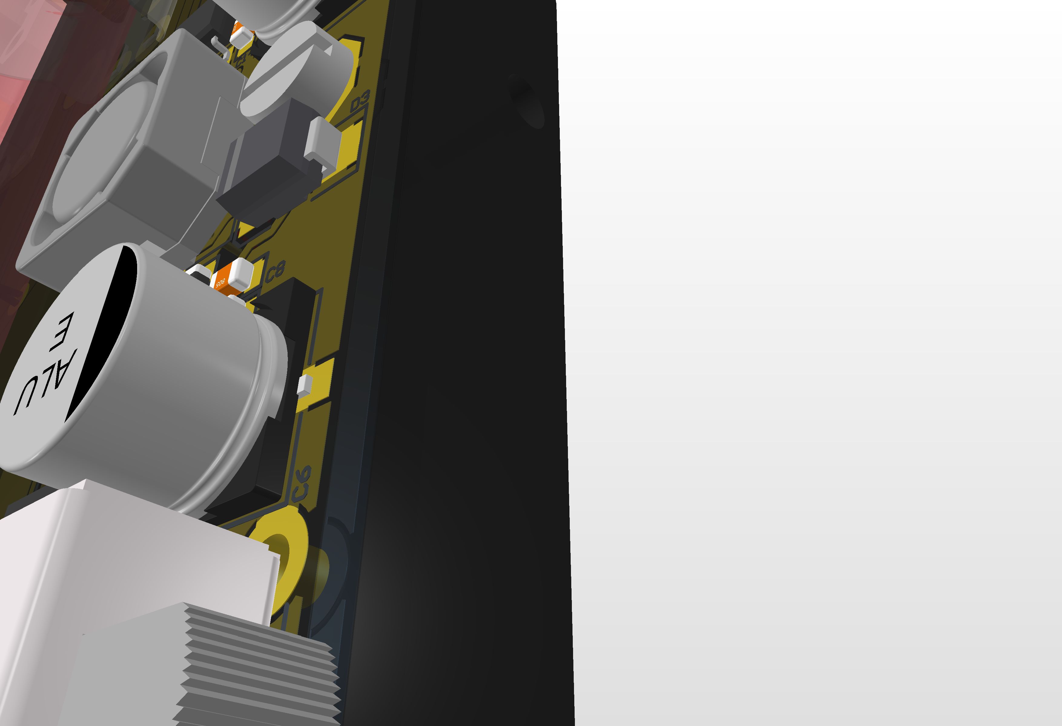
[picture p73: page 1]
