SKNMIPSA/IE-TANK-KIT-1/HW/POWER/_DOCUMENTATION/PCB Prints.PDF

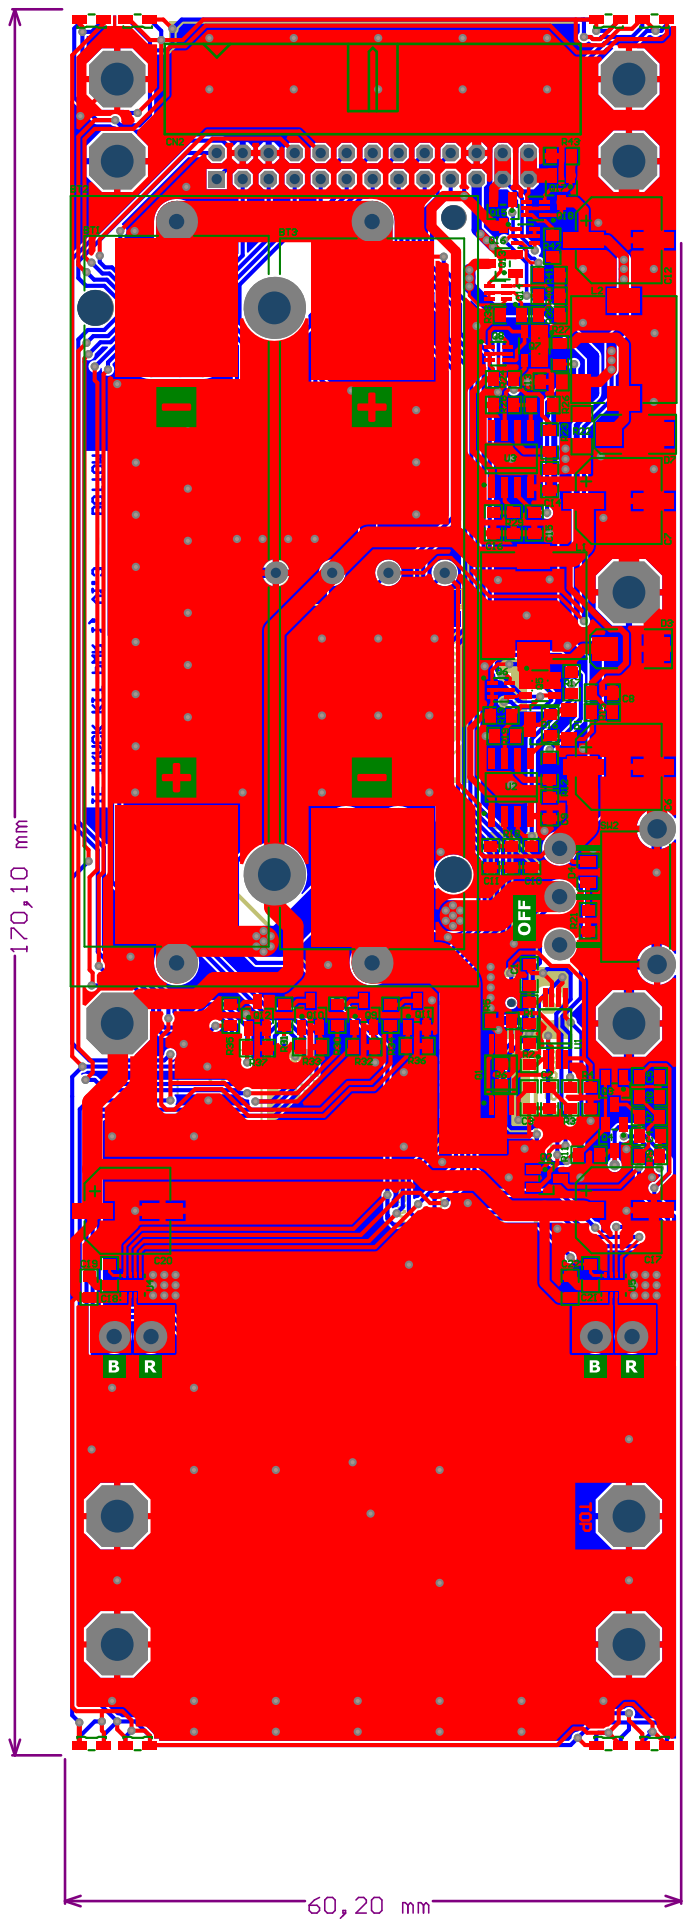
[picture p74: page 1]
