SKNMIPSA/IE-TANK-KIT-1/HW/TME-arduino-edu-board-1-0-a.pdf

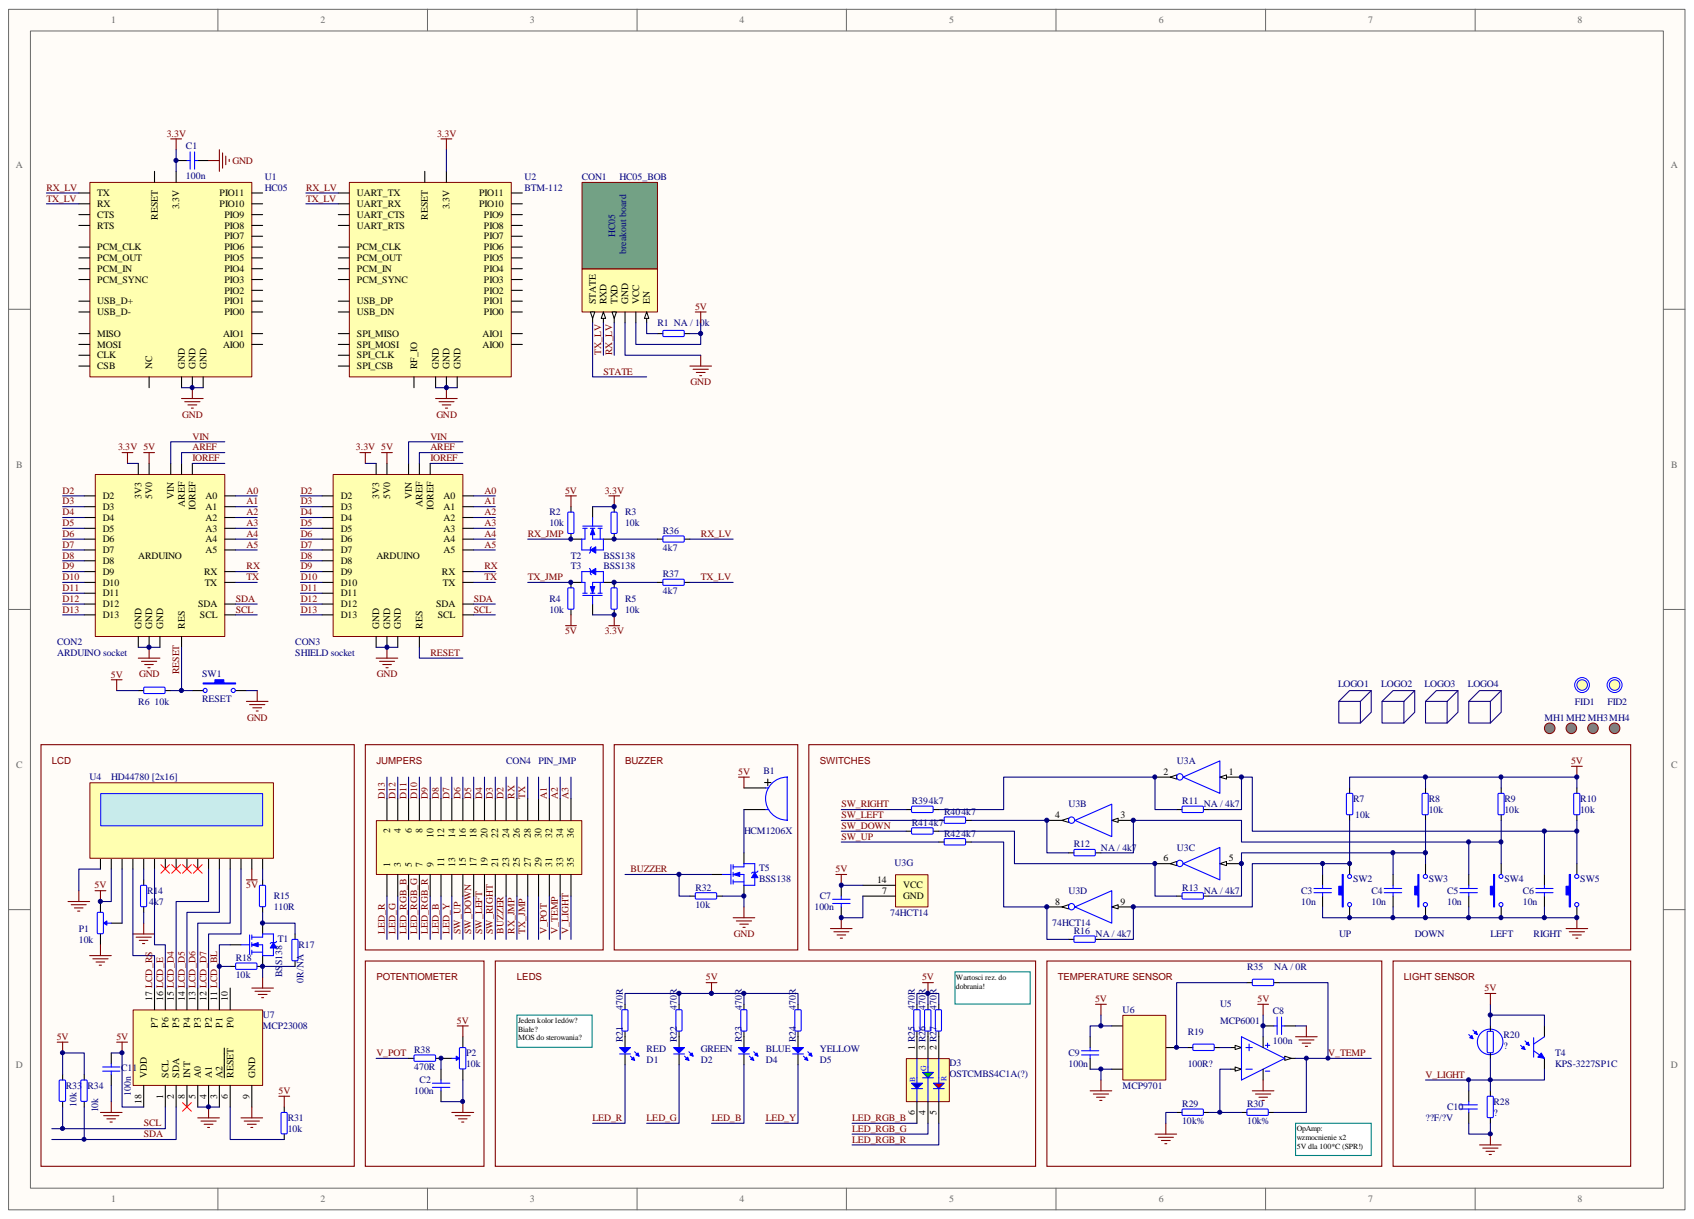
[picture p75: page 1]

CSB MOSI MISO CLK
