SKNMIPSA/IE-TANK-KIT-1/HW/_RENDERINGS/ie-track-kit-drawing.pdf

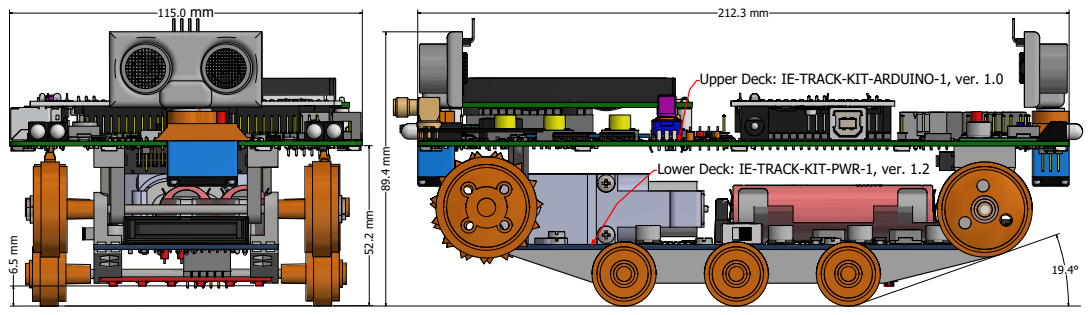
[picture p76: page 1]
