SKNMIPSA/IE-TANK-KIT-1/HW/POWER/ie-track-kit-pwr-1_drawing.pdf

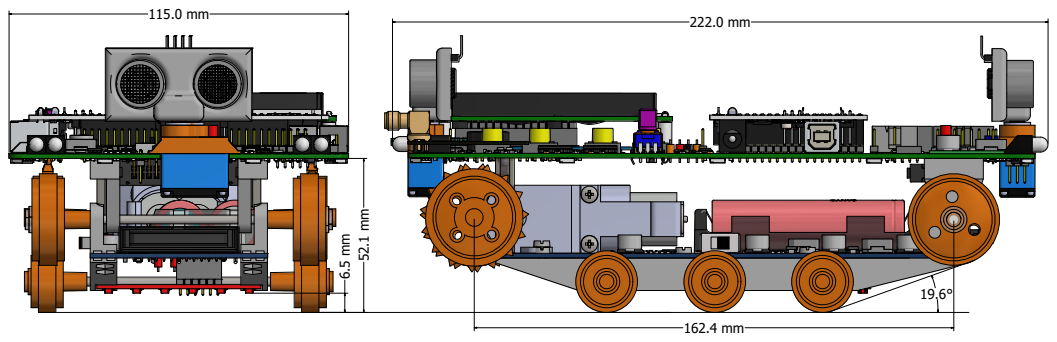
[picture p77: page 1]
