SKNMIPSA/IE-TANK-KIT-1/HW/voltage_conversion.asc

D1: schottky; 1N5817
M1: nmos; 2N7002
R1: res; 10k
R2: res; 10k
R3: res; 1Meg
R4: res; 100k
V1: voltage; 5V
V2: voltage; 5V
V3: voltage; PULSE(0 5V 0.1 0.01 0.01 0.3 .6 10)
Named nets: 3V3, 5V, 0
.tran 1
