SKNMIPSA/IE-TANK-KIT-1/HW/POWER/_SIMULATIONS/Draft1.asc

R2: res; 1Meg
R3: res; 1Meg
R4: res; 1Meg
R5: res; 10k
U2: LTC6702
V1: voltage; 5
V2: voltage; 1V8
V3: voltage; SINE(2.5 2.5 10 0)
Named nets: VIN, 0, 1V8
.tran 0 .5 0 .1
