SKNMIPSA/IE-TANK-KIT-1/HW/POWER/_SIMULATIONS/astable_led_blinker.asc

C1: cap; 1µ
C2: cap; 1µ
D1: LED; NSSWS108T
Q1: npn; BC847C
Q2: npn; BC847C
R1: res; 470
R2: res; 100k
R3: res; 100k
R4: res; 470
V1: voltage; 4.8
Named nets: 0
.tran 0 1 0 0.00001
