SKNMIPSA/IE-TANK-KIT-1/(list of files, drawings)

Other design files:
HW/MAIN/[01] - COVER PAGE.SchDoc
HW/MAIN/[02] - REVISION HISTORY.SchDoc
HW/MAIN/[03] - BLOCK DIAGRAM.SchDoc
HW/MAIN/[04] - ARDUINO UNO (MEGA).SchDoc
HW/MAIN/[05] - DEBUGGING & PROGRAMMING.SchDoc
HW/MAIN/[06] - PERIPHERALS A.SchDoc
HW/MAIN/[07] - PERIPHERALS B.SchDoc
HW/MAIN/[08] - PERIPHERALS C.SchDoc
HW/MAIN/[09] - PERIPHERALS D.SchDoc
HW/MAIN/[10] - COMMUNICATION.SchDoc
HW/MAIN/[11] - CONNECTOR.SchDoc
HW/MAIN/ie-track-kit-arduino-1.PrjPcb
HW/POWER/[03] - BLOCK DIAGRAM.SchDoc
HW/POWER/[04] - BATTERIES WITH PROTECTION.SchDoc
HW/POWER/[05] - POWER.SchDoc
HW/POWER/[06] - MOTOR DRIVERS.SchDoc
HW/POWER/[07] - LIGHTS.SchDoc
HW/POWER/[08] - MAIN CONNECTOR.SchDoc
HW/POWER/ie-track-kit-pwr-1.PrjPcb
HW/POWER/pcb.PcbDoc
HW/POWER/power_board.PrjPcb
