SKNMIPSA/IE-TANK-KIT-1/(commit log)

2017-07-31 prace nad płytkami...
    [pcb.PcbDoc, power_board.PrjPcb, sch.SchDoc]
2017-08-01 postep prac...
    [pcb.PcbDoc, power_board.PrjPcb, sch.SchDoc]
2017-08-03 prace nad schematem
    [battery_protection.SchDoc, motor_drivers.SchDoc, pcb.PcbDoc, power.SchDoc, power_board.PrjPcb, sch.SchDoc]
2017-08-06 aktualny postęp prac
    [battery_protection.SchDoc, motor_drivers.SchDoc, power_board.PrjPcb]
2017-08-18 płytka wykonana jako prototyp na frezarce
    [battery_protection.SchDoc, motor_drivers.SchDoc, other.SchDoc, power.SchDoc, power_board.PrjPcb]
2017-08-21 update plików
    [TamiyaTankArduinoShield.PrjPcb, motor_drivers.SchDoc, new_wheel_support .stp, new_wheel_support.ipt, new_wheel_support.stl, other.SchDoc, power.SchDoc, power_board.PrjPcb]
2017-08-22 poprawne jednostki przy eksporcie mechaniki do wydruku
    [new_wheel_support.stl, upper_deck_shaft_mount.stl]
2017-08-23 wykonana wersja 2-giego prototypu + poprawki mechaniki
    [TamiyaTankArduinoShield.PrjPcb, new_wheel_support.ipt, new_wheel_support_v2.ipt, new_wheel_support_v2.stl, new_wheel_support_v2.stp, sch.SchDoc, upper_deck_shaft_mount_v2.ipt, upper_deck_shaft_mount_v2.stl]
2017-08-24 poprawki podczas montażu pierwszego prototypu
    [battery_protection.SchDoc, other.SchDoc, power.SchDoc]
2017-09-13 - nowa wersja górnego pokładu - shottky w szeregu zasilania 7V2 (zasilanie wstecz z VIN Arduino, - nowe wersje wsporników do druku 3D - próba zmiany IDC 24 pin na 26 pin (koszty i dostępność)
    [TamiyaTankArduinoShield.PrjPcb, lower_deck_shaft_mount.ipt, lower_deck_shaft_mount.stl, motor_drivers.SchDoc, other.SchDoc, power.SchDoc, power_board.PrjPcb, sch.SchDoc]
2017-09-15 wspornik montowany na dolnym pokładzie
    [lower_deck_shaft_mount.ipt, lower_deck_shaft_mount_dla_AD.stp, lower_deck_shaft_mount_for_AD.ipt, lower_deck_shaft_mount_printing.ipt, lower_deck_shaft_mount_printing.stl]
2017-09-15 porządki w el. mechanicznych + gotowy dla AD i do wydruku model wspornika osi dla górnego pokładu
    [8 hole angle bracket.SLDPRT, base plate.SLDPRT, base plate.stp, new_wheel_support .stp, new_wheel_support.stl, shaft mount.SLDPRT, shaft mount.stp, upper_deck_shaft_mount.ipt]
2017-09-15 nowe złącze 26 pin, dodatkowe światła (kierunkowskaz prawo / lewo), porzątki na schematach, zabezpieczenie o zerowym spadku napięcia na 7V2
    [lights.SchDoc, main_connector.SchDoc, mechanical.SchDoc, other.SchDoc, power_board.PrjPcb]
2017-10-05 prace nad wersja finalną
    [lights.SchDoc, main_connector.SchDoc, mechanical.SchDoc, power_board.PrjPcb]
2017-10-17 pprawki - przed wysłaniem do produkcji
    [lights.SchDoc, main_connector.SchDoc, mechanical.SchDoc, power.SchDoc, power_board.PrjPcb, sch.SchDoc]
2017-10-26 opis na dolnej warstwie - gotowe (?) do wysłania do BAZEKO
    [battery_protection.SchDoc, lights.SchDoc, main_connector.SchDoc, mechanical.SchDoc, motor_drivers.SchDoc, power.SchDoc, power_board.PrjPcb]
2017-10-26 zmiana nazwy projektu
    [ie-track-kit-pwr-1.PrjPcb]
2017-10-26 pliki wysłane do BAZEKO (będą jeszcze ew. poprawki)
    [ie-track-kit-pwr-1.PrjPcb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]
2017-11-02 poprawki (0,5mm od krawędzi) wysłane do BaZeKo
    [ie-track-kit-pwr-1.PrjPcb, power.SchDoc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]
2017-11-02 ostatnie poprawki - nie wysłane w GERBERach do BaZeKo (połączenia masy na początku i końcu płytki)
    [ie-track-kit-pwr-1.PrjPcb]
2017-11-22 poprawki elementów mechanicznych + update szyn do trzymania osi na PCB (tylko zmiana modelu STEP)
    [ie-track-kit-pwr-1.PrjPcb, new_wheel_support.ipt, new_wheel_support_v2.ipt, new_wheel_support_v2.stl, new_wheel_support_v2.stp, wheel_support.ipt, wheel_support.stl, wheel_support.stp]
2017-11-23 support do osi w wersji przekładni 1:58 (inny rozstaw) + umieszczony na PCB jako STEP
    [wheel_support_long.ipt, wheel_support_long.stl, wheel_support_long.stp]
2017-11-23 zmiana konrektora do dolnego pokładu na 26 pin
    [TamiyaTankArduinoShield.PrjPcb, sch.SchDoc]
2017-12-02 górny pokład - pliki wykonane dla ŁUDu
    [TamiyaTankArduinoShield.PrjPcb, bluetooth.SchDoc, sch.SchDoc]
2017-12-06 wprowadzona część poprawke po serii 4 prototypów + dodane uwagi nt. kolejnych (obrys IDC i zamiana A i K diod czerwonych i pomarańczowych)
    [battery_protection.SchDoc, lights.SchDoc, power.SchDoc]
2018-01-05 zmieniony obrys głównego złącza i całość skrócona o 4,5mm - idealnie byłoby uciąć około 13 - do próbnego frezowania i testów napięcia gąsiennic (pojedynczy komplet)
    [ie-track-kit-pwr-1.PrjPcb, main_connector.SchDoc]
2018-01-08 krótsza wersja płyty zasilającej (do wykorzystania z pojedynczym kompletem gąsiennic) - do testów i dalszych prac dot. routingu
    [battery_protection.SchDoc, ie-track-kit-pwr-1.PrjPcb, lights.SchDoc, mechanical.SchDoc]
2018-01-09 porządki na płytce - prace dot. skrócenia PCB (pojedynczy komplet gąsiennic)
2018-01-10 nowe węższe mocowanie osi na dolnym pokładzie + nowa szyba mocowania osi - zmiany uwzględnione na PCB
    [lower_deck_short_shaft_mount_for_AD.ipt, lower_deck_short_shaft_mount_for_AD.stp, wheel_support_extra_short.ipt, wheel_support_extra_short.stp]
2018-01-11 dodatkowe czerwone diody z tyu pojazdu, kilka poprawek na PCB
    [lights.SchDoc]
2018-01-15 porządki w plikach mechaniki i update wspornika z dolnego poziomu do wydruku
    [lower_deck_shaft_mount_dla_AD.stp, lower_deck_shaft_mount_for_AD.ipt, lower_deck_shaft_mount_for_AD.stp, lower_deck_shaft_mount_printing.ipt, lower_deck_shaft_mount_printing.stl, lower_deck_short_shaft_mount_for_AD.ipt, lower_deck_short_shaft_mount_for_AD.stp, upper_deck_shaft_mount_for_AD.ipt]
2018-01-15 długi element podtrzymujący osie + STLe do wydruku
    [wheel_support.ipt, wheel_support.stl, wheel_support.stp, wheel_support_extra_short.ipt, wheel_support_extra_short.stp]
2018-01-16 częściowy placement - praca w toku
    [ie-track-kit-pwr-1.PrjPcb]
2018-01-17 spore zmiany mechaniki + wrzucenie jej na PCB
    [lower_deck_shaft_mount_printing.ipt, lower_deck_shaft_mount_printing_inna_plaszczyzna_jako_baza.ipt, lower_deck_shaft_mount_printing_inna_plaszczyzna_jako_baza.stl, lower_deck_shaft_mount_v2_printing.ipt, lower_deck_shaft_mount_v2_printing.stl, lower_deck_shaft_mount_v2_printing_inna_plaszczyzna_jako_baza.ipt, lower_deck_shaft_mount_v2_printing_inna_plaszczyzna_jako_baza.stl, lower_deck_shaft_mou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]
2018-01-17 inne położenie pierwszej (przedniej) śruby + wersja lewego supportu bez jednej śruby (brak tam otworu na PCB) - tylko STEPy, bez wersji STL
    [wheel_support_v3_left_narrow_with_line_sensor.stp, wheel_support_v3_narrow_with_line_sensor.ipt, wheel_support_v3_narrow_with_line_sensor_all_holes.ipt, wheel_support_v3_right_narrow_with_line_sensor.stp]
2018-01-17 wersja krótsza o kolejne 2,5mm, poprawki dot. podłączenia czujnika linii (bezpośrednio na piny, do sprawdzenia), nowe modele 3D, wersja do próbnego wykonania na frezarce
    [ie-track-kit-pwr-1.PrjPcb, lights.SchDoc]
2018-01-18 delikatne zmiany mechaniki + kilka zmienionych pozycji elementów na PCB
    [wheel_support_v3_narrow_with_line_sensor_all_holes.ipt, wheel_support_v4_left_narrow_with_line_sensor.stl, wheel_support_v4_left_narrow_with_line_sensor.stp, wheel_support_v4_narrow_with_line_sensor.ipt, wheel_support_v4_narrow_with_line_sensor_all_holes.ipt, wheel_support_v4_right_narrow_with_line_sensor.stl, wheel_support_v4_right_narrow_with_line_sensor.stp]
2018-01-23 powolny routing płytki
    [lights.SchDoc]
2018-01-24 poprawki czujnika linii (źle powiązane wyprowadzenia schematu z footprintem) oraz dalszy routing
    [lights.SchDoc]
2018-01-26 re-annotation + porawki routingu wraz z wylaniem nowych POLYGONów
    [battery_protection.SchDoc, lights.SchDoc, main_connector.SchDoc]
2018-01-31 zredukowana liczba wierceń + drigg guide obok PCB
    [power.SchDoc]
2018-01-31 porządki na schematach
    [lights.SchDoc, motor_drivers.SchDoc, power.SchDoc]
2018-01-31 braz zmian merytorycznych - dodany szablon IE do projektu (otwory mechaniczne przeniesione na Block Diagram)
    [[01] - COVER PAGE.SchDoc, [02] - REVISION HISTORY.SchDoc, [03] - BLOCK DIAGRAM.SchDoc, [04] - BATTERIES WITH PROTECTION.SchDoc, [05] - POWER.SchDoc, [06] - MOTOR DRIVERS.SchDoc, [07] - LIGHTS.SchDoc, [08] - MAIN CONNECTOR.SchDoc]
2018-02-13 dodatki (uzupełnienia) na PCB: regulowanie napięcia silników, test pointy dla napięć zasilających + pomysł na diodę sygnalizującą niski stan baterii + dodatkowe holdery na baterje 18650 (KEYSTONE 54)
    [[04] - BATTERIES WITH PROTECTION.SchDoc, [05] - POWER.SchDoc]
2018-02-13 kolejna wersja elementów mechanicznych - zbliżone otwory na frontowym supporcie pierwszej osi + konsekwencje na dolnym elemencie
    [lower_deck_shaft_mount_v4_printing.ipt, wheel_support_v5_narrow_with_line_sensor_all_holes.ipt]
2018-02-13 elementy 3D na PCB + pliki wykonawcze STL i STEP
    [[04] - BATTERIES WITH PROTECTION.SchDoc, [07] - LIGHTS.SchDoc, lower_deck_shaft_mount_v4_for_AD.ipt, lower_deck_shaft_mount_v4_for_AD.stp, lower_deck_shaft_mount_v4_for_AD_m.stp, lower_deck_shaft_mount_v4_printing.ipt, lower_deck_shaft_mount_v4_printing.stl, wheel_support_v5_left_narrow_with_line_sensor.stl]
2018-02-13 obwód detekcji działania zabezpieczenia under-voltage z diodą sygnalizacyjną + porządki na schematach (re-annotation, parametry i designatory na Verdana, 8pt, bold)
    [[04] - BATTERIES WITH PROTECTION.SchDoc, [05] - POWER.SchDoc, [06] - MOTOR DRIVERS.SchDoc, [07] - LIGHTS.SchDoc, [08] - MAIN CONNECTOR.SchDoc, ie-track-kit-pwr-1.PrjPcb]
2018-02-13 nowe parametry na schematach (dane projektu) + prawidłowo położone modele 3D na PCB
    [[01] - COVER PAGE.SchDoc, [02] - REVISION HISTORY.SchDoc, [03] - BLOCK DIAGRAM.SchDoc, [04] - BATTERIES WITH PROTECTION.SchDoc, [05] - POWER.SchDoc, [06] - MOTOR DRIVERS.SchDoc, [07] - LIGHTS.SchDoc, [08] - MAIN CONNECTOR.SchDoc]
2018-02-15 zmiana opisu diod LED - do przedyskutowania
    [[04] - BATTERIES WITH PROTECTION.SchDoc, ie-track-kit-pwr-1.PrjPcb]
2018-02-16 podciągnięty routing po ostatnich zmianach / dodatkach
    [[04] - BATTERIES WITH PROTECTION.SchDoc, [05] - POWER.SchDoc]
2018-02-20 dodatkowa dioda sygnalizująca zasilanie na warstwie TOP + routing (poza punktami testowymi)
    [[05] - POWER.SchDoc]
2018-02-20 dodatkowy test point na 7V2 i proponowane miejsce ich umieszczenia
    [[05] - POWER.SchDoc]
2018-02-21 routing płytki z punktami testowymi napięć + poprawki ROOMs i DRC
    [ie-track-kit-pwr-1.PrjPcb]
2018-02-26 update routingu po zmianach footprintu uchwytów baterii
2018-03-02 modified multivibrator circuit - tested
    [[04] - BATTERIES WITH PROTECTION.SchDoc, __ie-track-kit-pwr-1.PrjPcb]
2018-03-02 zakończony routing - do dodania opis (logo BAZEKO) + poprawki po kilku dniach
    [[04] - BATTERIES WITH PROTECTION.SchDoc]
2018-03-03 dodatkowy rezystor przy diodzie infomrującej o problemach z baterią
    możliwość włączenia diody na stałe, bez trybu mrugania
    [[04] - BATTERIES WITH PROTECTION.SchDoc]
2018-03-06 reannotation, designator corrections
    [[04] - BATTERIES WITH PROTECTION.SchDoc, [05] - POWER.SchDoc, [07] - LIGHTS.SchDoc, [08] - MAIN CONNECTOR.SchDoc, ie-track-kit-pwr-1.PrjPcb]
2018-03-06 + and - icons for batteries corrected, variant updated
    [[05] - POWER.SchDoc, ie-track-kit-pwr-1.PrjPcb]
2018-03-07 logotypes re-arranged, kit ID number added, reayd to be send
    [ie-track-kit-pwr-1, v1.2.DRL, ie-track-kit-pwr-1, v1.2.GBL, ie-track-kit-pwr-1, v1.2.GBO, ie-track-kit-pwr-1, v1.2.GBP, ie-track-kit-pwr-1, v1.2.GBS, ie-track-kit-pwr-1, v1.2.GKO, ie-track-kit-pwr-1, v1.2.GTL, ie-track-kit-pwr-1, v1.2.GTO]
2018-03-28 ostaatnie poprawki po akceptacji TME, pliki produkcyjne dla BaZeKo + zdjęcia
    [ie-track-kit-pwr-1, v1.2.DRL, ie-track-kit-pwr-1, v1.2.GBL, ie-track-kit-pwr-1, v1.2.GBO, ie-track-kit-pwr-1, v1.2.GBP, ie-track-kit-pwr-1, v1.2.GBS, ie-track-kit-pwr-1, v1.2.GKO, ie-track-kit-pwr-1, v1.2.GTL, ie-track-kit-pwr-1, v1.2.GTO]
2018-03-29 płytka po korektach - rozszerzone po 0,1mm na boki oraz 0,3mm na pród i tył
    [ie-track-kit-pwr-1, v1.2.xls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]
2018-06-29 powoli i nieśmiało zaczynany update górnego pokładu dla ARDUINO
2018-07-10 komplet el. mechanicznych - do wydruków u KK
    [lower_deck_shaft_mount_for_AD.ipt, lower_deck_shaft_mount_for_AD.stp, lower_deck_shaft_mount_printing.ipt, lower_deck_shaft_mount_printing.stl, lower_deck_shaft_mount_printing_inna_plaszczyzna_jako_baza.ipt, lower_deck_shaft_mount_printing_inna_plaszczyzna_jako_baza.stl, lower_deck_shaft_mount_v2_printing.ipt, lower_deck_shaft_mount_v2_printing.stl]
2018-07-10 wariant szyny dolnego pokładu wyższy o 2mm (większe napięcie gąsienic)
    [wheel_support_v5_left_narrow_with_line_sensor_2mm_higher.ipt, wheel_support_v5_left_narrow_with_line_sensor_2mm_higher.stl, wheel_support_v5_narrow_with_line_sensor_all_holes_2mm_higher.ipt, wheel_support_v5_right_narrow_with_line_sensor_2mm_higher.ipt, wheel_support_v5_right_narrow_with_line_sensor_2mm_higher.stl]
2018-07-22 update wartości rezystorów przy LEDach na POWER i prace nad MAIN
    [TamiyaTankArduinoShield.PrjPcb, [07] - LIGHTS.SchDoc, peripherals.SchDoc]
2018-07-23 docelowe wymiary płytki górnej + wymiarowanie w pliku IPT (bez zmian)
    [TamiyaTankArduinoShield.PrjPcb, lower_deck_shaft_mount_v4_printing.ipt]
2018-07-23 -1mm na przodzie płytki górnej - równy nawis z przodu i z tyłu robota
2018-07-23 porządki w plikach projektowych - struktura plików IE
    [TamiyaTankArduinoShield.PrjPcb, [01] - COVER PAGE.SchDoc, [02] - REVISION HISTORY.SchDoc, [03] - BLOCK DIAGRAM.SchDoc, [04] - MAIN.SchDoc, [05] - PERIPHERALS.SchDoc, [06] - COMMUNICATION.SchDoc, bluetooth.SchDoc]
2018-07-23 dodawane peryferia
    [[01] - COVER PAGE.SchDoc, [02] - REVISION HISTORY.SchDoc, [03] - BLOCK DIAGRAM.SchDoc, [04] - MAIN.SchDoc, [05] - PERIPHERALS.SchDoc, [06] - COMMUNICATION.SchDoc, ie-track-kit-arduino-1.PrjPcb]
2018-07-24 porządki...
    [[03] - BLOCK DIAGRAM.SchDoc, [04] - MAIN.SchDoc, [05] - PERIPHERALS.SchDoc, [07] - CONNECTOR.SchDoc, ie-track-kit-arduino-1.PrjPcb]
2018-07-25 dodane schematy dla NUCLEO i ESP32 DEVKIT
    [[01] - COVER PAGE.SchDoc, [03] - BLOCK DIAGRAM.SchDoc, [04] - ARDUINO UNO (MEGA).SchDoc, [04] - MAIN.SchDoc, [05] - NUCLEO.SchDoc, [05] - PERIPHERALS.SchDoc, [06] - COMMUNICATION.SchDoc, [06] - ESP32 DEVKIT.SchDoc]
2018-07-25 dwa komponenty Arduino (UNO i MEGA) - inaczej się raczej nie da...
    [[01] - COVER PAGE.SchDoc, [04] - ARDUINO UNO (MEGA).SchDoc, [05] - NUCLEO.SchDoc, [06] - ESP32 DEVKIT.SchDoc, [07] - PERIPHERALS.SchDoc, [08] - COMMUNICATION.SchDoc, ie-track-kit-arduino-1.PrjPcb]
2018-07-26 postęp prac...
    [[03] - BLOCK DIAGRAM.SchDoc, [04] - ARDUINO UNO (MEGA).SchDoc, [07] - DEBUGGING & PROGRAMMING.SchDoc, [07] - PERIPHERALS.SchDoc, [08] - COMMUNICATION.SchDoc, [08] - PERIPHERALS.SchDoc, [09] - COMMUNICATION.SchDoc, [09] - CONNECTOR.SchDoc]
2018-07-31 2 serwomechanizmy (przód / tył)
    [[08] - PERIPHERALS.SchDoc, [10] - CONNECTOR.SchDoc]
2018-08-01 buzzer i peryferia
    [[08] - PERIPHERALS.SchDoc]
2018-08-01 podłączanie peryferii
    [[04] - ARDUINO UNO (MEGA).SchDoc, [07] - DEBUGGING & PROGRAMMING.SchDoc, [08] - PERIPHERALS.SchDoc, ie-track-kit-arduino-1.PrjPcb]
2018-08-01 diody ws2812 i inne dodatki
    [[03] - BLOCK DIAGRAM.SchDoc, [04] - ARDUINO UNO (MEGA).SchDoc, [07] - DEBUGGING & PROGRAMMING.SchDoc, [08] - PERIPHERALS.SchDoc, [09] - COMMUNICATION.SchDoc, [10] - CONNECTOR.SchDoc]
2018-08-01 dodatkowy arkusz na peryferia + konwersja napięć (dla peryferii 5V i 3V3)
    [[03] - BLOCK DIAGRAM.SchDoc, [07] - DEBUGGING & PROGRAMMING.SchDoc, [08] - PERIPHERALS A.SchDoc, [08] - PERIPHERALS.SchDoc, [09] - COMMUNICATION.SchDoc, [09] - PERIPHERALS B.SchDoc, [10] - COMMUNICATION.SchDoc, [10] - CONNECTOR.SchDoc]
2018-08-02 zaczynamy blokować część peryferiów
    [[04] - ARDUINO UNO (MEGA).SchDoc, [08] - PERIPHERALS A.SchDoc, [09] - PERIPHERALS B.SchDoc, ie-track-kit-arduino-1.PrjPcb]
2018-08-02 dalsze prace...
    [[09] - PERIPHERALS B.SchDoc, [11] - CONNECTOR.SchDoc]
2018-08-03 dalsze prace i porządki
    [[04] - ARDUINO UNO (MEGA).SchDoc, [08] - PERIPHERALS A.SchDoc, [09] - PERIPHERALS B.SchDoc, [11] - CONNECTOR.SchDoc]
2018-08-03 płytka +1cm po długości
    [[07] - DEBUGGING & PROGRAMMING.SchDoc, [08] - PERIPHERALS A.SchDoc, [09] - PERIPHERALS B.SchDoc, [10] - COMMUNICATION.SchDoc, [11] - CONNECTOR.SchDoc]
2018-08-07 poprawki rozmieszczenia po wydłużeniu płyty
    [[04] - ARDUINO UNO (MEGA).SchDoc, [07] - DEBUGGING & PROGRAMMING.SchDoc, ie-track-kit-arduino-1.PrjPcb]
2018-08-07 peryferia z płytki TME (częściowo dodane)
    [[04] - ARDUINO UNO (MEGA).SchDoc, [07] - DEBUGGING & PROGRAMMING.SchDoc, [09] - PERIPHERALS B.SchDoc, [10] - COMMUNICATION.SchDoc, [11] - CONNECTOR.SchDoc]
2018-08-07 dalsze prace
    [[11] - CONNECTOR.SchDoc]
2018-08-09 dalsze prace.
    [[04] - ARDUINO UNO (MEGA).SchDoc, [08] - PERIPHERALS A.SchDoc, [09] - PERIPHERALS B.SchDoc, ie-track-kit-arduino-1.PrjPcb]
2018-08-14 dalsze prace..
    [[03] - BLOCK DIAGRAM.SchDoc, [04] - ARDUINO UNO (MEGA).SchDoc, [08] - PERIPHERALS A.SchDoc, [09] - PERIPHERALS B.SchDoc, [10] - COMMUNICATION.SchDoc, [10] - PERIPHERALS C.SchDoc, [11] - COMMUNICATION.SchDoc, [11] - CONNECTOR.SchDoc]
2018-08-14 routing i opisy
    [[04] - ARDUINO UNO (MEGA).SchDoc, [12] - CONNECTOR.SchDoc]
2018-08-16 placement / rouiting
    [[04] - ARDUINO UNO (MEGA).SchDoc, [07] - DEBUGGING & PROGRAMMING.SchDoc, [08] - PERIPHERALS A.SchDoc, [11] - COMMUNICATION.SchDoc, [12] - CONNECTOR.SchDoc]
2018-08-17 nowy arkusz peripherals
    [[03] - BLOCK DIAGRAM.SchDoc, [08] - PERIPHERALS A.SchDoc, [11] - COMMUNICATION.SchDoc, [11] - PERIPHERALS D.SchDoc, [12] - COMMUNICATION.SchDoc, [12] - CONNECTOR.SchDoc, [13] - CONNECTOR.SchDoc]
2018-08-17 zapis po zamknięciu sesji
    [[11] - PERIPHERALS D.SchDoc, [13] - CONNECTOR.SchDoc, ie-track-kit-arduino-1.PrjPcb]
2018-08-19 hc-sr04 servo mount
    [hc-sr04_servo_mount.ipt, hc-sr04_servo_mount.stl]
2018-08-19 hc-sr094 w uchwycie i dodany STEP dla AD - nowe problemy
    [HC-SR04-UltrasonicSensor v7.ipt, hc-sr04_servo_mount.iam, hc-sr04_servo_mount.ipt, hc-sr04_servo_mount.stp]
2018-08-20 koniec routingu + poprawki opisów - do weryfikacji
    [[04] - ARDUINO UNO (MEGA).SchDoc, [08] - PERIPHERALS A.SchDoc, [09] - PERIPHERALS B.SchDoc, [10] - PERIPHERALS C.SchDoc, [11] - PERIPHERALS D.SchDoc, [13] - CONNECTOR.SchDoc, ie-track-kit-arduino-1.PrjPcb]
2018-08-20 pliki wysłane do produkcji - JLCPCB
    [[11] - PERIPHERALS D.SchDoc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]
2018-08-21 usunięte zbędne modele STEP z PcbDoc
2018-09-11 poprawkie 3V3 na 2V7 (feedback) + zmiana etykiery na schemacie oraz dokumentacja połączenia dolnego i górnego pokładu
    [[03] - BLOCK DIAGRAM.SchDoc, [05] - POWER.SchDoc, [06] - MOTOR DRIVERS.SchDoc, [07] - LIGHTS.SchDoc, [08] - MAIN CONNECTOR.SchDoc, hc-sr04_servo_mount.iam, ie-track-kit-pwr-1.PrjPcb, upper_deck_shaft_mount_printing.stl]
2018-09-19 update elementów feedback
    [[13] - CONNECTOR.SchDoc]
2018-09-20 zamiana rezystorów przy LEDach, początek poprawek wynikających z uruchomienia
    [[05] - POWER.SchDoc, [13] - CONNECTOR.SchDoc]
2018-09-20 korekty w trakcie uruchamiania
    [[07] - DEBUGGING & PROGRAMMING.SchDoc, [13] - CONNECTOR.SchDoc]
2018-09-24 poprawki w czasie uruchamiania wersji prototypowej
    [[04] - ARDUINO UNO (MEGA).SchDoc, [07] - DEBUGGING & PROGRAMMING.SchDoc, [08] - PERIPHERALS A.SchDoc, [09] - PERIPHERALS B.SchDoc, [10] - PERIPHERALS C.SchDoc, [11] - PERIPHERALS D.SchDoc]
2018-09-25 update płytki
    [[04] - ARDUINO UNO (MEGA).SchDoc, [07] - DEBUGGING & PROGRAMMING.SchDoc, [08] - PERIPHERALS A.SchDoc, [09] - PERIPHERALS B.SchDoc, [10] - PERIPHERALS C.SchDoc, [11] - PERIPHERALS D.SchDoc, ie-track-kit-arduino-1.PrjPcb]
2018-09-26 opisy i poprawki routingu
    [[10] - PERIPHERALS C.SchDoc]
2018-09-27 reannotacja + ikony/opisy
    [[04] - ARDUINO UNO (MEGA).SchDoc, [07] - DEBUGGING & PROGRAMMING.SchDoc, [08] - PERIPHERALS A.SchDoc, [09] - PERIPHERALS B.SchDoc, [10] - PERIPHERALS C.SchDoc, [11] - PERIPHERALS D.SchDoc, [12] - COMMUNICATION.SchDoc, [13] - CONNECTOR.SchDoc]
2018-09-27 wersja 1.1 wysłana do JLCPCB - produkcja + szablon
    [ie-track-kit-arduino-1, v1.0.DRL, ie-track-kit-arduino-1, v1.0.GBL, ie-track-kit-arduino-1, v1.0.GBO, ie-track-kit-arduino-1, v1.0.GBP, ie-track-kit-arduino-1, v1.0.GBS, ie-track-kit-arduino-1, v1.0.GKO, ie-track-kit-arduino-1, v1.0.GTL, ie-track-kit-arduino-1, v1.0.GTO]
2018-10-10 dalsze poprawki / optymalizacje z montażu
    [[05] - POWER.SchDoc, [07] - LIGHTS.SchDoc]
2018-10-26 update wartości elementów i poprawki po montaży serii 8 sztuk (ŁUD)
    [[04] - ARDUINO UNO (MEGA).SchDoc, [07] - DEBUGGING & PROGRAMMING.SchDoc, [08] - PERIPHERALS A.SchDoc, [09] - PERIPHERALS B.SchDoc, [11] - PERIPHERALS D.SchDoc, [13] - CONNECTOR.SchDoc, ie-track-kit-arduino-1.PrjPcb, ie-track-kit-arduino-1_v11.xls]
2018-10-29 update - projekt
    [ie-track-kit-arduino-1.PrjPcb]
2019-03-15 prace na potrzeby artykułu KKE 2019
    [3mm shaft.ipt, Assem1.iam, Assem1_1-58.stp, Assem1_1-58_wheels.stp, DG_brass_gap4.0.ipt, DG_gold_brass.ipt, DG_purple_8_mtr.ipt, DG_shaft_23mm.ipt]
2019-03-21 drawing z wymiarowaniem - KKE2019
    [ie-track-kit-drawing.idw]
2019-03-26 porządki w dokumentacji - dla RS i na potrzeby KKE2019
    [[01] - COVER PAGE.SchDoc, [02] - REVISION HISTORY.SchDoc, [03] - BLOCK DIAGRAM.SchDoc, [04] - ARDUINO UNO (MEGA).SchDoc, [04] - BATTERIES WITH PROTECTION.SchDoc, [05] - DEBUGGING & PROGRAMMING.SchDoc, [05] - NUCLEO.SchDoc, [06] - ESP32 DEVKIT.SchDoc]
2019-03-26 ujednolicanie etykiet, poprawki różne - dokumentacja płyty z ARDUINO
    [[01] - COVER PAGE.SchDoc, [02] - REVISION HISTORY.SchDoc, [03] - BLOCK DIAGRAM.SchDoc, [04] - ARDUINO UNO (MEGA).SchDoc, [05] - DEBUGGING & PROGRAMMING.SchDoc, [06] - PERIPHERALS A.SchDoc, [07] - PERIPHERALS B.SchDoc, [08] - PERIPHERALS C.SchDoc]
